marcospreafico/clas12Tags/ftOff.png

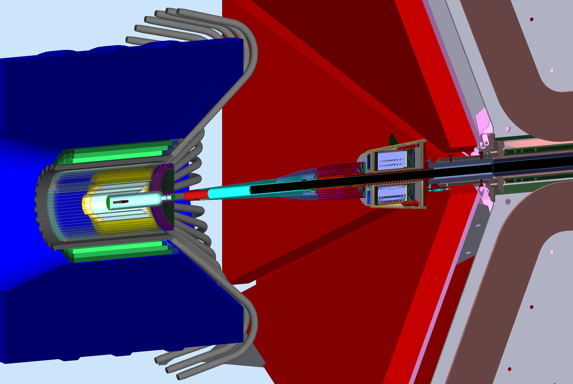
ftOff.png
