marcospreafico/clas12Tags/geometry_source/beamline/cad/torus_to_apex.png

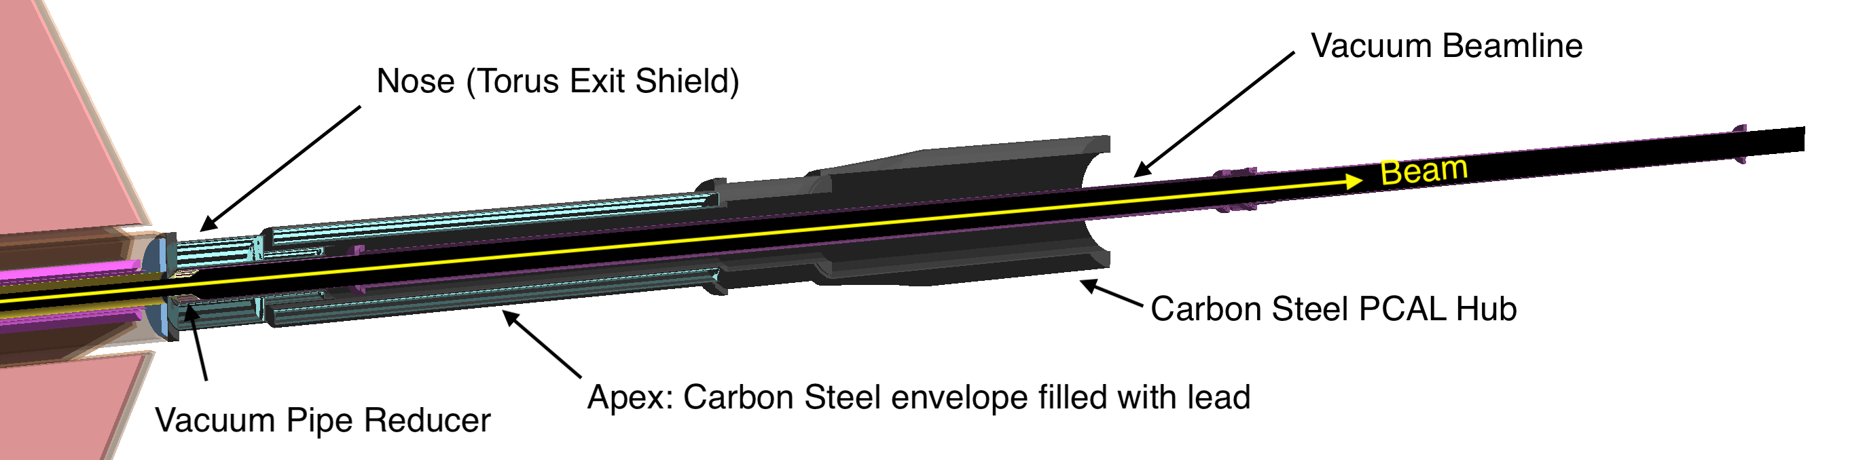
geometry_source/beamline/cad/torus_to_apex.png
