marcospreafico/clas12Tags/geometry_source/ltcc/docs/img/ltcc_mods.jpg

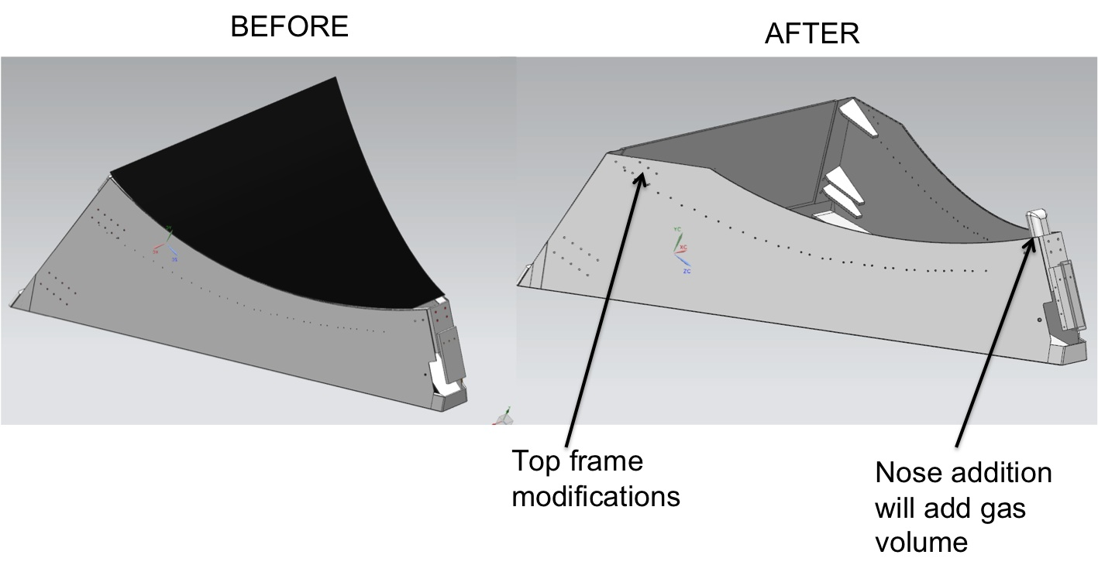
geometry_source/ltcc/docs/img/ltcc_mods.jpg
