marcospreafico/clas12Tags/geometry_source/ltcc/docs/img/photon_yield_gasc4f10_mirrorecis_pmtqtz.jpg

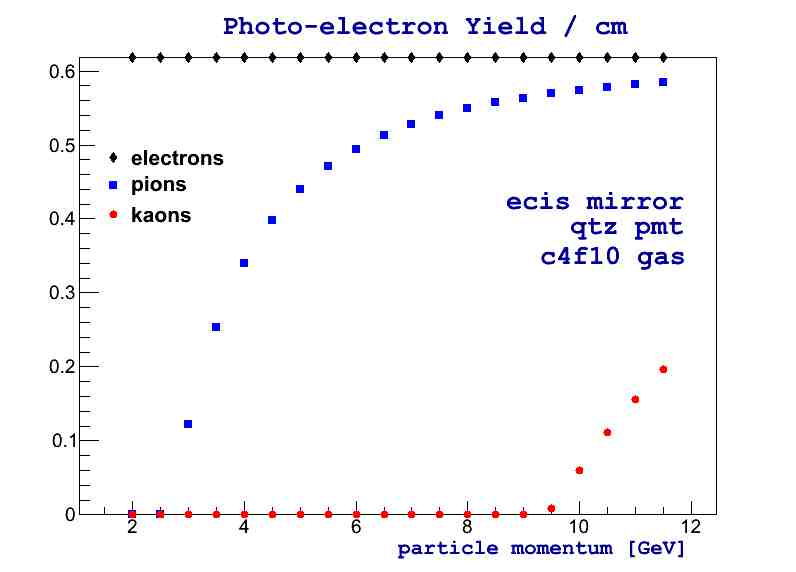
geometry_source/ltcc/docs/img/photon_yield_gasc4f10_mirrorecis_pmtqtz.jpg
