marcospreafico/clas12Tags/geometry_source/ltcc/docs/img/photon_yield_ratios_pion_gasc4f10_mirrorecis_pmtqtz.jpg

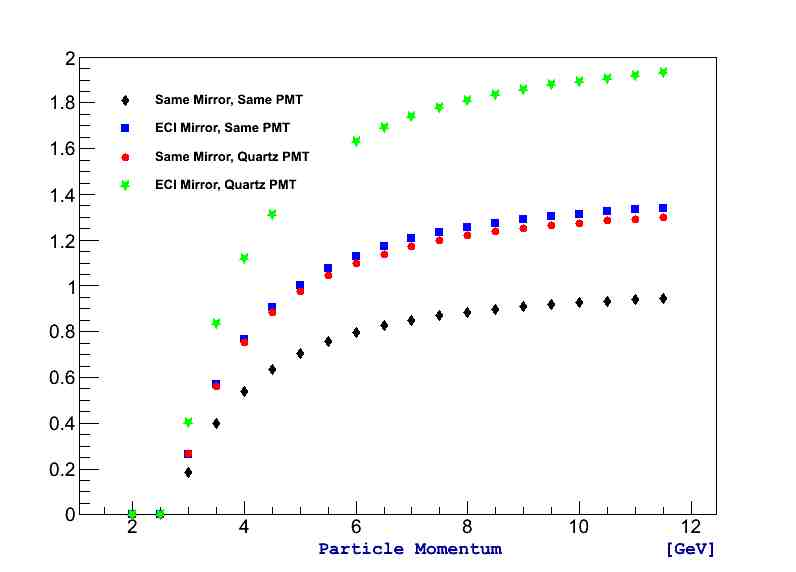
geometry_source/ltcc/docs/img/photon_yield_ratios_pion_gasc4f10_mirrorecis_pmtqtz.jpg
