marcospreafico/clas12Tags/geometry_source/ltcc/docs/img/photon_yield_spectrum_electron_gasc4f10_mirrorltcc_pmtuvg2.jpg

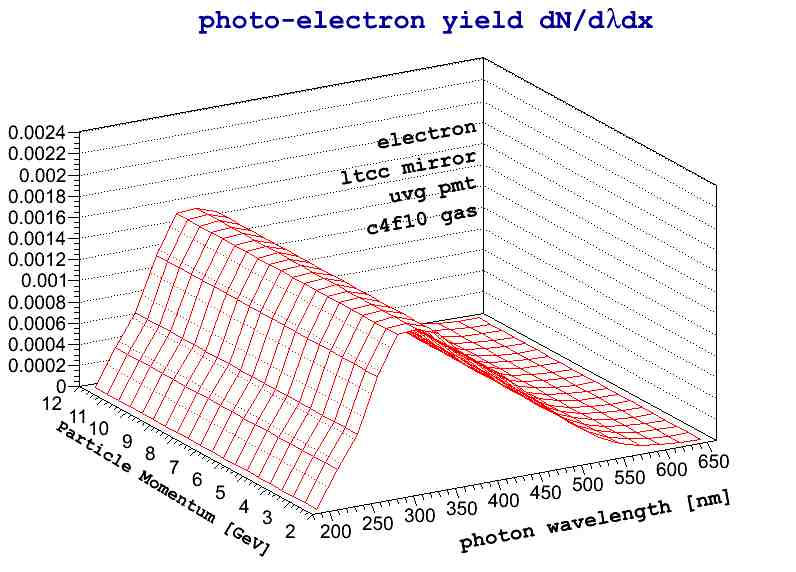
geometry_source/ltcc/docs/img/photon_yield_spectrum_electron_gasc4f10_mirrorltcc_pmtuvg2.jpg
