marcospreafico/clas12Tags/geometry_source/ltcc/docs/img/photon_yield_spectrum_electron_gasperfect_mirrorperfect_pmtperfect.jpg

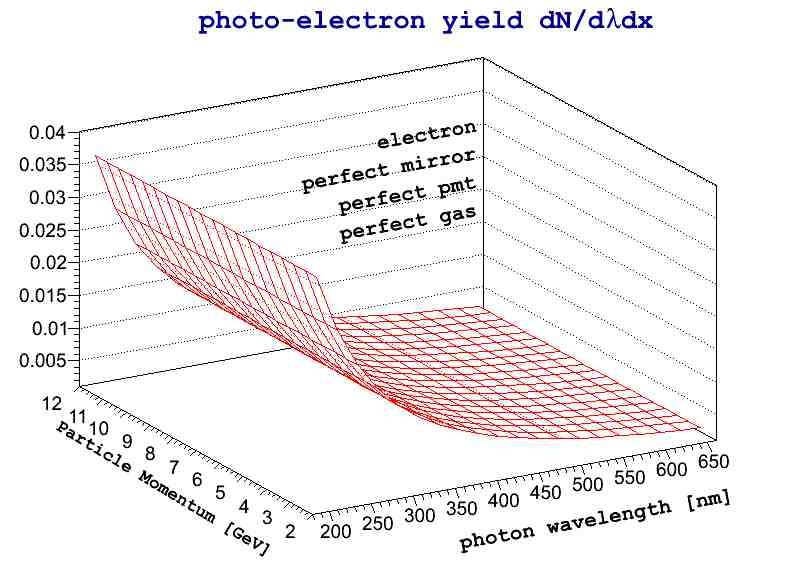
geometry_source/ltcc/docs/img/photon_yield_spectrum_electron_gasperfect_mirrorperfect_pmtperfect.jpg
