marcospreafico/clas12Tags/geometry_source/ltcc/docs/img/photon_yield_spectrum_pion_gasc4f10_mirrorecis_pmtuvg.jpg

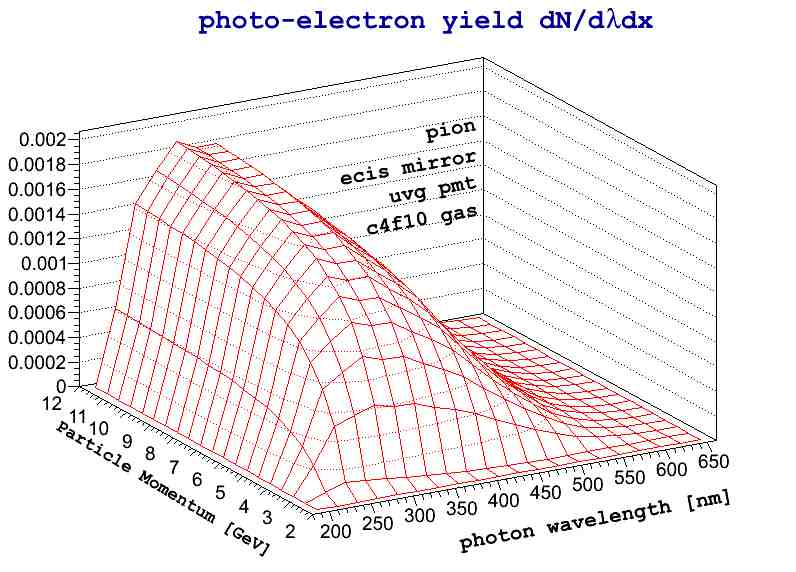
geometry_source/ltcc/docs/img/photon_yield_spectrum_pion_gasc4f10_mirrorecis_pmtuvg.jpg
