marcospreafico/clas12Tags/geometry_source/ltcc/docs/img/photon_yield_spectrum_pion_gasperfect_mirrorperfect_pmtperfect.jpg

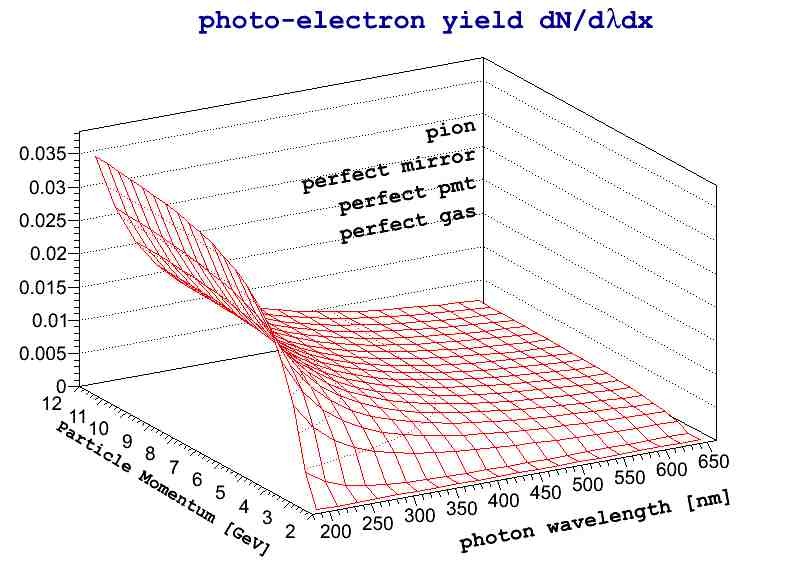
geometry_source/ltcc/docs/img/photon_yield_spectrum_pion_gasperfect_mirrorperfect_pmtperfect.jpg
