marcospreafico/clas12Tags/geometry_source/ltcc/docs/img/quantum_efficiency.jpg

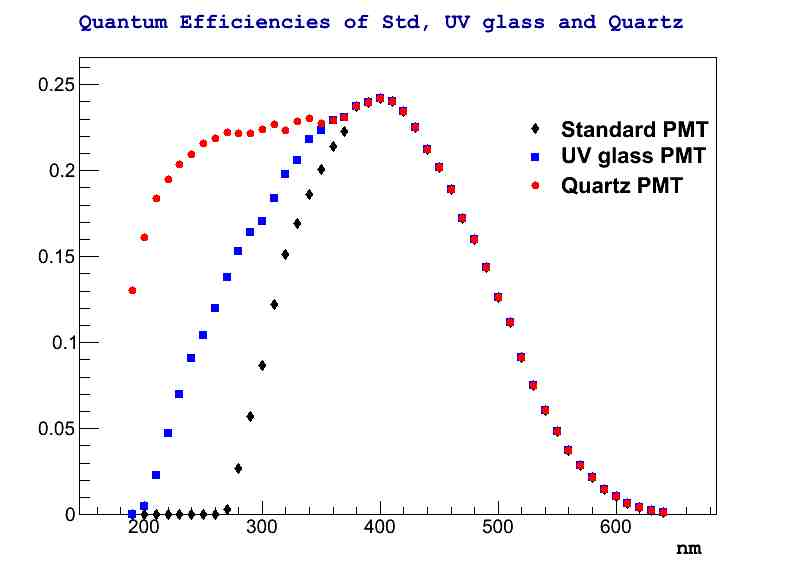
geometry_source/ltcc/docs/img/quantum_efficiency.jpg
