marcospreafico/clas12Tags/geometry_source/ltcc/docs/img/reflectivity.jpg

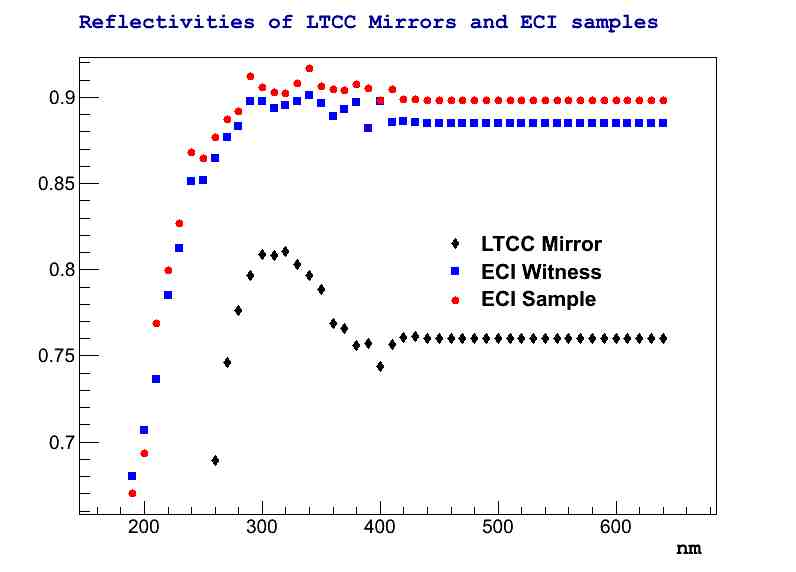
geometry_source/ltcc/docs/img/reflectivity.jpg
