marcospreafico/clas12Tags/geometry_source/ltcc/docs/img/refraction_index.jpg

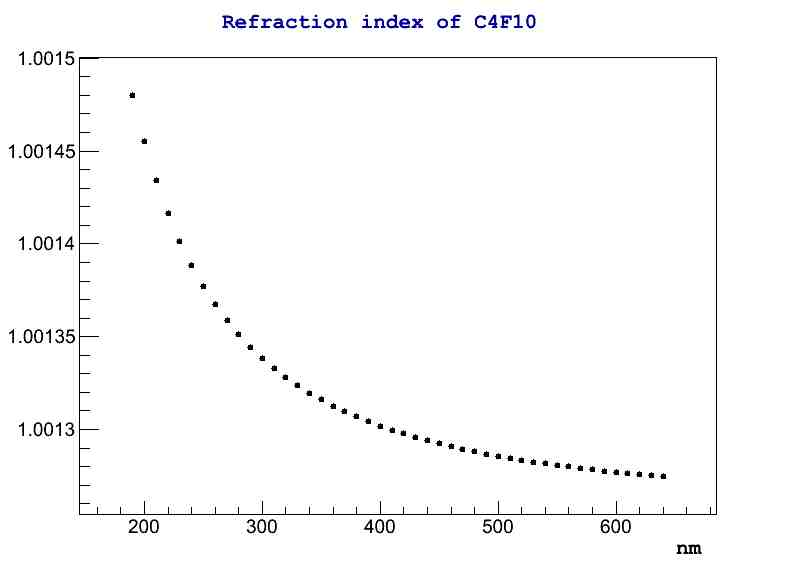
geometry_source/ltcc/docs/img/refraction_index.jpg
