marcospreafico/clas12Tags/geometry_source/ltcc/docs/img/window_addition_gain.jpg

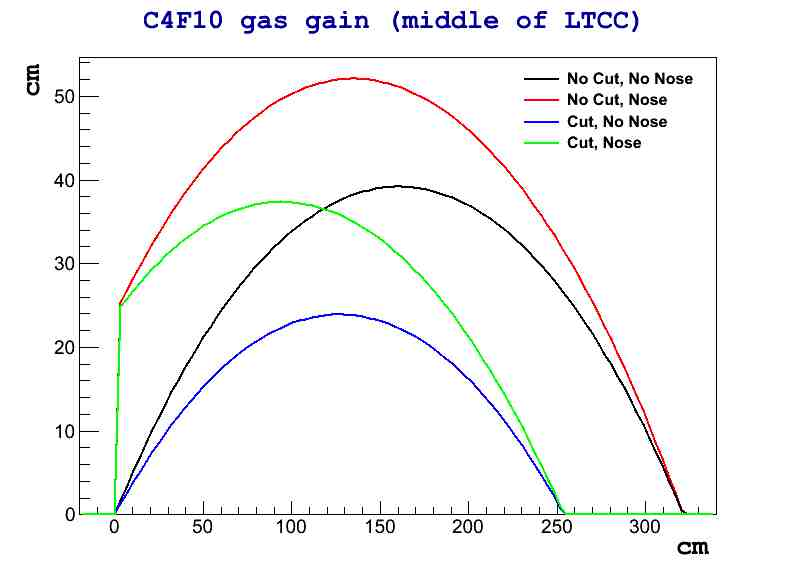
geometry_source/ltcc/docs/img/window_addition_gain.jpg
