marcospreafico/clas12Tags/geometry_source/targets/windows.png

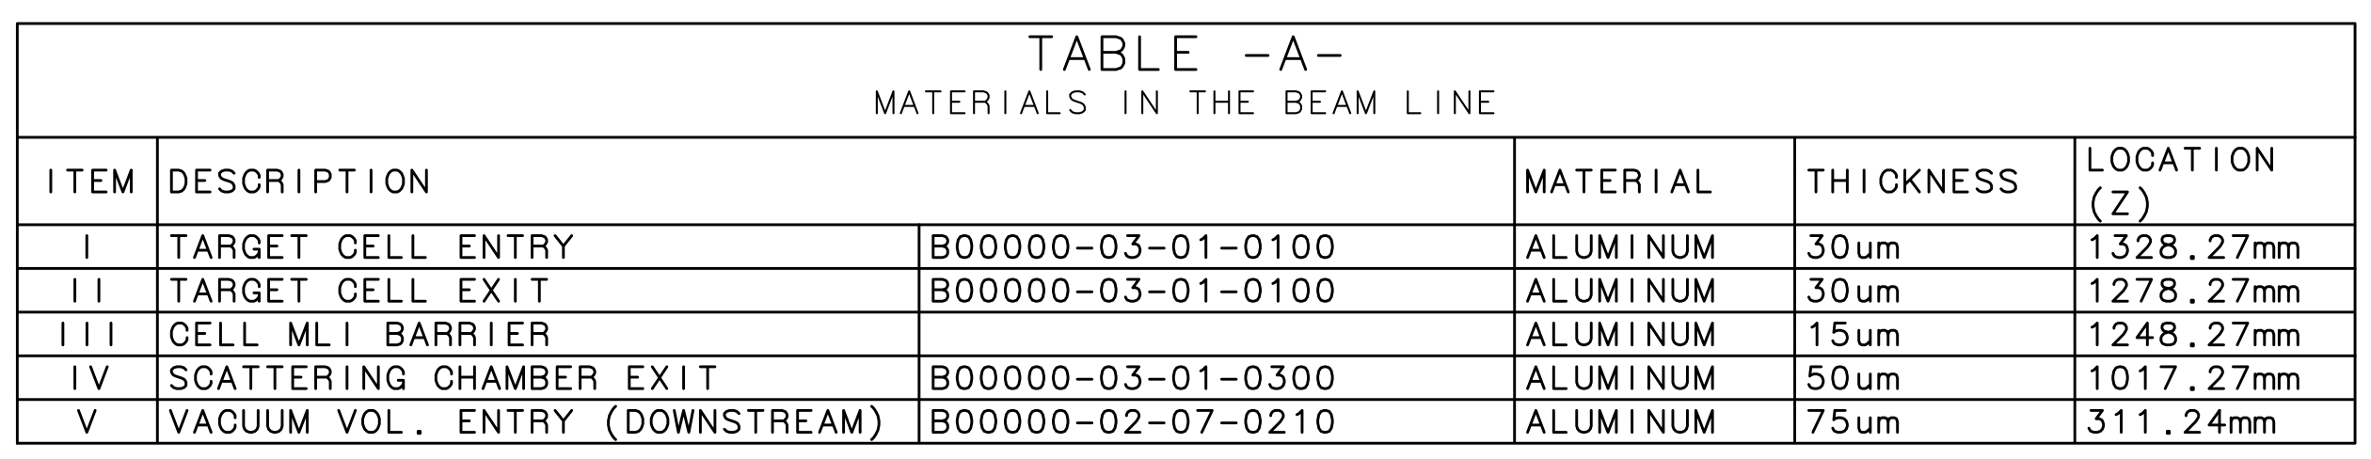
geometry_source/targets/windows.png
