marcospreafico/clas12Tags/geometry_source/targets/cad_rgd/eg2p_main_rode.stl

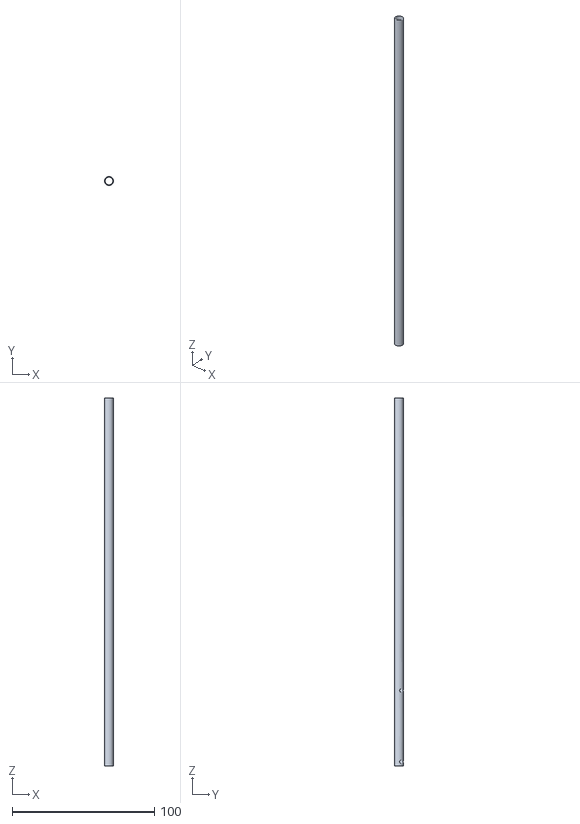
[picture p28: CAD file, 2024-06-17]
geometry_source/targets/cad_rgd/eg2p_main_rode.stl
6.35 x 6.35 x 258.4
