marcospreafico/clas12Tags/geometry_source/beamline/cad/flange-assembly.stl

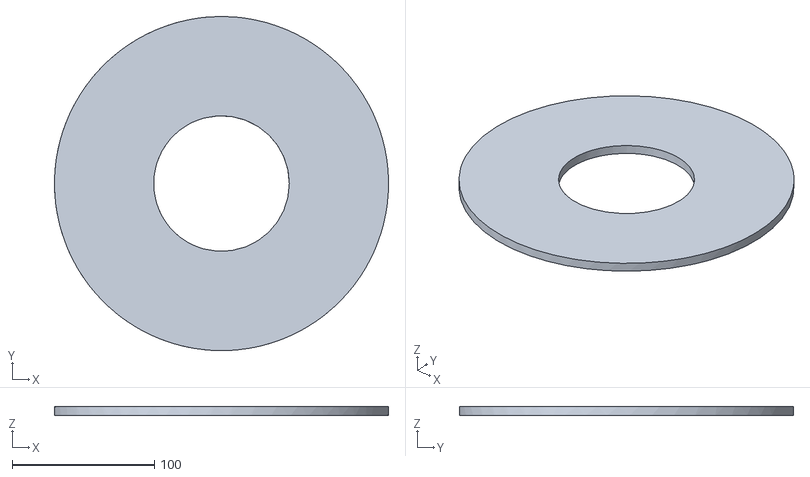
[picture p29: CAD file, 2023-02-14]
geometry_source/beamline/cad/flange-assembly.stl
234.7 x 234.7 x 6.35
