marcospreafico/clas12Tags/geometry_source/beamline/cad/outer-assembly.stl

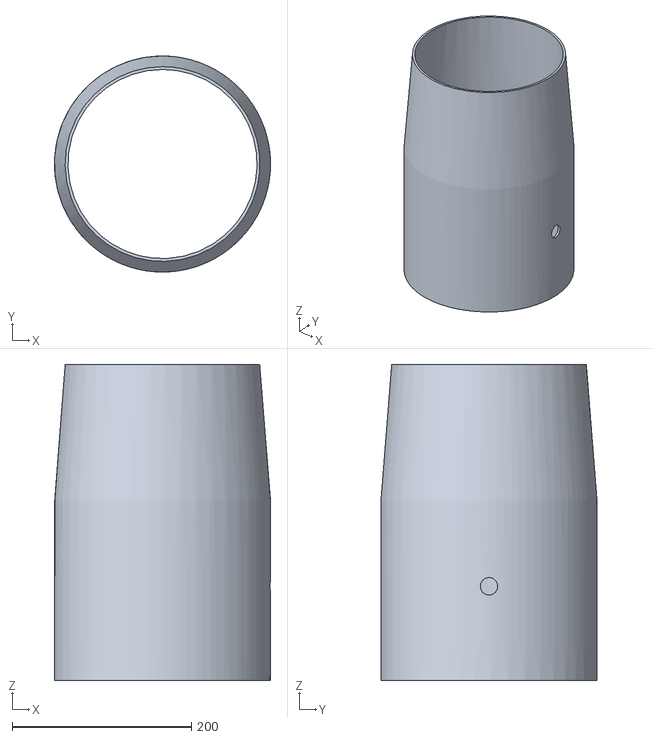
[picture p30: CAD file, 2023-02-14]
geometry_source/beamline/cad/outer-assembly.stl
241.1 x 241.1 x 352.5
