marcospreafico/clas12Tags/geometry_source/beamline/cad/main-cone.stl

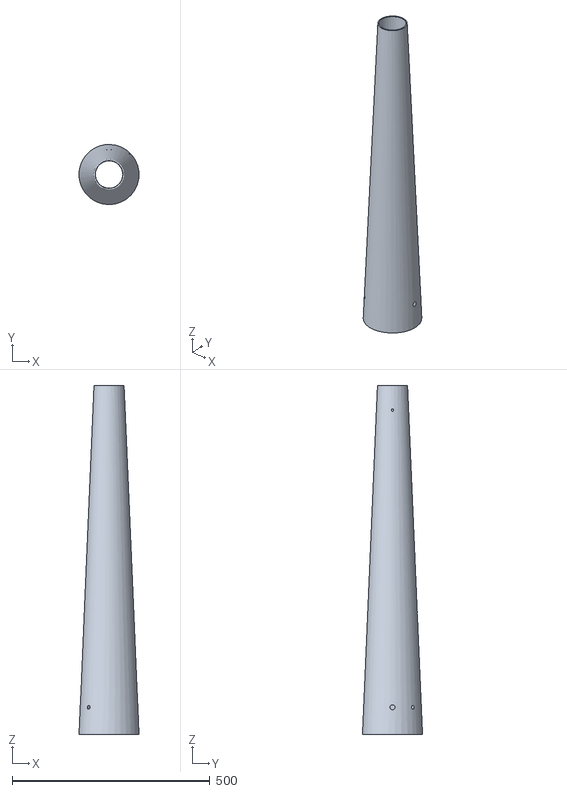
[picture p31: CAD file, 2023-02-14]
geometry_source/beamline/cad/main-cone.stl
151.9 x 152.1 x 882.6
