marcospreafico/clas12Tags/geometry_source/beamline/cad/inner-assembly.stl

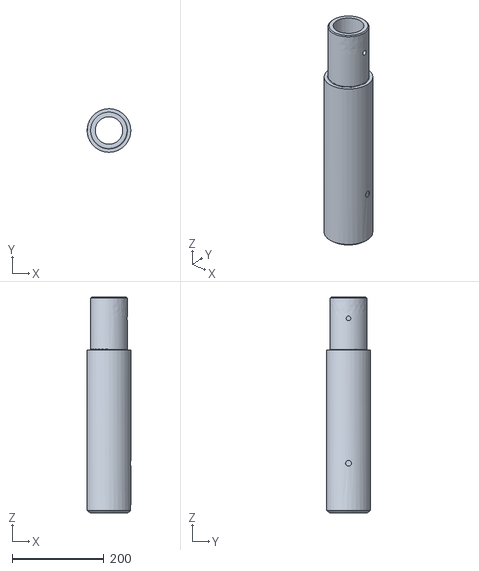
[picture p32: CAD file, 2023-02-14]
geometry_source/beamline/cad/inner-assembly.stl
95.2 x 95.2 x 471.0
