marcospreafico/clas12Tags/experiments/atlas/cad/LargeOuterWheel.stl

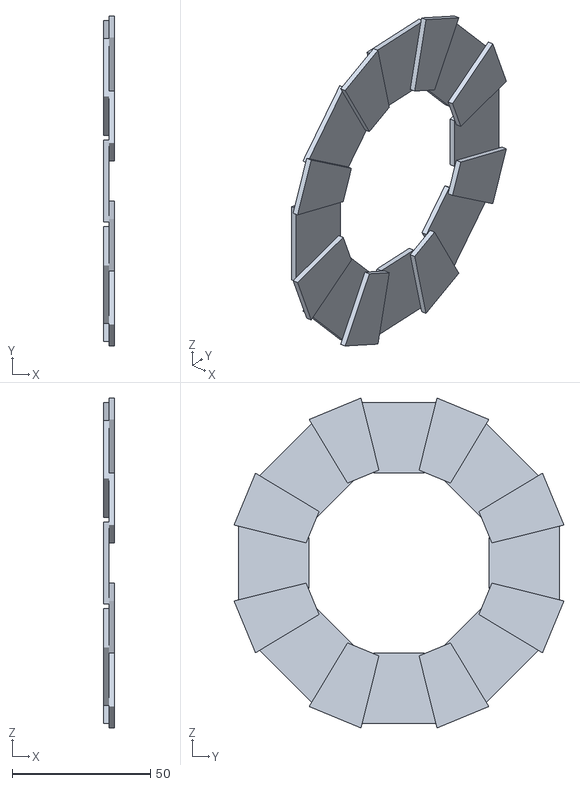
[picture p33: CAD file, 2023-02-14]
experiments/atlas/cad/LargeOuterWheel.stl
4.00 x 119.3 x 119.3
