marcospreafico/clas12Tags/experiments/clas12/ctof/cad/lgd21.stl

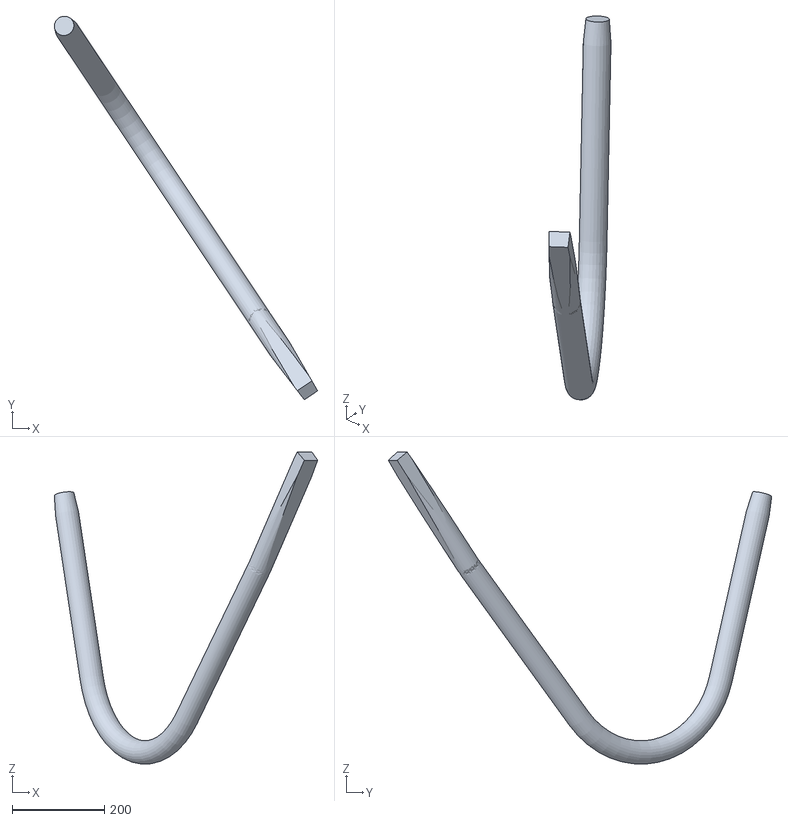
[picture p34: CAD file, 2023-02-14]
experiments/clas12/ctof/cad/lgd21.stl
571.5 x 832.3 x 677.2
