marcospreafico/clas12Tags/experiments/clas12/ctof/cad_upstream/lgu44.stl

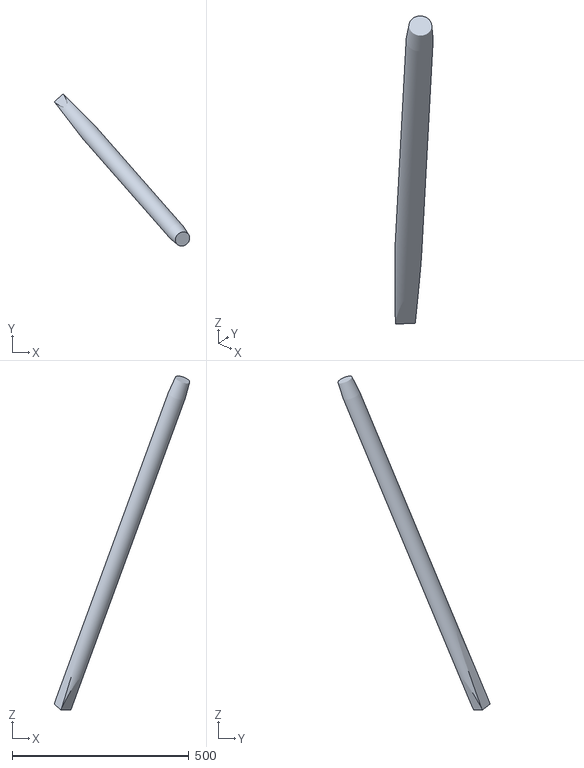
[picture p35: CAD file, 2023-02-14]
experiments/clas12/ctof/cad_upstream/lgu44.stl
383.6 x 430.8 x 945.6
