marcospreafico/clas12Tags/experiments/clas12/rich/cad/Aluminum_m2.stl

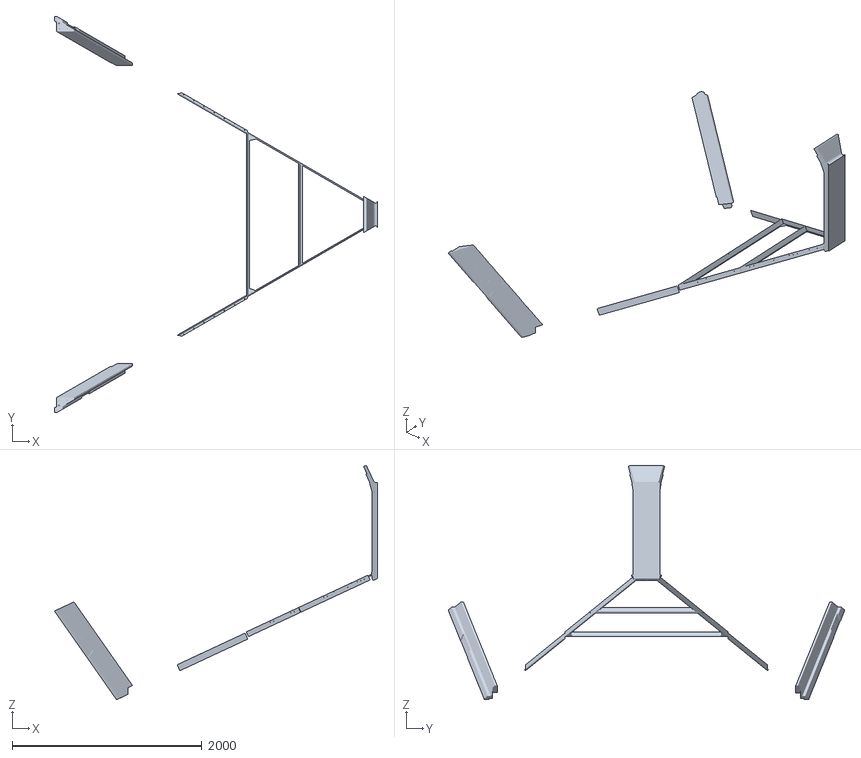
[picture p36: CAD file, 2024-01-29]
experiments/clas12/rich/cad/Aluminum_m2.stl
3408.2 x 4174.8 x 2471.6
