marcospreafico/clas12Tags/experiments/clas12/targets/cad_longitudinal/he3.stl

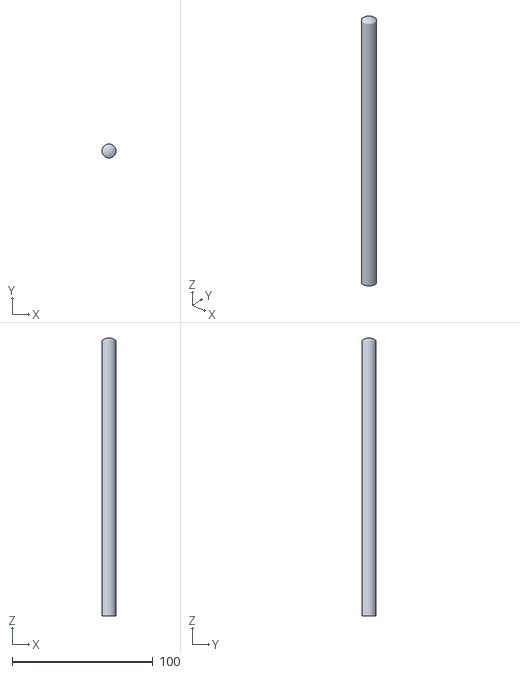
[picture p37: CAD file, 2023-02-14]
experiments/clas12/targets/cad_longitudinal/he3.stl
10.0 x 9.98 x 197.5
