marcospreafico/clas12Tags/experiments/forFun/cad/truck.stl

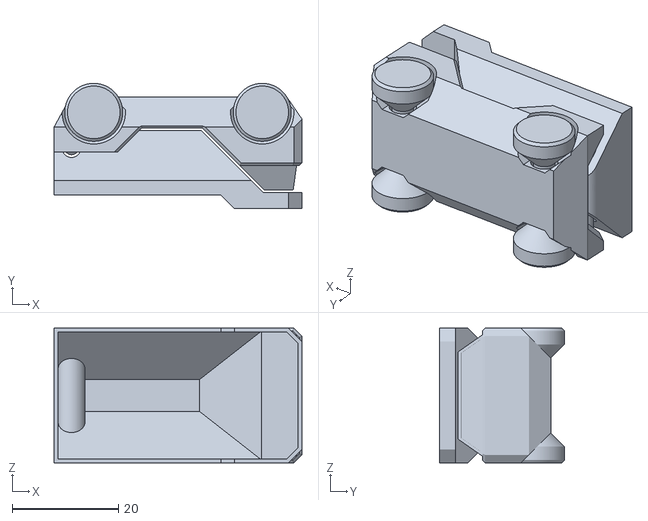
[picture p38: CAD file, 2023-02-14]
experiments/forFun/cad/truck.stl
46.7 x 23.6 x 25.4
