marcospreafico/clas12Tags/experiments/humanBody/cad/Upper_GI.stl

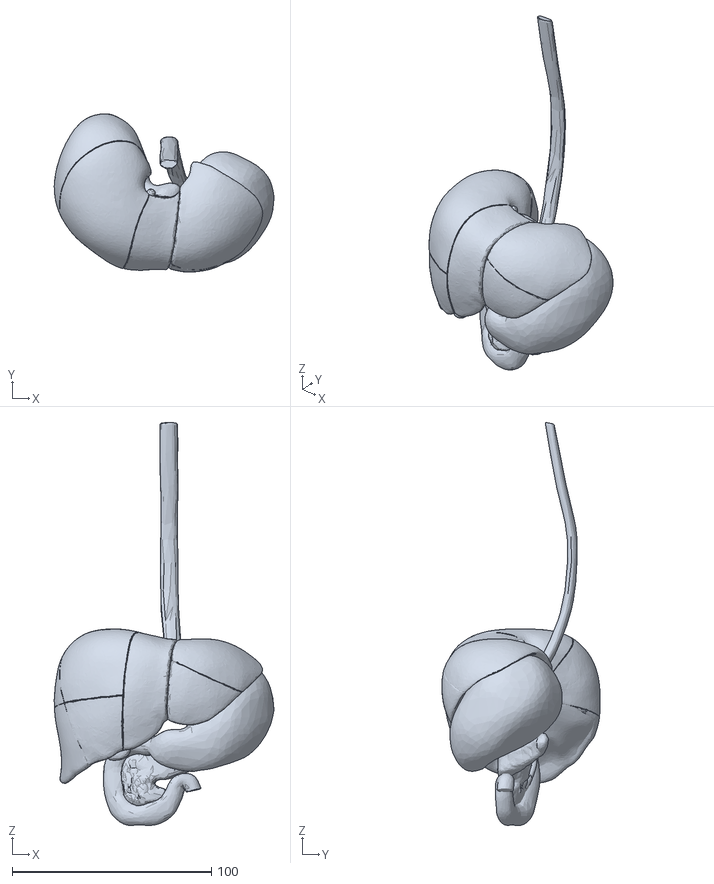
[picture p39: CAD file, 2023-02-14]
experiments/humanBody/cad/Upper_GI.stl
110.3 x 79.5 x 202.4
