marcospreafico/clas12Tags/geometry_source/beamline/cad/Downstream_Beam_tube_Segment_2.stl

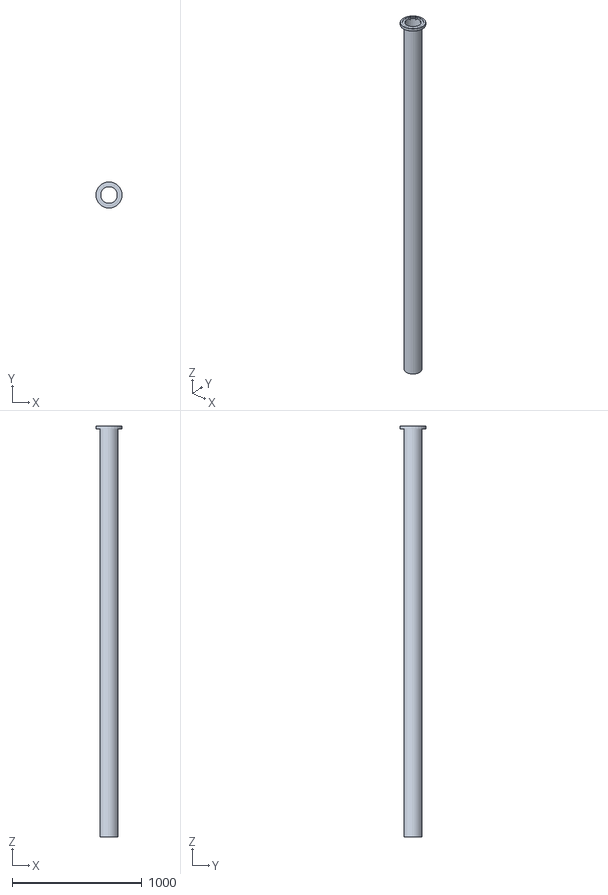
[picture p40: CAD file, 2024-09-16]
geometry_source/beamline/cad/Downstream_Beam_tube_Segment_2.stl
201.4 x 201.4 x 3172.5
