marcospreafico/clas12Tags/geometry_source/beamline/cad_transverse/forwardWedges/TGT-9000-1000-0001m.stl

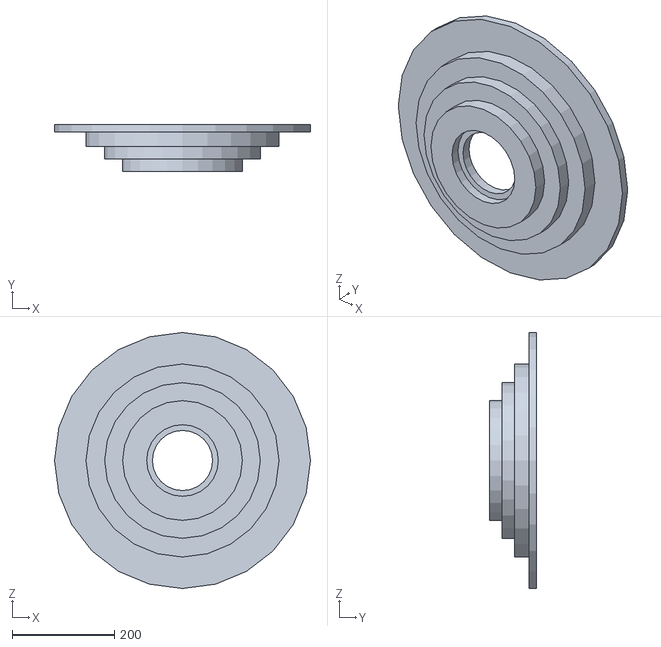
[picture p41: CAD file, 2024-09-16]
geometry_source/beamline/cad_transverse/forwardWedges/TGT-9000-1000-0001m.stl
500.0 x 92.0 x 500.0
