marcospreafico/clas12Tags/geometry_source/beamline/cad_transverse/midpointWedges/TGT-9000-1000-0000m.stl

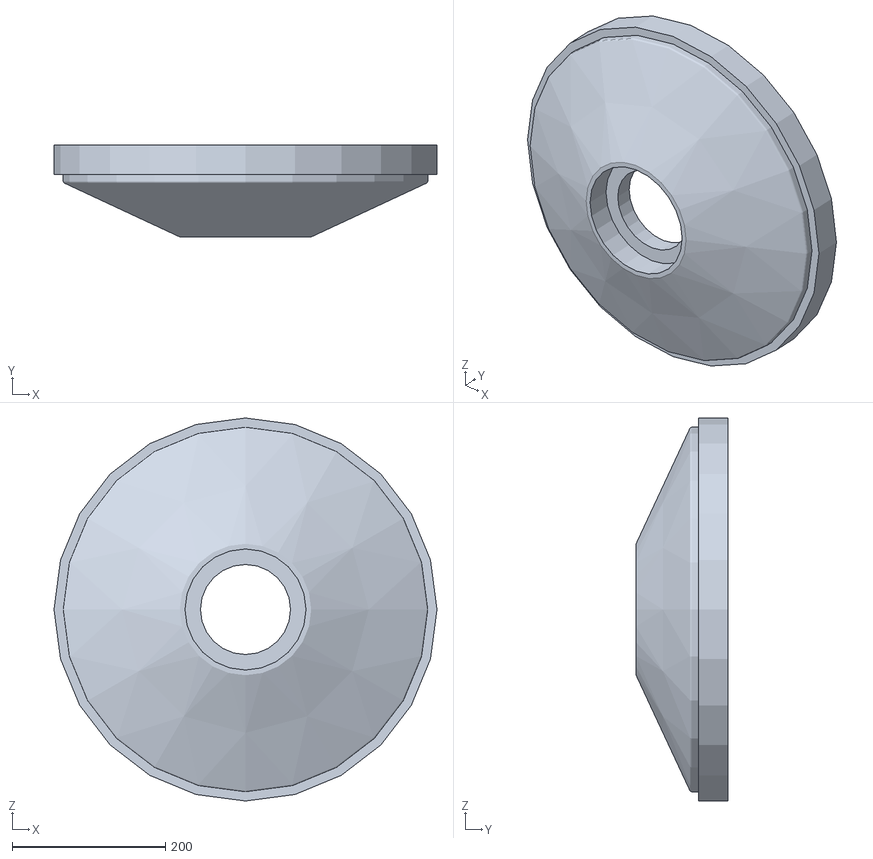
[picture p42: CAD file, 2024-09-16]
geometry_source/beamline/cad_transverse/midpointWedges/TGT-9000-1000-0000m.stl
500.0 x 120.0 x 500.0
