marcospreafico/clas12Tags/geometry_source/beamline/cad_transverse/noWedges/TransverseMagnetNoWedges.stp

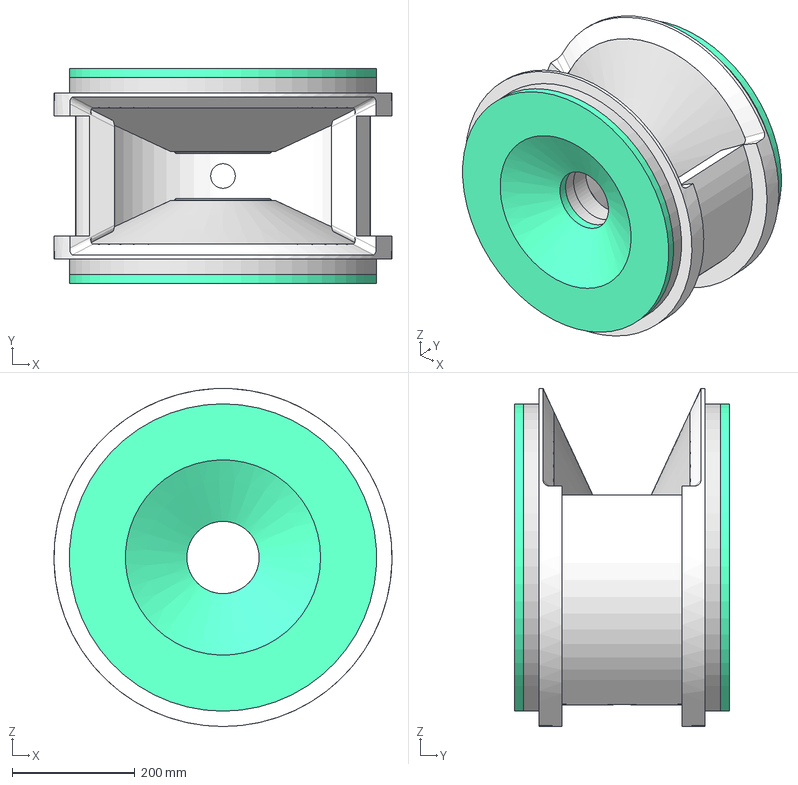
[picture p43: CAD file, 2024-09-16]
geometry_source/beamline/cad_transverse/noWedges/TransverseMagnetNoWedges.stp
549.9 x 350.0 x 550.0 mm
TGT-9000-1000-0000
TGT-9000-1000-0001
TGT-9000-1000-0002
TGT-9000-1000-0003
TGT-9000-1000-0000_MIR
TGT-9000-1000-0001_MIR1
TGT-9000-1000-0002_MIR1
