marcospreafico/clas12Tags/geometry_source/ddvcs/cad/ddvcs_cal.FCStd

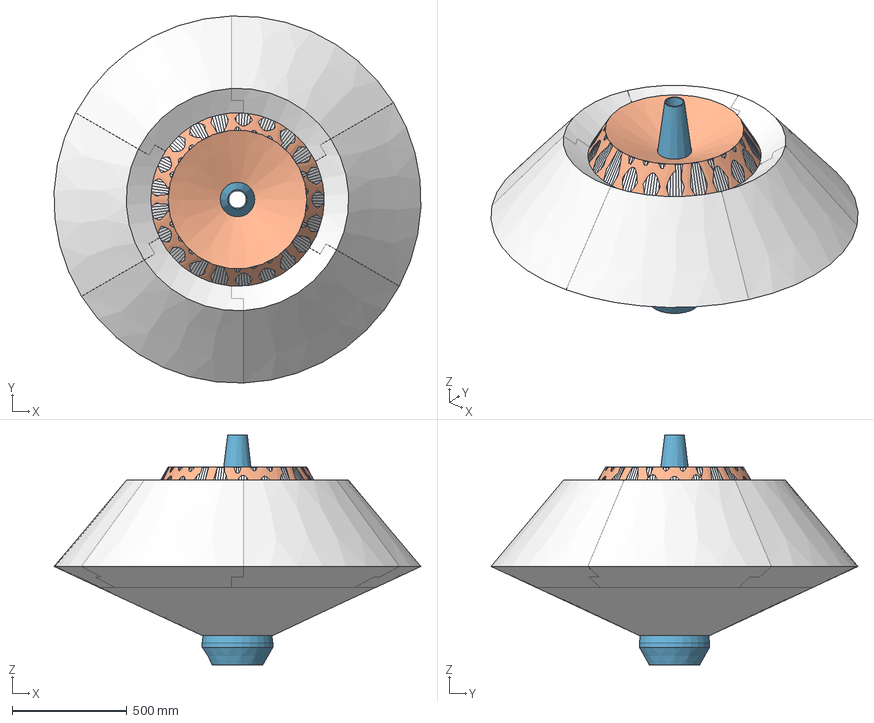
[picture p44: CAD file, 2023-02-24]
geometry_source/ddvcs/cad/ddvcs_cal.FCStd
1595.6 x 1596.3 x 998.3 mm
layout_calorimeter
crystal_array_four
crystal_segment_three
crystal_segment_two
crystal_segment_one
crystal_segment_one001
crystal_segment_one002
crystal_segment_one003
crystal_segment_one004
crystal_segment_one005
crystal_segment_one006
crystal_segment_one007
crystal_segment_one008
crystal_segment_one009
crystal_segment_one010
crystal_segment_one011
crystal_segment_one012
crystal_segment_one013
crystal_segment_one014
crystal_segment_one015
crystal_segment_one016
crystal_segment_one017
crystal_segment_one018
crystal_segment_one019
crystal_segment_one020
crystal_segment_one021
crystal_segment_one022
crystal_segment_one023
crystal_segment_one024
crystal_segment_one025
crystal_segment_one026
crystal_segment_one027
crystal_segment_one028
crystal_segment_one029
crystal_segment_one030
crystal_segment_one031
crystal_segment_one032
crystal_segment_one033
crystal_segment_one034
crystal_segment_one035
crystal_segment_one036
crystal_segment_one037
crystal_segment_one038
crystal_segment_one039
crystal_segment_one040
crystal_segment_one041
crystal_segment_one042
crystal_segment_one043
crystal_segment_one044
crystal_segment_one045
crystal_segment_one046
crystal_segment_one047
crystal_segment_one048
crystal_segment_one049
crystal_segment_one050
crystal_segment_one051
crystal_segment_one052
crystal_segment_one053
crystal_segment_one054
crystal_segment_one055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
