marcospreafico/clas12Tags/geometry_source/htcc/cad/htccCone.stl

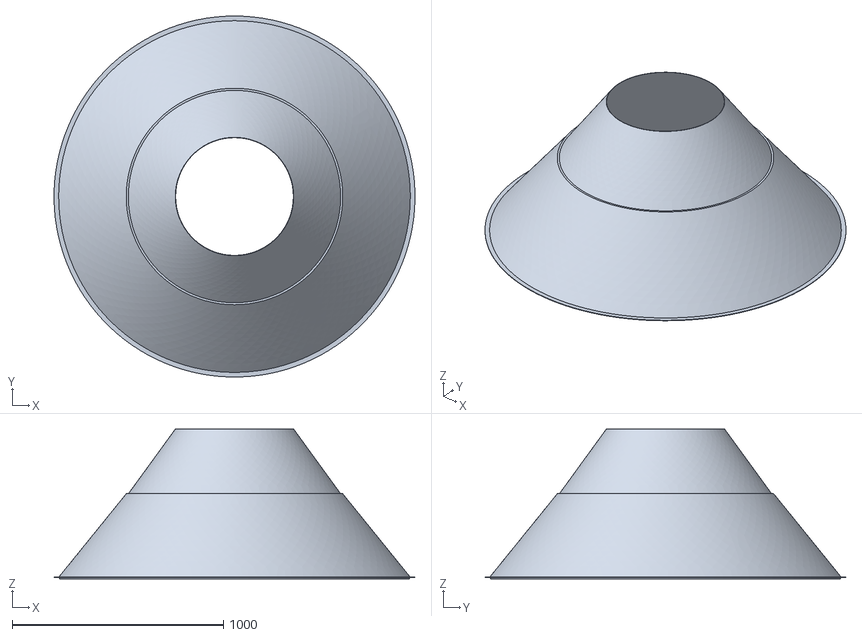
[picture p45: CAD file, 2023-02-14]
geometry_source/htcc/cad/htccCone.stl
1708.0 x 1707.9 x 708.9
