marcospreafico/clas12Tags/geometry_source/ltcc/cad/WC_S.stl

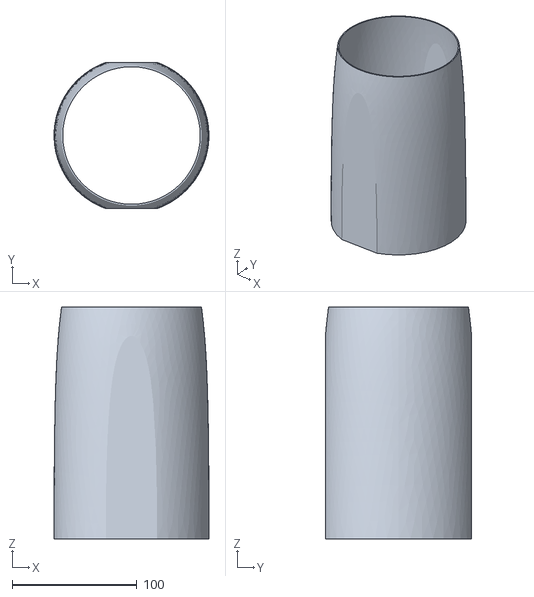
[picture p46: CAD file, 2023-02-14]
geometry_source/ltcc/cad/WC_S.stl
124.0 x 117.0 x 185.6
