marcospreafico/clas12Tags/geometry_source/ltcc/cadTempRemoved/NFrame.stl

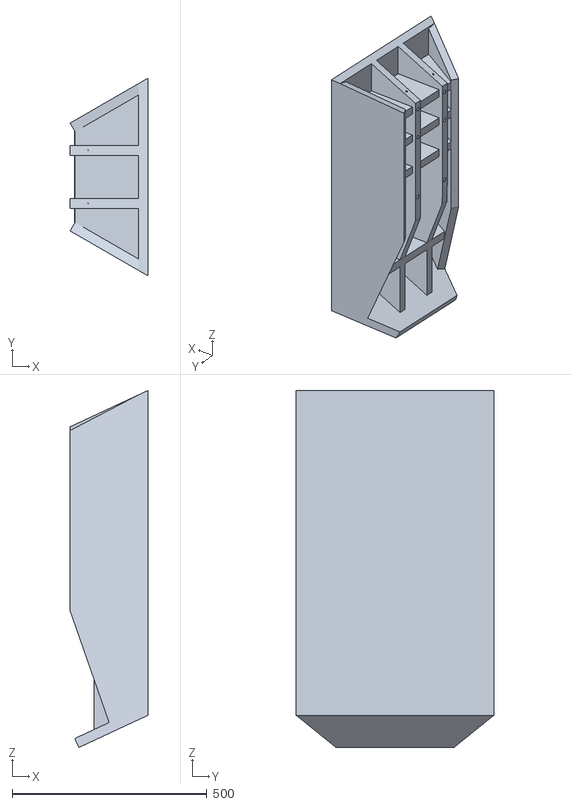
[picture p47: CAD file, 2023-02-14]
geometry_source/ltcc/cadTempRemoved/NFrame.stl
199.9 x 508.0 x 917.7
