marcospreafico/clas12Tags/geometry_source/magnets/cad/UpstreamVacuumJacket.stl

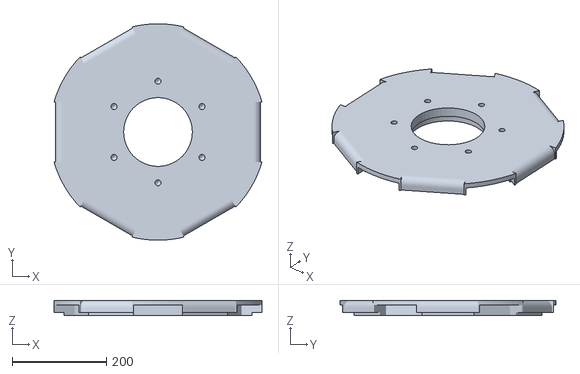
[picture p48: CAD file, 2023-02-14]
geometry_source/magnets/cad/UpstreamVacuumJacket.stl
442.1 x 459.8 x 31.8
