marcospreafico/clas12Tags/geometry_source/targets/cad/scatteringChamber.stl

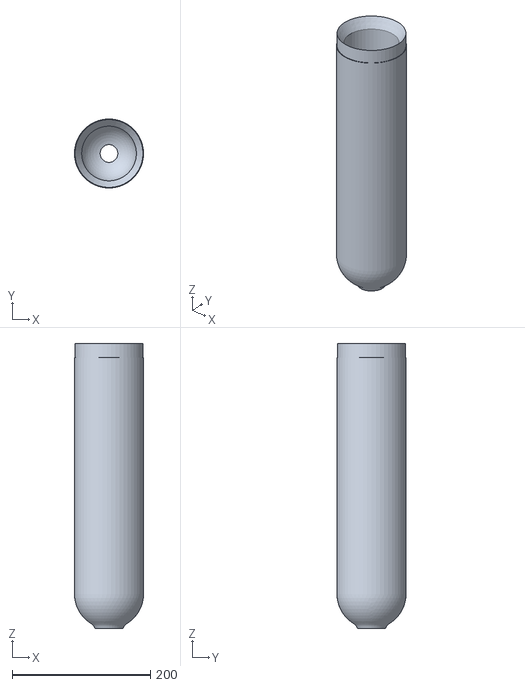
[picture p49: CAD file, 2023-02-14]
geometry_source/targets/cad/scatteringChamber.stl
100.0 x 99.8 x 412.4
