marcospreafico/clas12Tags/geometry_source/targets/cad_extended/TargetAlWindowD.stl

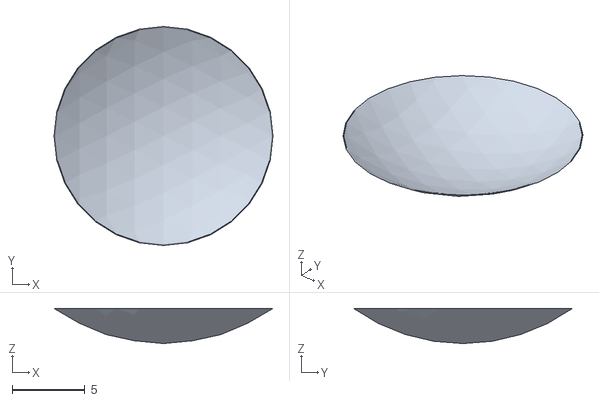
[picture p50: CAD file, 2023-02-14]
geometry_source/targets/cad_extended/TargetAlWindowD.stl
15.1 x 15.1 x 2.41
