marcospreafico/clas12Tags/geometry_source/targets/cad_hdice/LHeCan_PCTFE.stl

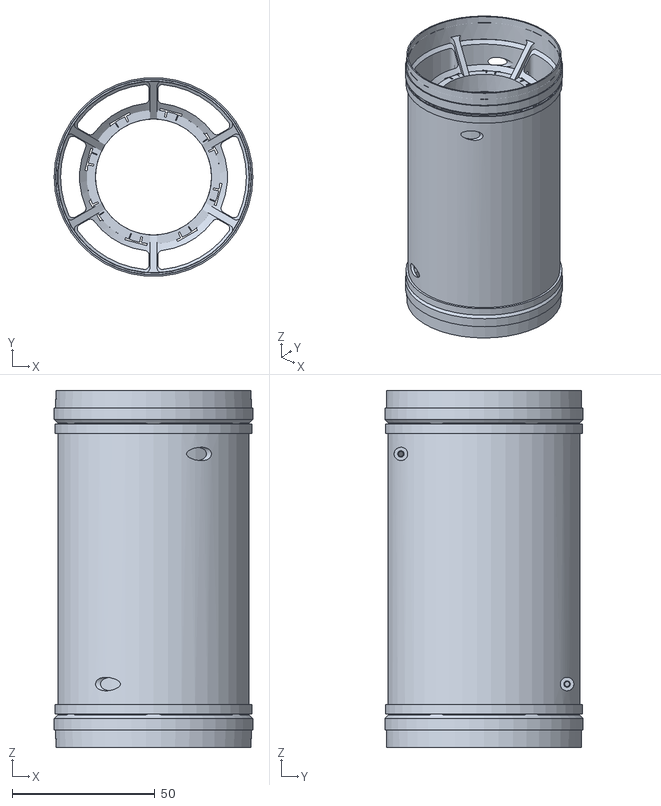
[picture p51: CAD file, 2023-02-14]
geometry_source/targets/cad_hdice/LHeCan_PCTFE.stl
69.6 x 69.4 x 125.0
