marcospreafico/clas12Tags/geometry_source/targets/cad_poltarg/InsertBath_NoVoid_6.stl

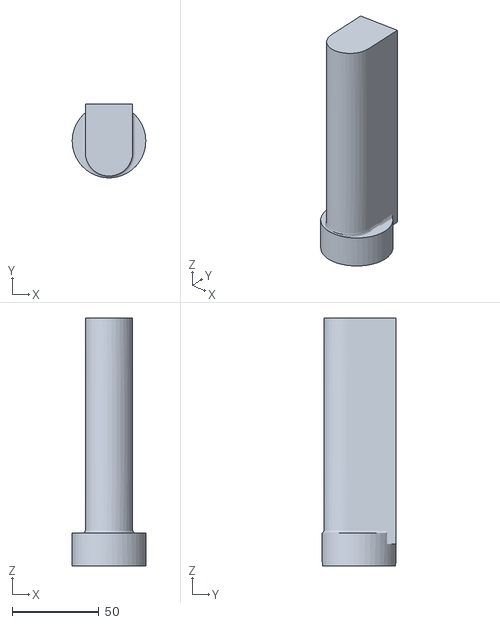
[picture p52: CAD file, 2023-02-14]
geometry_source/targets/cad_poltarg/InsertBath_NoVoid_6.stl
42.6 x 42.6 x 143.3
