marcospreafico/clas12Tags/geometry_source/targets/cad_transverse/InnerRSSheet.stl

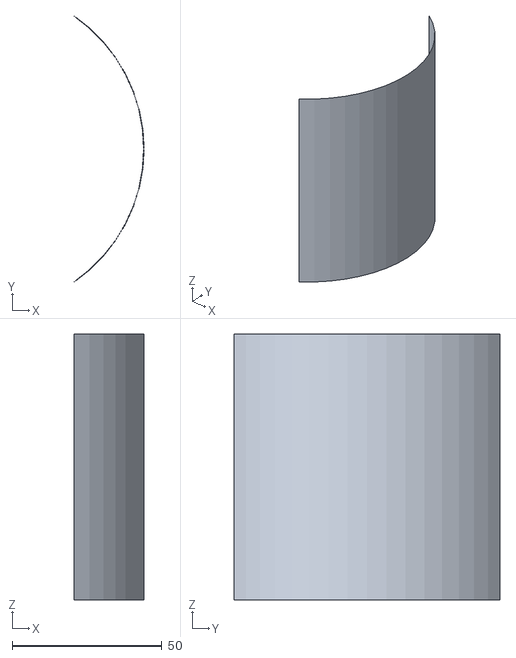
[picture p53: CAD file, 2023-02-14]
geometry_source/targets/cad_transverse/InnerRSSheet.stl
23.4 x 88.9 x 88.9
