marcospreafico/clas12Tags/geometry_source/targets/rge-dt/Al/Tin.stl

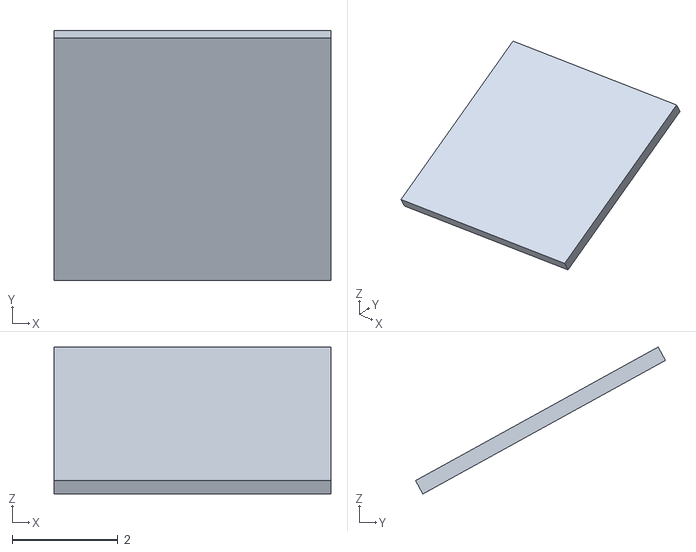
[picture p54: CAD file, 2024-10-23]
geometry_source/targets/rge-dt/Al/Tin.stl
5.25 x 4.74 x 2.79
