marcospreafico/clas12Tags/geometry_source/targets/rge-dt/C/Aluminum.stl

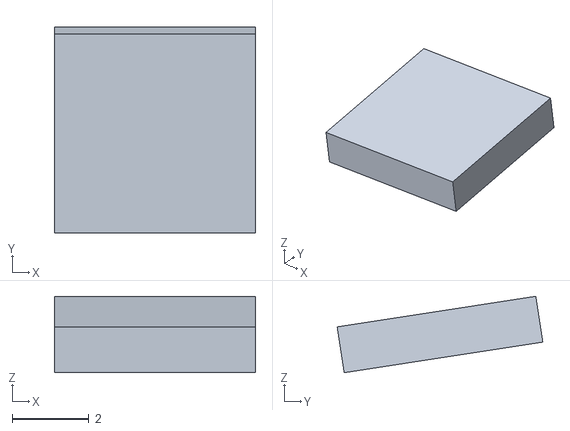
[picture p55: CAD file, 2024-10-23]
geometry_source/targets/rge-dt/C/Aluminum.stl
5.25 x 5.37 x 2.00
