marcospreafico/clas12Tags/geometry_source/targets/rge-dt/common/TargetWallKapton.stl

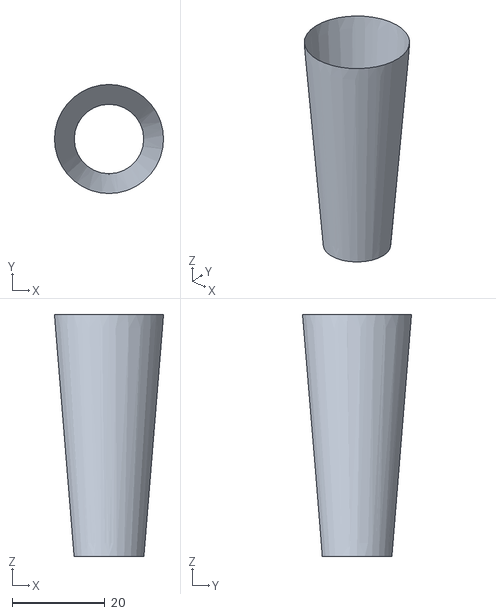
[picture p56: CAD file, 2024-10-23]
geometry_source/targets/rge-dt/common/TargetWallKapton.stl
23.5 x 23.5 x 52.2
