marcospreafico/clas12Tags/geometry_source/targets/rge-dt/Cu/Copper.stl

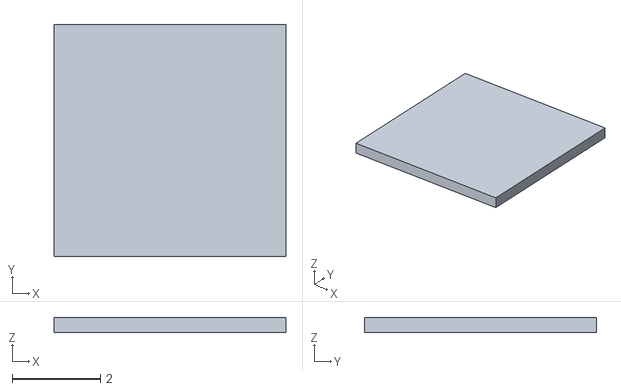
[picture p57: CAD file, 2024-10-23]
geometry_source/targets/rge-dt/Cu/Copper.stl
5.25 x 5.25 x 0.335
