marcospreafico/clas12Tags/geometry_source/targets/rge-dt/Empty/Tin.stl

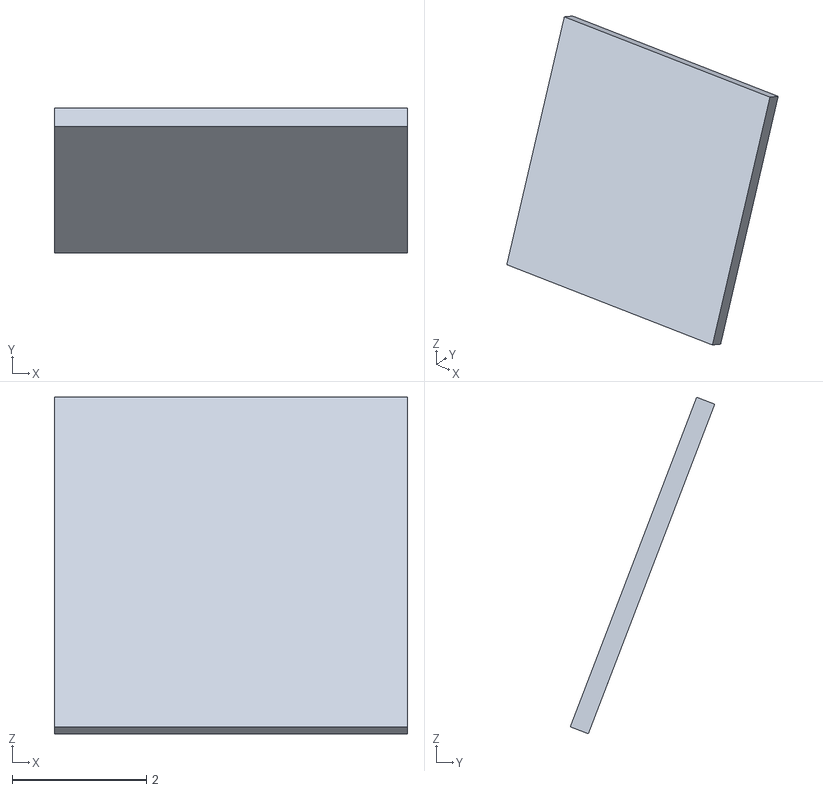
[picture p58: CAD file, 2024-10-23]
geometry_source/targets/rge-dt/Empty/Tin.stl
5.25 x 2.15 x 5.01
