marcospreafico/clas12Tags/geometry_source/targets/rge-dt/Pb/Lead.stl

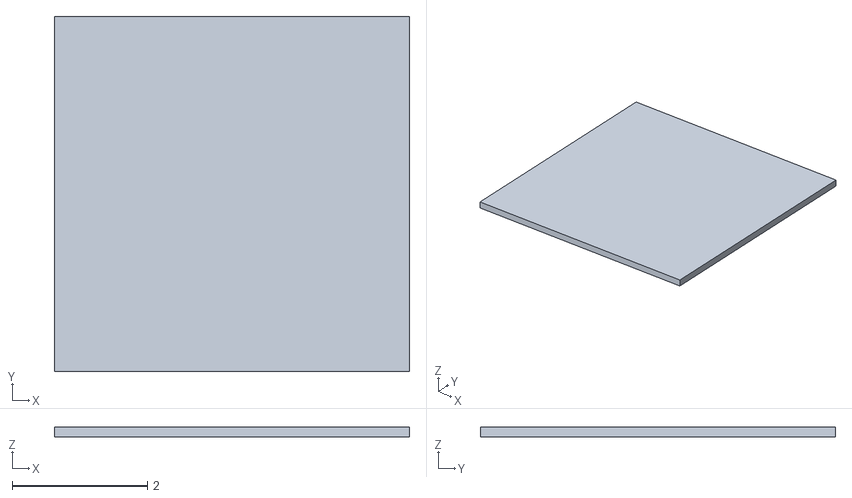
[picture p59: CAD file, 2024-10-23]
geometry_source/targets/rge-dt/Pb/Lead.stl
5.25 x 5.25 x 0.143
