marcospreafico/clas12Tags/geometry_source/targets/rge-dt/Sn/Copper.stl

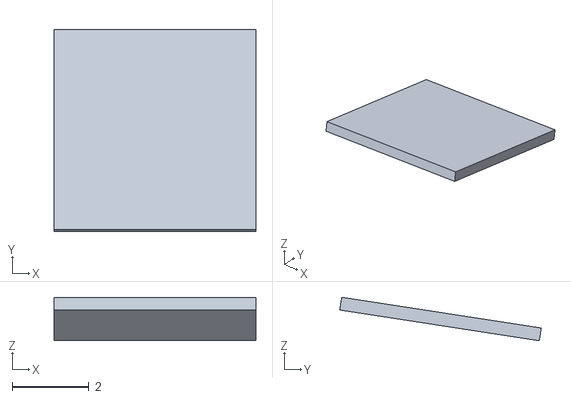
[picture p60: CAD file, 2024-10-23]
geometry_source/targets/rge-dt/Sn/Copper.stl
5.25 x 5.24 x 1.13
