marcospreafico/clas12Tags/experiments/atlas/cad/TRT.stl

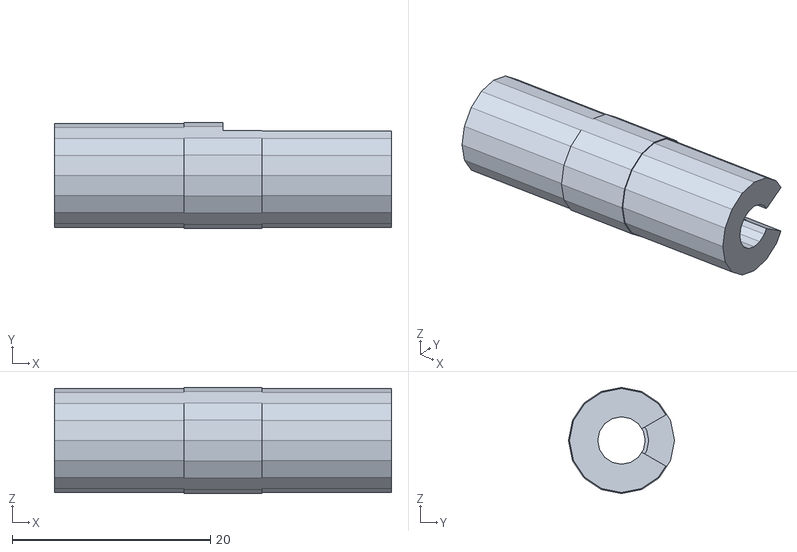
[picture p61: CAD file, 2023-02-14]
experiments/atlas/cad/TRT.stl
34.0 x 10.7 x 10.7
