marcospreafico/clas12Tags/experiments/clas12/ctof/cad/sc13.stl

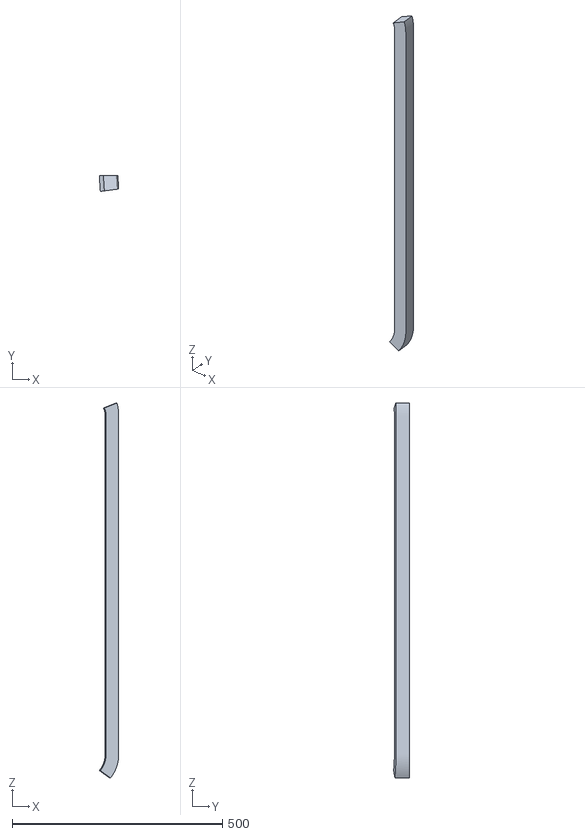
[picture p62: CAD file, 2023-02-14]
experiments/clas12/ctof/cad/sc13.stl
46.3 x 37.8 x 892.3
