marcospreafico/clas12Tags/experiments/clas12/ctof/cad_upstream/lgu22.stl

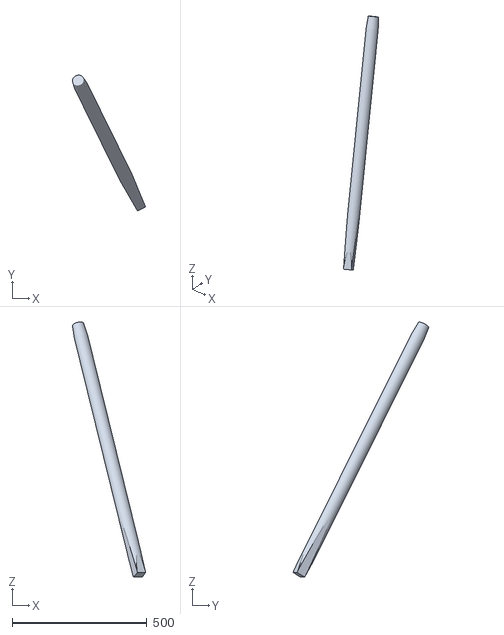
[picture p63: CAD file, 2023-02-14]
experiments/clas12/ctof/cad_upstream/lgu22.stl
271.2 x 503.7 x 945.6
