marcospreafico/clas12Tags/experiments/clas12/rich/cad/Layer_203_component_13_m2.stl

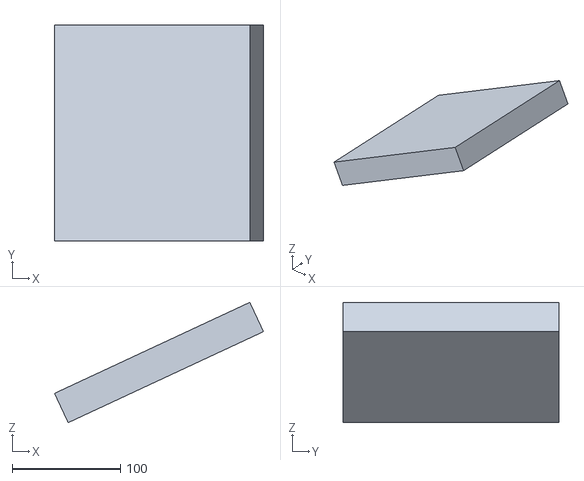
[picture p64: CAD file, 2024-01-29]
experiments/clas12/rich/cad/Layer_203_component_13_m2.stl
193.4 x 199.4 x 111.4
