marcospreafico/clas12Tags/experiments/clas12/targets/cad_longitudinal/flow_entrance.stl

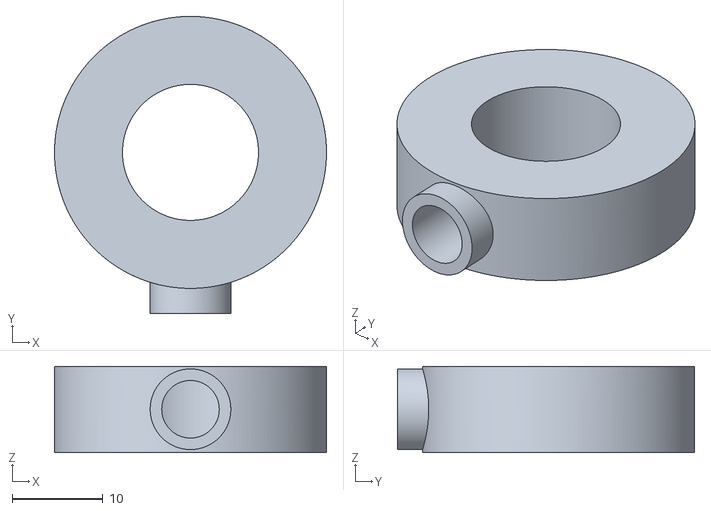
[picture p65: CAD file, 2023-02-14]
experiments/clas12/targets/cad_longitudinal/flow_entrance.stl
30.0 x 32.8 x 9.52
