marcospreafico/clas12Tags/experiments/forFun/cad/dragon.stl

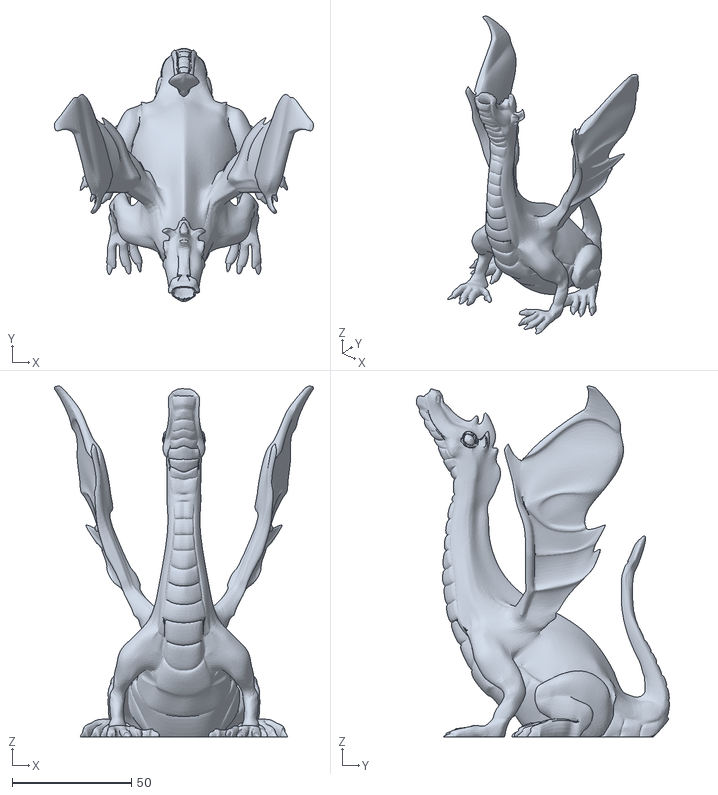
[picture p66: CAD file, 2023-02-14]
experiments/forFun/cad/dragon.stl
108.8 x 106.3 x 147.2
