marcospreafico/clas12Tags/experiments/humanBody/cad/Lower_GI.stl

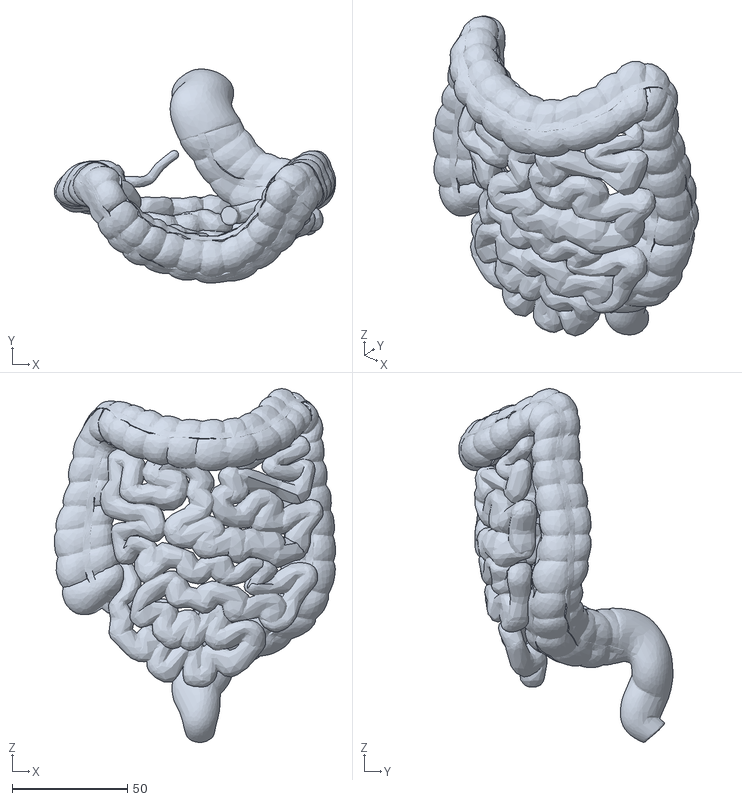
[picture p67: CAD file, 2023-02-14]
experiments/humanBody/cad/Lower_GI.stl
122.1 x 92.8 x 153.7
