marcospreafico/clas12Tags/geometry_source/beamline/cad/Apex_Shield_PCAL_Hub.stl

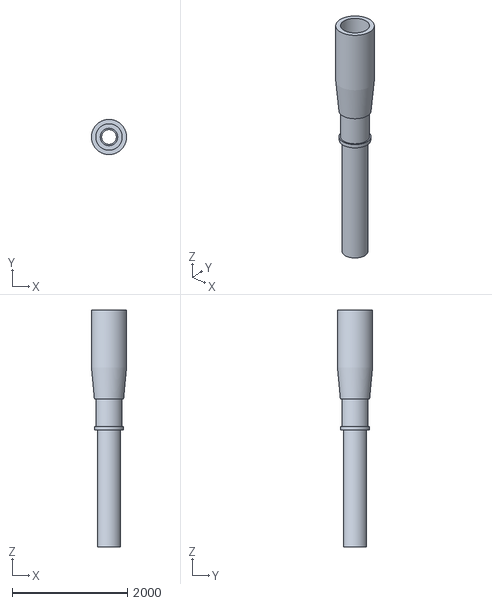
[picture p68: CAD file, 2024-09-16]
geometry_source/beamline/cad/Apex_Shield_PCAL_Hub.stl
609.6 x 609.6 x 4114.8
