marcospreafico/clas12Tags/geometry_source/beamline/cad_transverse/noWedges/TGT-9000-1000-0003m.stl

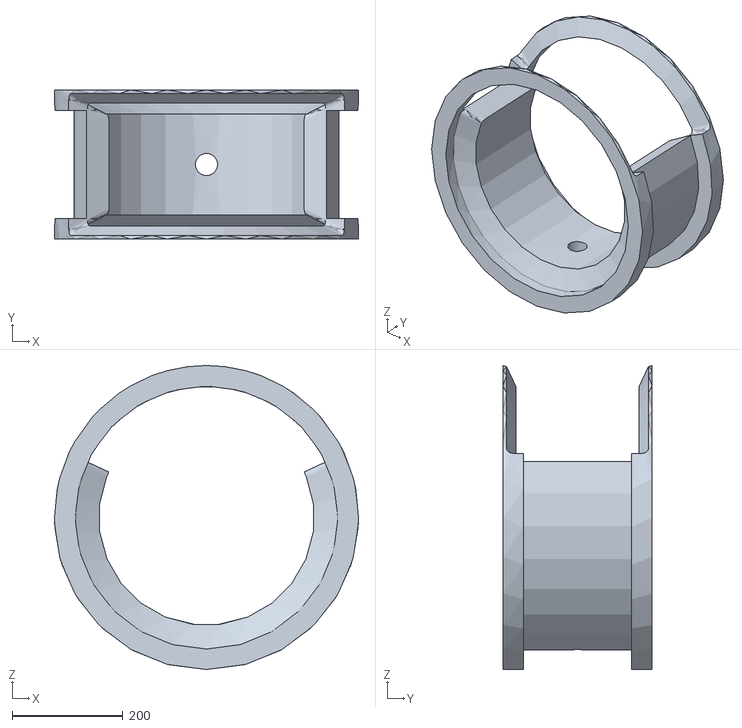
[picture p69: CAD file, 2024-09-16]
geometry_source/beamline/cad_transverse/noWedges/TGT-9000-1000-0003m.stl
550.0 x 270.0 x 550.0
