marcospreafico/clas12Tags/geometry_source/ddvcs/cad/crystal_shell.stl

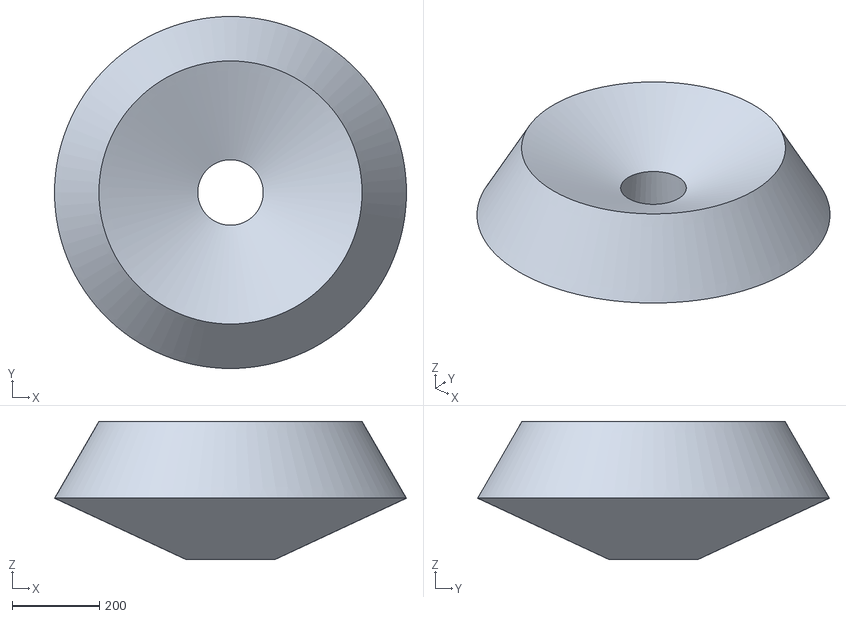
[picture p70: CAD file, 2023-02-24]
geometry_source/ddvcs/cad/crystal_shell.stl
807.5 x 807.5 x 317.7
