marcospreafico/clas12Tags/geometry_source/htcc/cad/htccMollerCone.stl

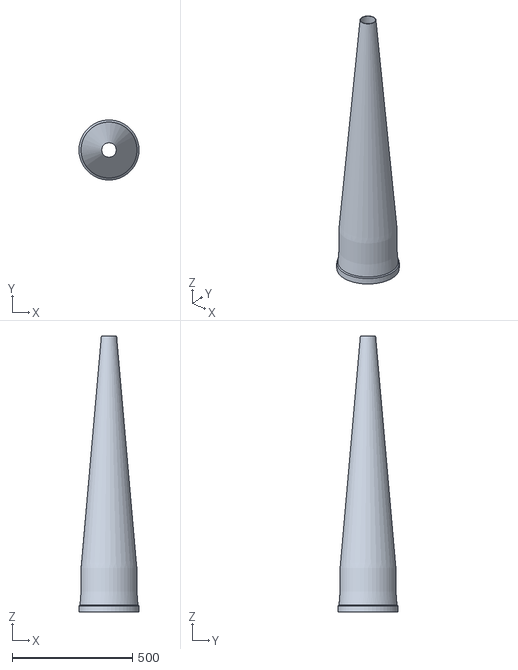
[picture p71: CAD file, 2023-02-14]
geometry_source/htcc/cad/htccMollerCone.stl
249.6 x 249.1 x 1145.4
