marcospreafico/clas12Tags/geometry_source/ltcc/cad/S1-BRB.stl

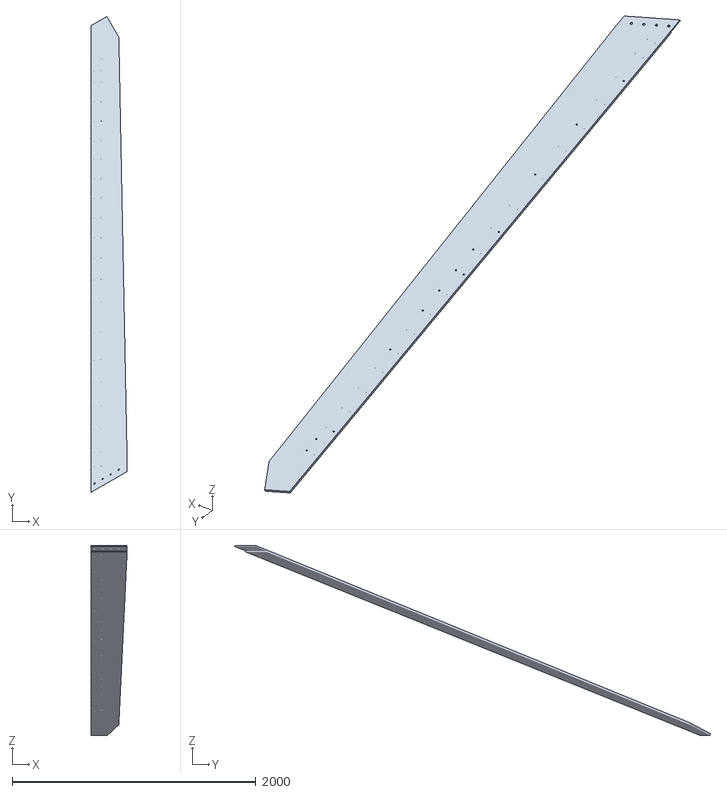
[picture p72: CAD file, 2023-02-14]
geometry_source/ltcc/cad/S1-BRB.stl
297.9 x 3906.4 x 1559.5
