marcospreafico/clas12Tags/geometry_source/ltcc/cadTempRemoved/Nose.stl

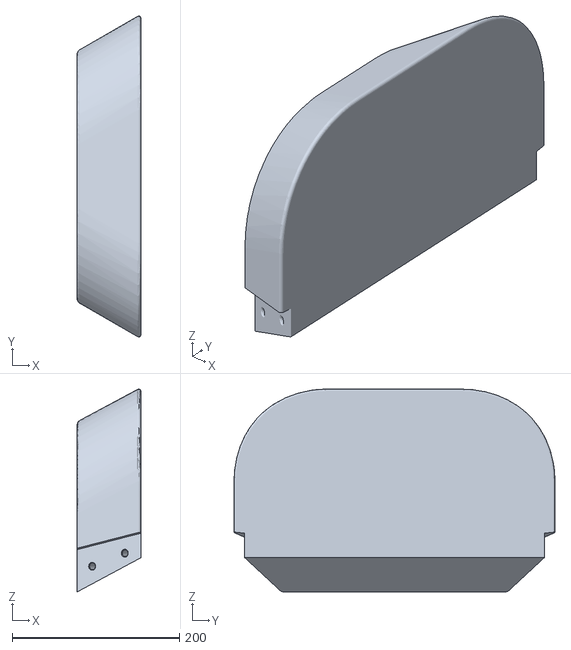
[picture p73: CAD file, 2023-02-14]
geometry_source/ltcc/cadTempRemoved/Nose.stl
76.2 x 383.4 x 242.4
