marcospreafico/clas12Tags/geometry_source/magnets/cad/coil1.stl

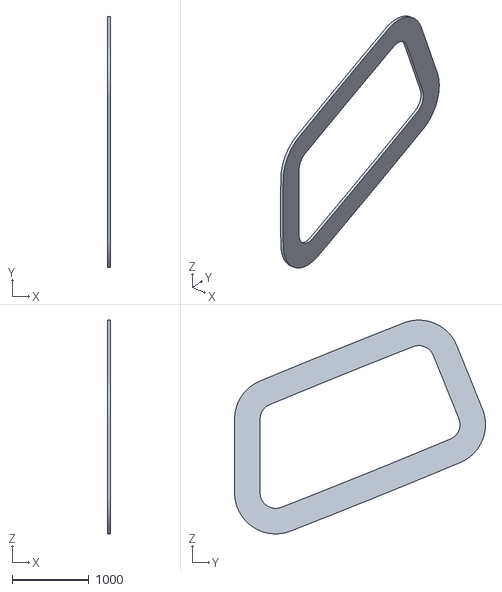
[picture p74: CAD file, 2023-02-14]
geometry_source/magnets/cad/coil1.stl
40.7 x 3263.8 x 2779.9
