marcospreafico/clas12Tags/geometry_source/targets/cad/TargetWallKapton.stl

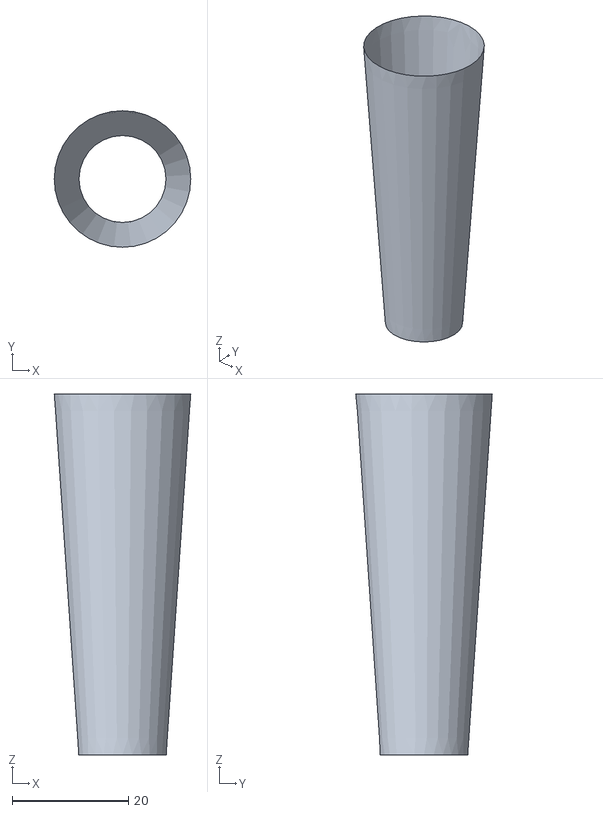
[picture p75: CAD file, 2023-02-14]
geometry_source/targets/cad/TargetWallKapton.stl
23.5 x 23.5 x 62.2
