marcospreafico/clas12Tags/geometry_source/targets/cad_hdice/LHeCan_Cu.stl

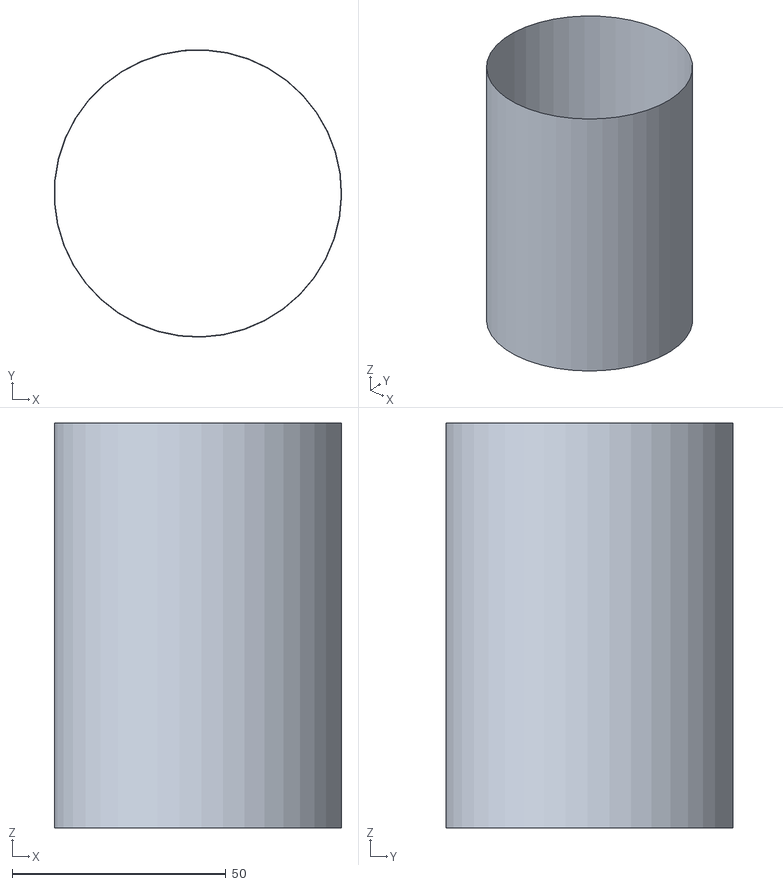
[picture p76: CAD file, 2023-02-14]
geometry_source/targets/cad_hdice/LHeCan_Cu.stl
67.2 x 67.3 x 94.7
