marcospreafico/clas12Tags/geometry_source/targets/cad_rgd/needle_4.stl

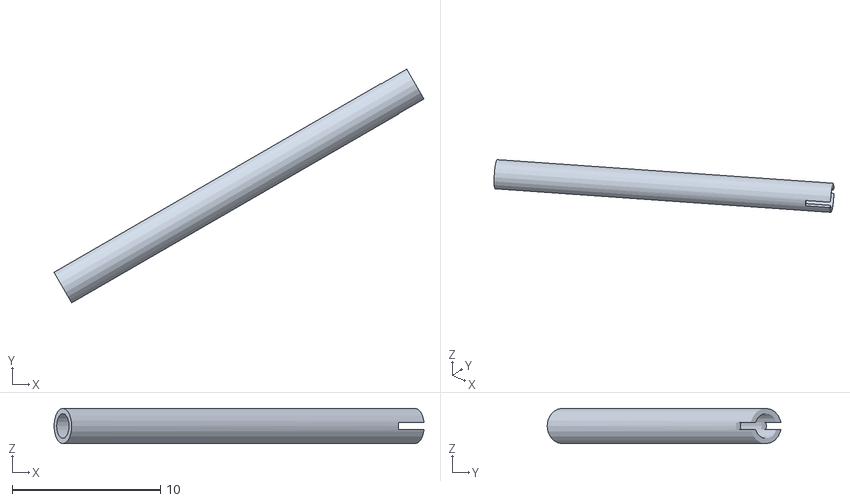
[picture p77: CAD file, 2024-06-17]
geometry_source/targets/cad_rgd/needle_4.stl
24.9 x 15.8 x 2.38
