marcospreafico/clas12Tags/geometry_source/targets/cad_rgm/TargetBaseTubeTorlon.stl

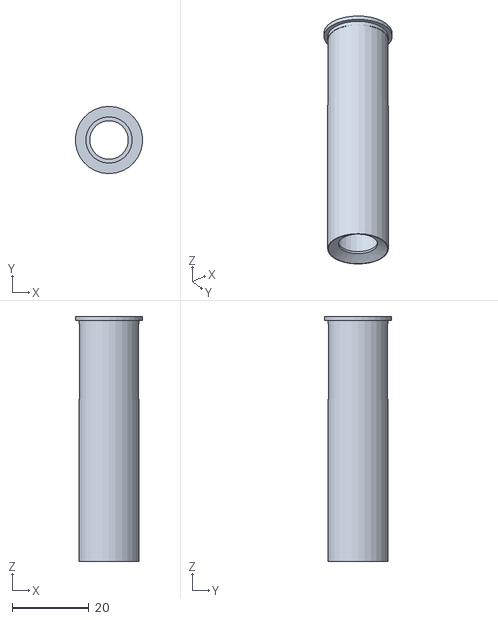
[picture p78: CAD file, 2023-02-14]
geometry_source/targets/cad_rgm/TargetBaseTubeTorlon.stl
17.4 x 17.5 x 63.7
