marcospreafico/clas12Tags/geometry_source/targets/cad_transverse/DownstreamRS.stl

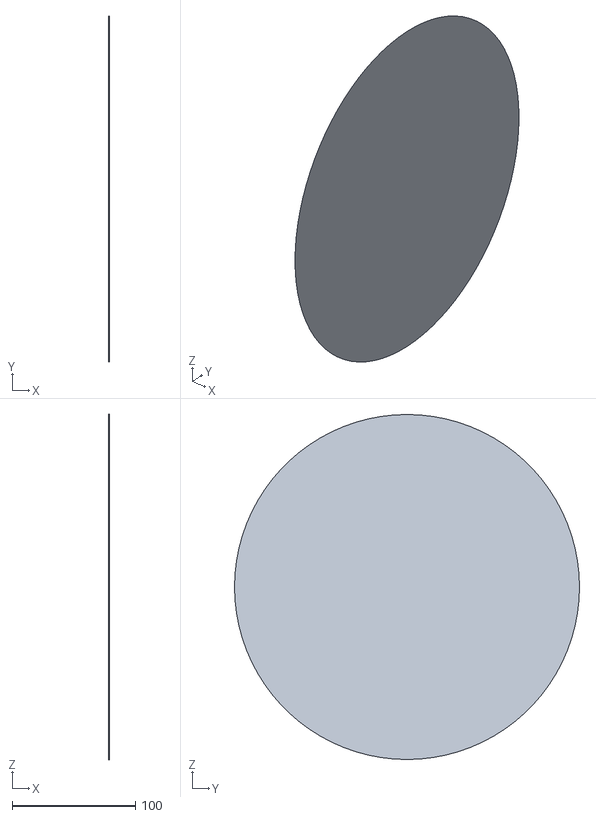
[picture p79: CAD file, 2023-02-14]
geometry_source/targets/cad_transverse/DownstreamRS.stl
0.0508 x 279.4 x 279.4
