marcospreafico/clas12Tags/geometry_source/targets/rge-dt/Al/Carbon.stl

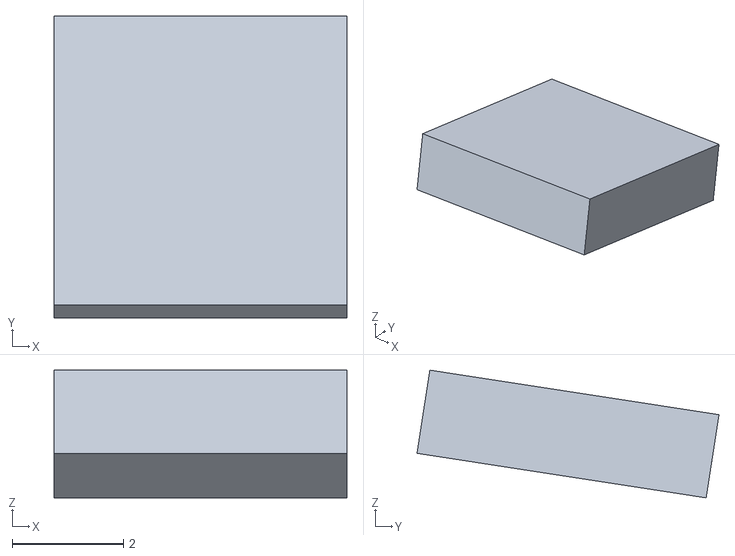
[picture p80: CAD file, 2024-10-23]
geometry_source/targets/rge-dt/Al/Carbon.stl
5.25 x 5.42 x 2.29
