marcospreafico/clas12Tags/geometry_source/targets/rge-dt/C/Copper.stl

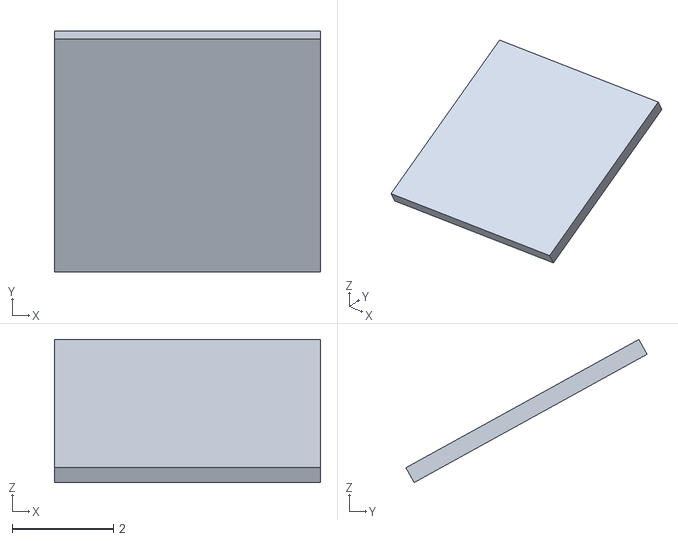
[picture p81: CAD file, 2024-10-23]
geometry_source/targets/rge-dt/C/Copper.stl
5.25 x 4.76 x 2.83
