marcospreafico/clas12Tags/geometry_source/targets/rge-dt/common/ScatteringChamberC.stl

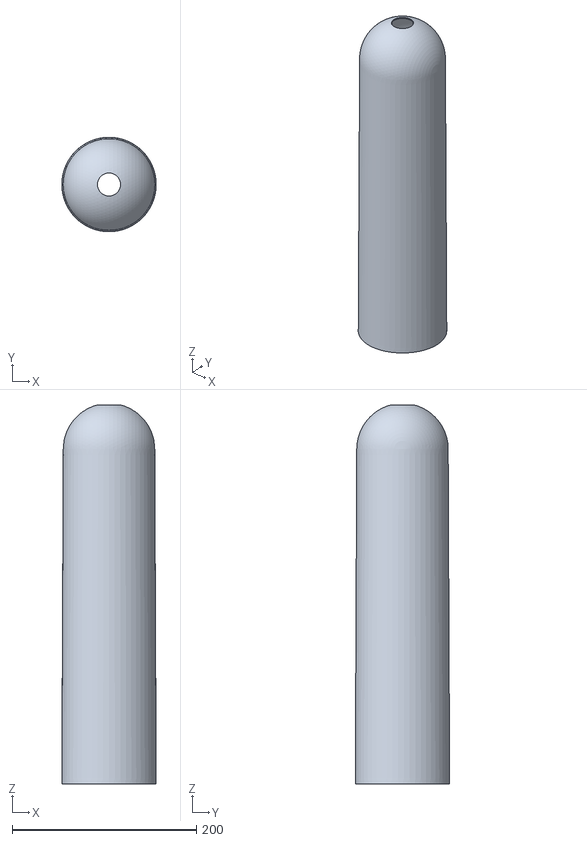
[picture p82: CAD file, 2024-10-23]
geometry_source/targets/rge-dt/common/ScatteringChamberC.stl
102.6 x 102.6 x 411.6
