marcospreafico/clas12Tags/geometry_source/targets/rge-dt/Cu/Lead.stl

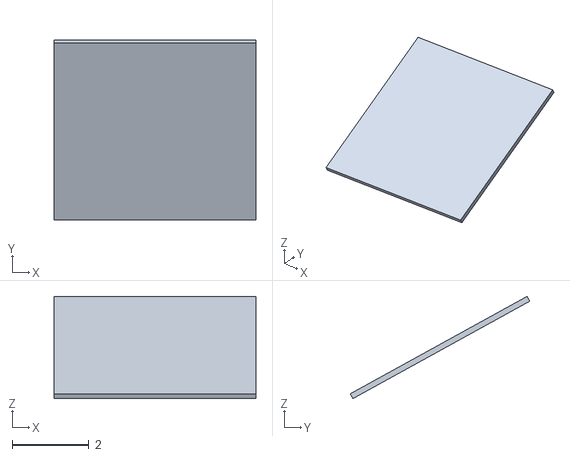
[picture p83: CAD file, 2024-10-23]
geometry_source/targets/rge-dt/Cu/Lead.stl
5.25 x 4.67 x 2.66
