marcospreafico/clas12Tags/geometry_source/targets/rge-dt/Pb/Band.stl

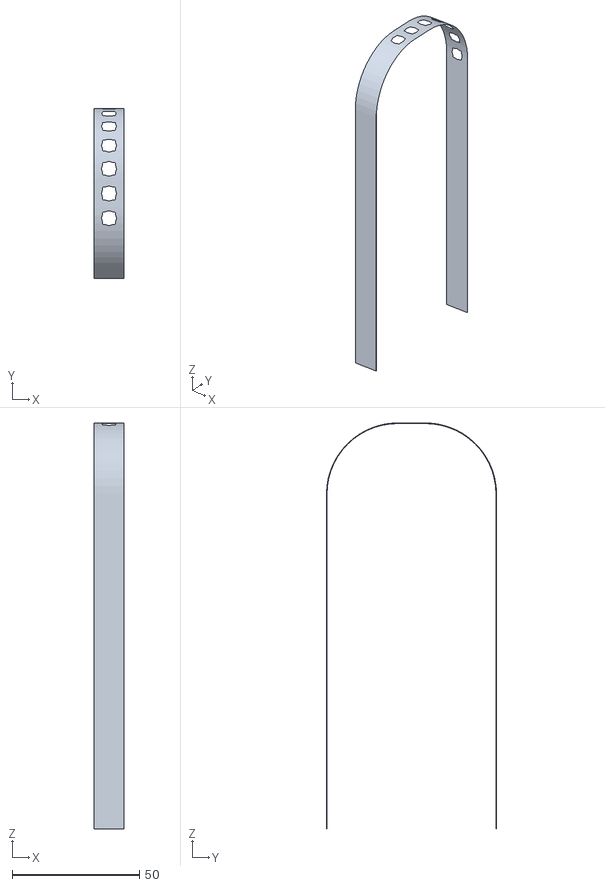
[picture p84: CAD file, 2024-10-23]
geometry_source/targets/rge-dt/Pb/Band.stl
11.9 x 66.9 x 159.6
