marcospreafico/clas12Tags/experiments/atlas/cad/ForwardShield.stl

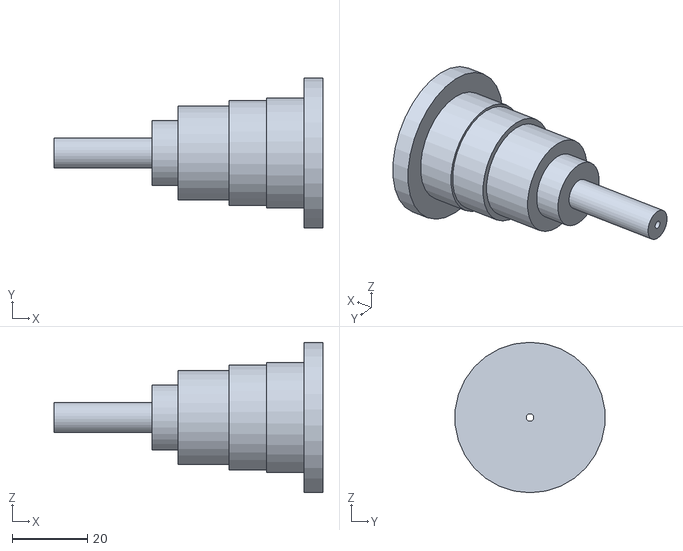
[picture p85: CAD file, 2023-02-14]
experiments/atlas/cad/ForwardShield.stl
71.5 x 39.8 x 40.0
