marcospreafico/clas12Tags/experiments/clas12/ctof/cad/lgd35.stl

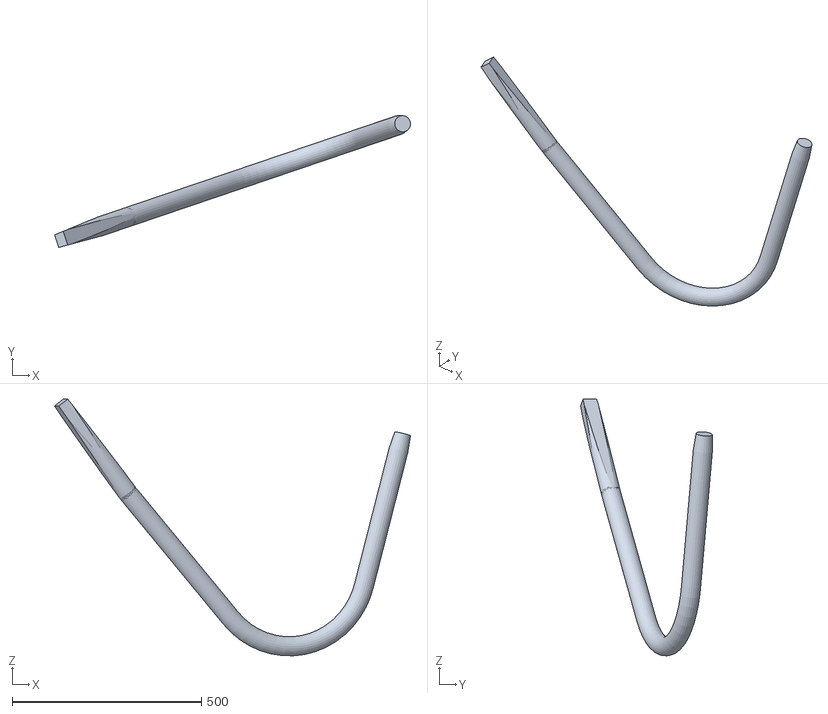
[picture p86: CAD file, 2023-02-14]
experiments/clas12/ctof/cad/lgd35.stl
939.4 x 348.0 x 677.2
