marcospreafico/clas12Tags/experiments/clas12/ctof/cad_upstream/lgu11.stl

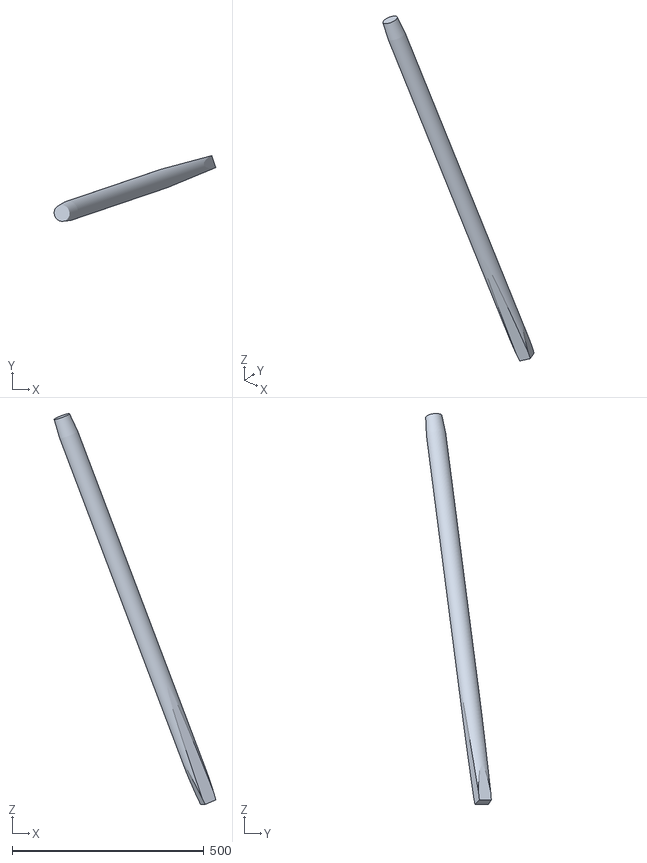
[picture p87: CAD file, 2023-02-14]
experiments/clas12/ctof/cad_upstream/lgu11.stl
421.6 x 171.4 x 1019.2
