marcospreafico/clas12Tags/experiments/clas12/rich/cad/CFRP_m2.stl

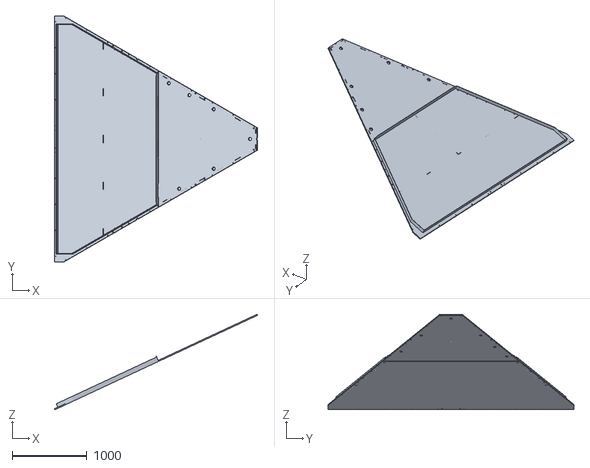
[picture p88: CAD file, 2024-01-29]
experiments/clas12/rich/cad/CFRP_m2.stl
2725.4 x 3300.0 x 1280.5
