marcospreafico/clas12Tags/experiments/forFun/cad/enterprise.stl

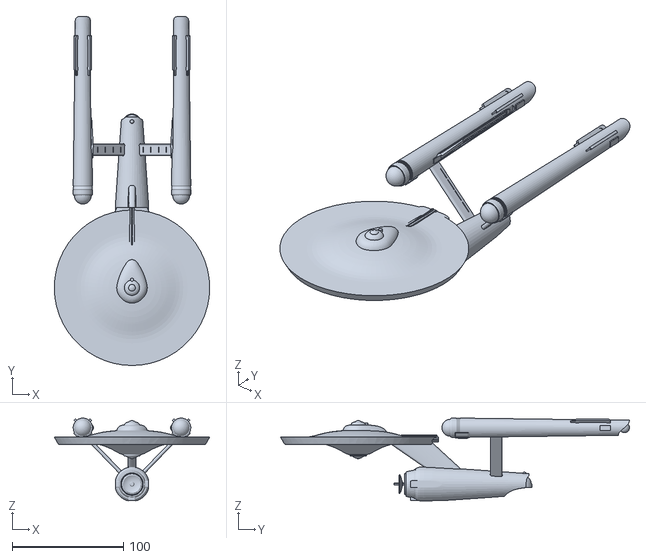
[picture p89: CAD file, 2023-02-14]
experiments/forFun/cad/enterprise.stl
140.0 x 314.4 x 74.7
