marcospreafico/clas12Tags/experiments/humanBody/cad/heart.stl

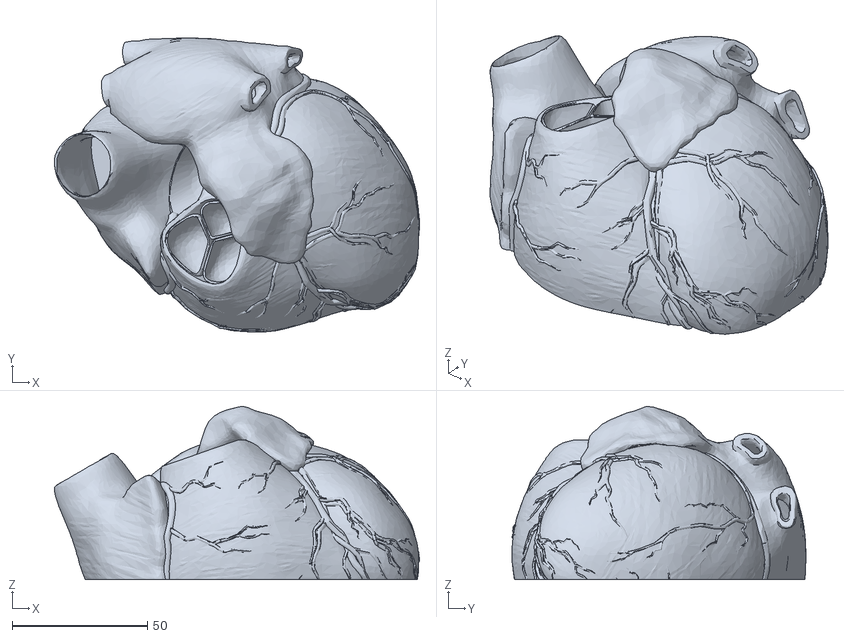
[picture p90: CAD file, 2023-02-14]
experiments/humanBody/cad/heart.stl
134.9 x 108.7 x 64.0
