marcospreafico/clas12Tags/geometry_source/beamline/cad/Torus_Exit_Shield_Casing.stl

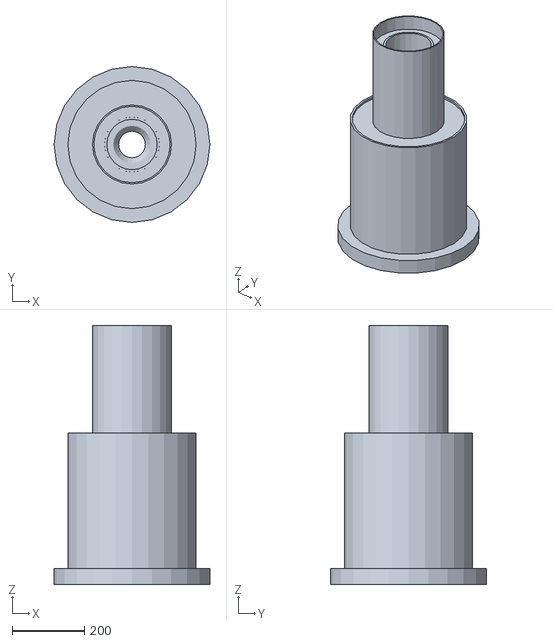
[picture p91: CAD file, 2024-09-16]
geometry_source/beamline/cad/Torus_Exit_Shield_Casing.stl
431.8 x 431.8 x 717.5
