marcospreafico/clas12Tags/geometry_source/beamline/cad_transverse/midpointWedges/TGT-9000-1000-0002_MIR1m.stl

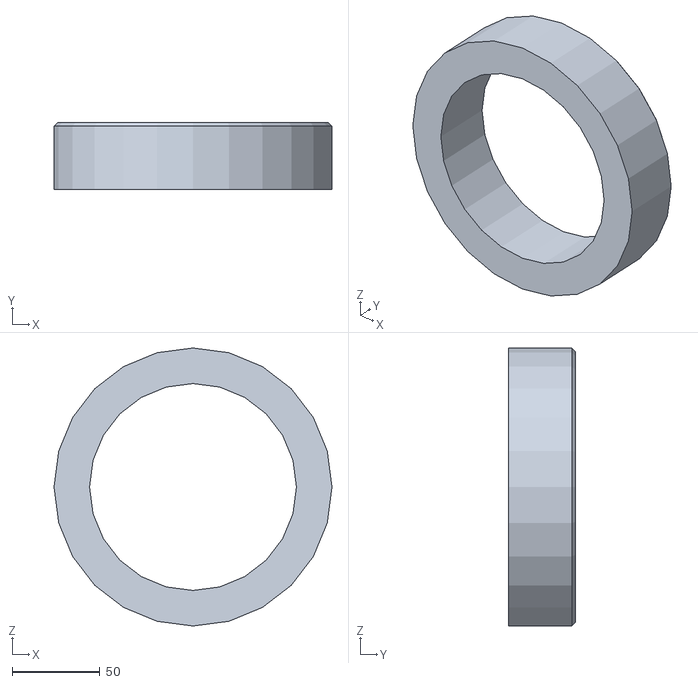
[picture p92: CAD file, 2024-09-16]
geometry_source/beamline/cad_transverse/midpointWedges/TGT-9000-1000-0002_MIR1m.stl
158.0 x 38.0 x 158.0
