marcospreafico/clas12Tags/geometry_source/ddvcs/cad/layout_calorimeter.stl

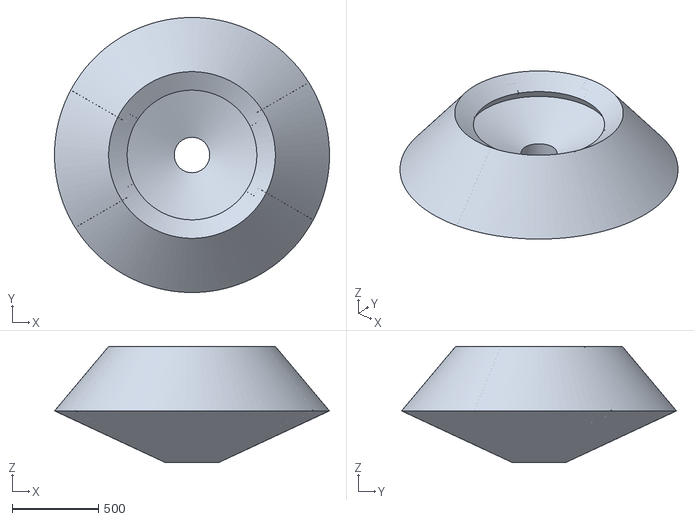
[picture p93: CAD file, 2023-02-24]
geometry_source/ddvcs/cad/layout_calorimeter.stl
1597.0 x 1597.1 x 675.6
