marcospreafico/clas12Tags/geometry_source/htcc/cad/htccMollerConeExt.stl

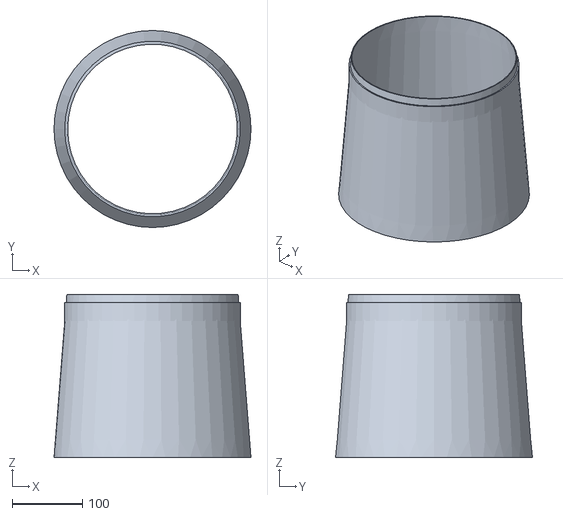
[picture p94: CAD file, 2023-02-14]
geometry_source/htcc/cad/htccMollerConeExt.stl
280.2 x 280.2 x 232.0
