marcospreafico/clas12Tags/geometry_source/ltcc/cad/S1-TB.stl

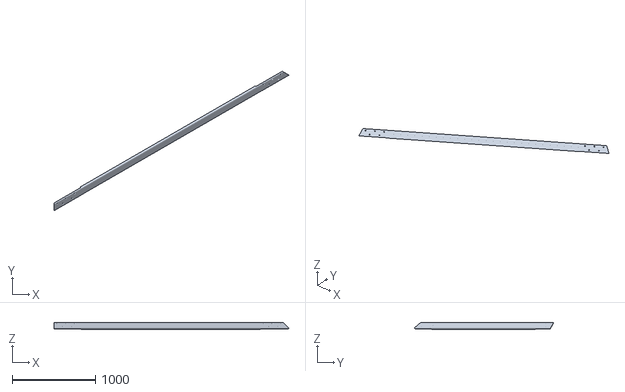
[picture p95: CAD file, 2023-02-14]
geometry_source/ltcc/cad/S1-TB.stl
2820.1 x 1674.6 x 82.8
