marcospreafico/clas12Tags/geometry_source/ltcc/cadTempRemoved/S1-LW.stl

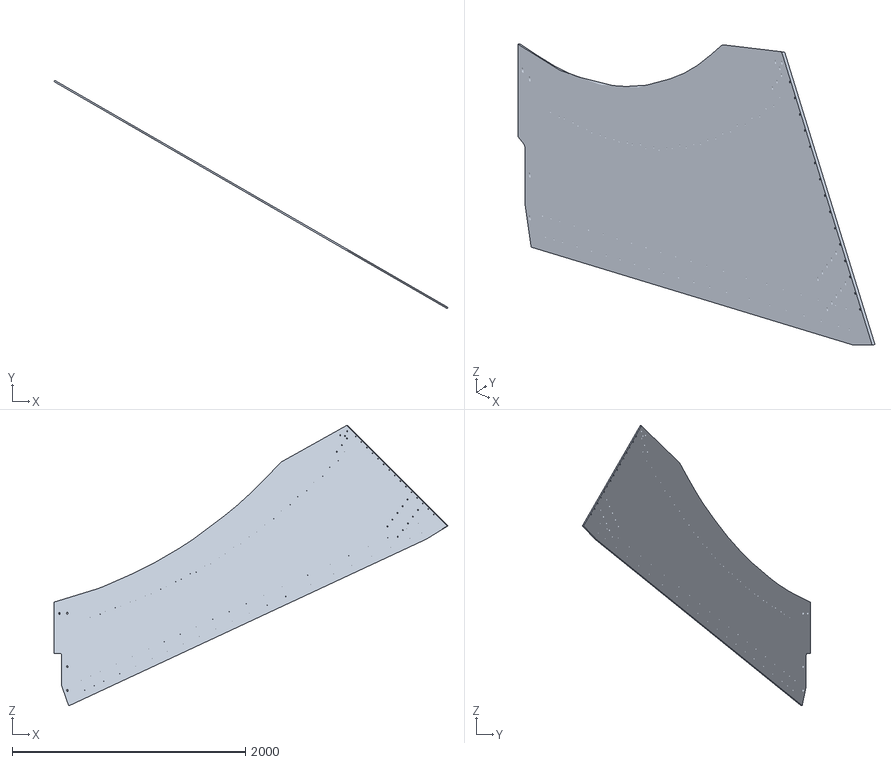
[picture p96: CAD file, 2023-02-14]
geometry_source/ltcc/cadTempRemoved/S1-LW.stl
3378.6 x 1958.3 x 2403.1
