marcospreafico/clas12Tags/geometry_source/magnets/cad/shell3a.stl

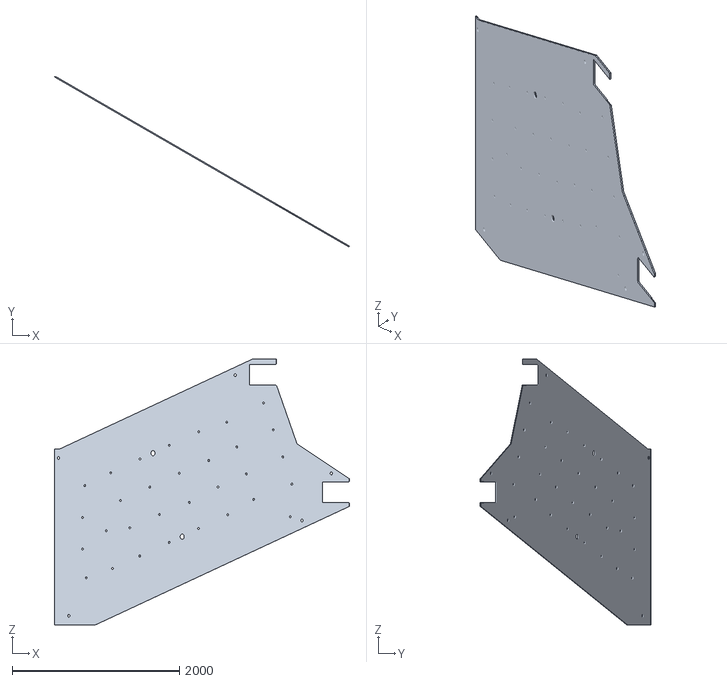
[picture p97: CAD file, 2023-02-14]
geometry_source/magnets/cad/shell3a.stl
3527.8 x 2042.7 x 3176.2
