marcospreafico/clas12Tags/geometry_source/targets/cad_hdice/unit_SS.stl

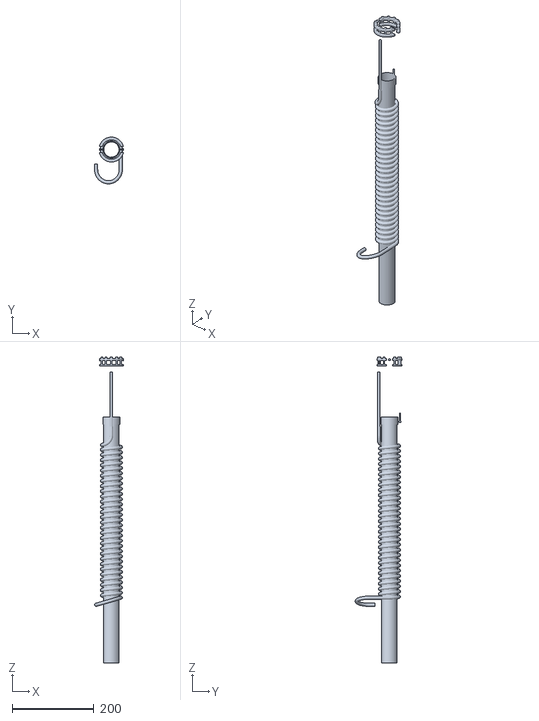
[picture p98: CAD file, 2023-02-14]
geometry_source/targets/cad_hdice/unit_SS.stl
70.9 x 114.3 x 747.1
