marcospreafico/clas12Tags/geometry_source/targets/cad_rgd/needle_1.stl

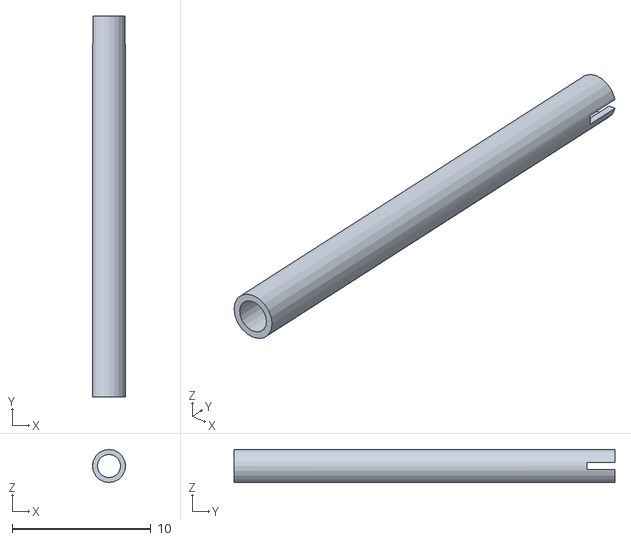
[picture p99: CAD file, 2024-06-17]
geometry_source/targets/cad_rgd/needle_1.stl
2.38 x 27.5 x 2.38
