marcospreafico/clas12Tags/geometry_source/targets/cad_transverse/AdditionalWindows.stp

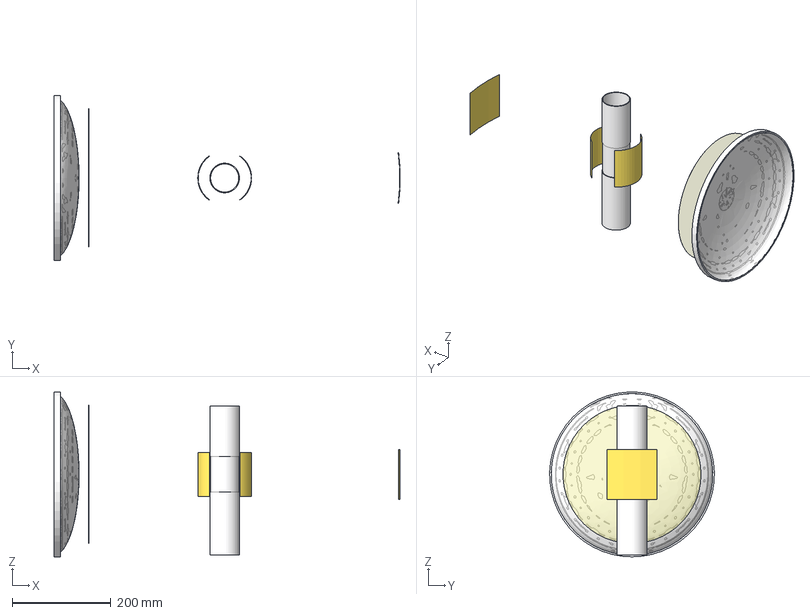
[picture p100: CAD file, 2023-02-14]
geometry_source/targets/cad_transverse/AdditionalWindows.stp
699.8 x 333.2 x 333.1 mm
Upstream RS
Beam Path exit window
Downstream RS
Upstream RS_1
Pumpline-7inch
Inner RS Sheet_MIR1
