marcospreafico/clas12Tags/geometry_source/targets/rge-dt/C/Boxes.stl

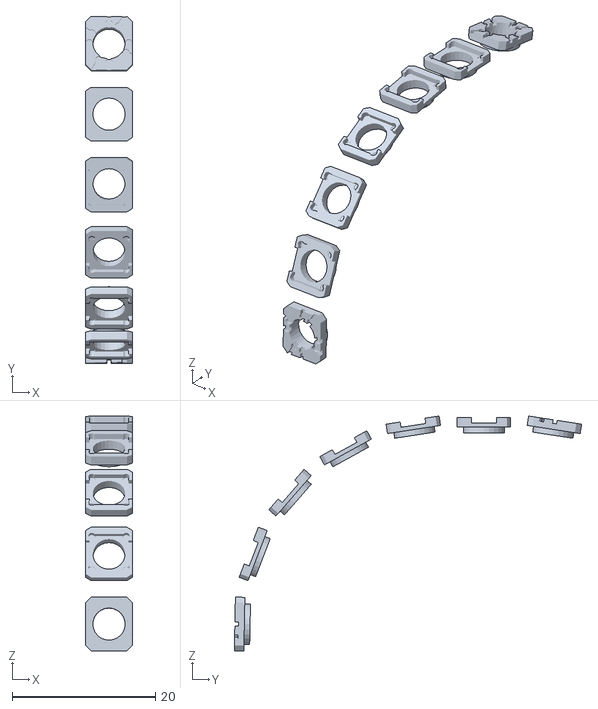
[picture p101: CAD file, 2024-10-23]
geometry_source/targets/rge-dt/C/Boxes.stl
6.50 x 48.5 x 32.8
