marcospreafico/clas12Tags/geometry_source/targets/rge-dt/common/TargetBaseTubeTorlon.stl

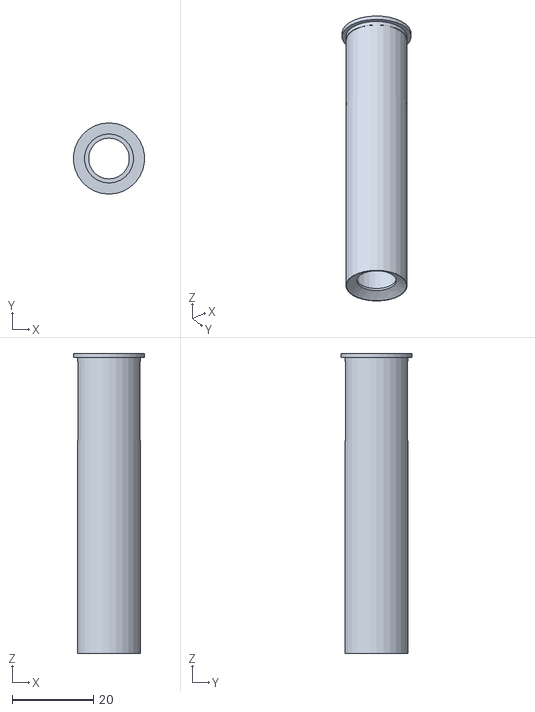
[picture p102: CAD file, 2024-10-23]
geometry_source/targets/rge-dt/common/TargetBaseTubeTorlon.stl
17.4 x 17.5 x 73.7
