marcospreafico/clas12Tags/geometry_source/targets/rge-dt/Empty/Copper.stl

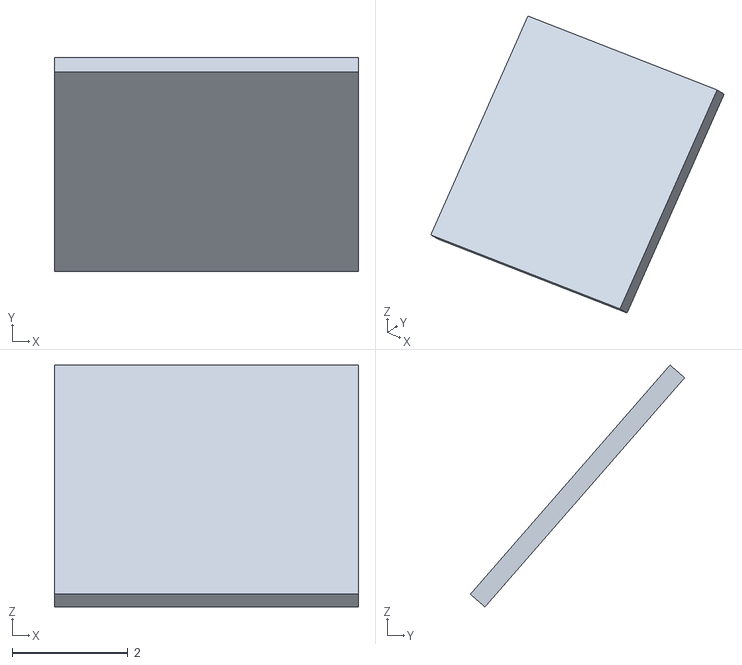
[picture p103: CAD file, 2024-10-23]
geometry_source/targets/rge-dt/Empty/Copper.stl
5.25 x 3.70 x 4.18
