marcospreafico/clas12Tags/geometry_source/targets/rge-dt/Sn/Carbon.stl

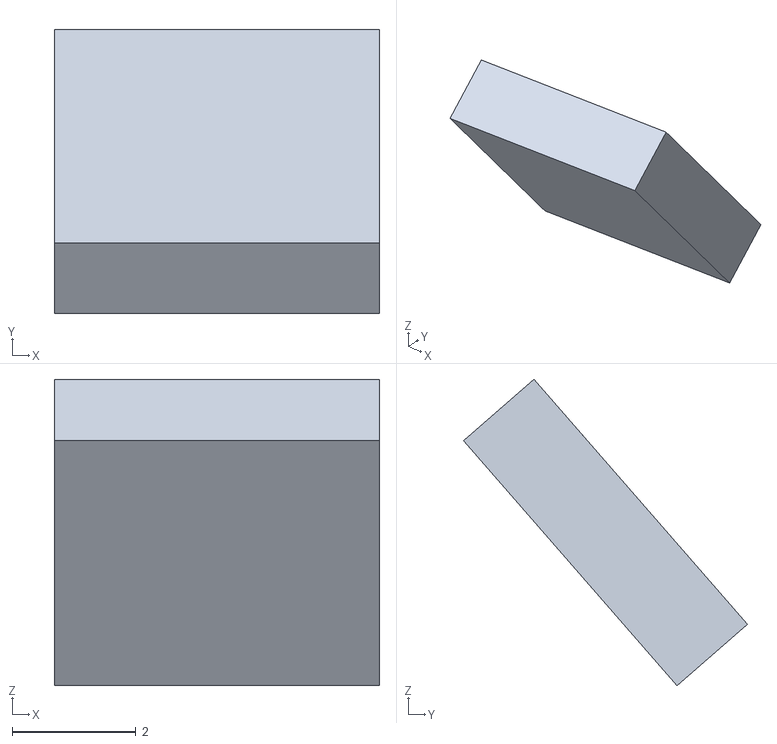
[picture p104: CAD file, 2024-10-23]
geometry_source/targets/rge-dt/Sn/Carbon.stl
5.25 x 4.59 x 4.95
