marcospreafico/clas12Tags/experiments/atlas/cad/HEC.stl

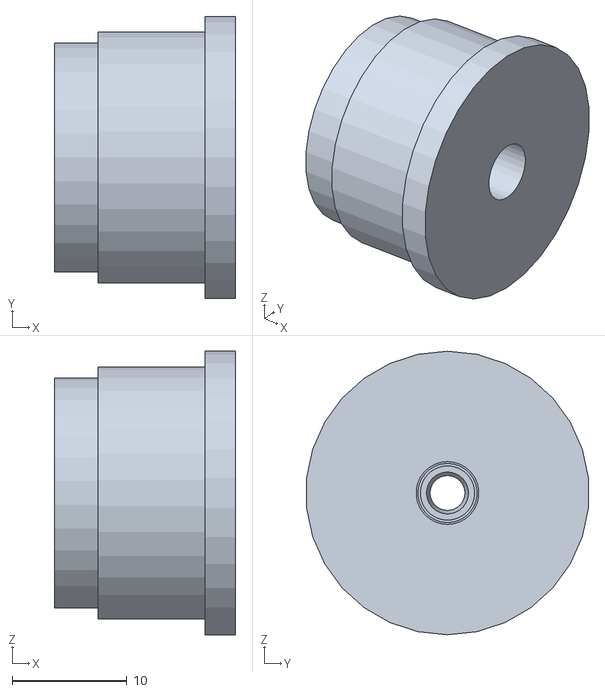
[picture p105: CAD file, 2023-02-14]
experiments/atlas/cad/HEC.stl
15.8 x 24.6 x 24.8
