marcospreafico/clas12Tags/experiments/clas12/ctof/cad/sc32.stl

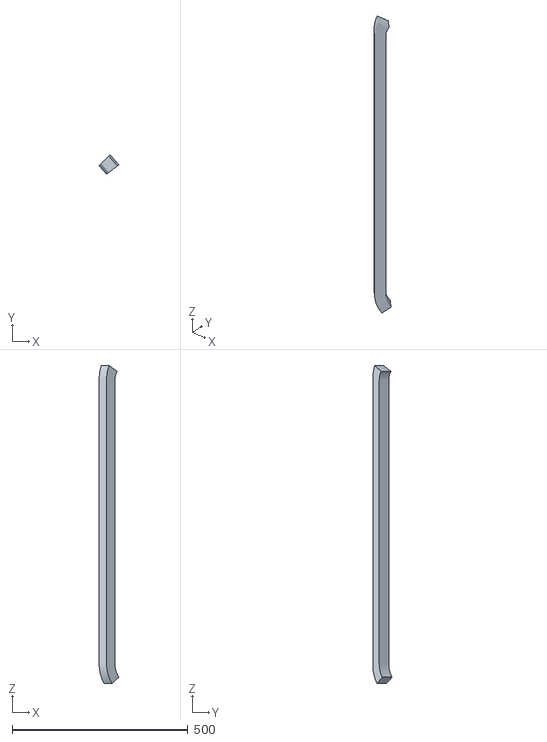
[picture p106: CAD file, 2023-02-14]
experiments/clas12/ctof/cad/sc32.stl
56.3 x 55.4 x 904.3
