marcospreafico/clas12Tags/experiments/clas12/ctof/cad_upstream/lgu37.stl

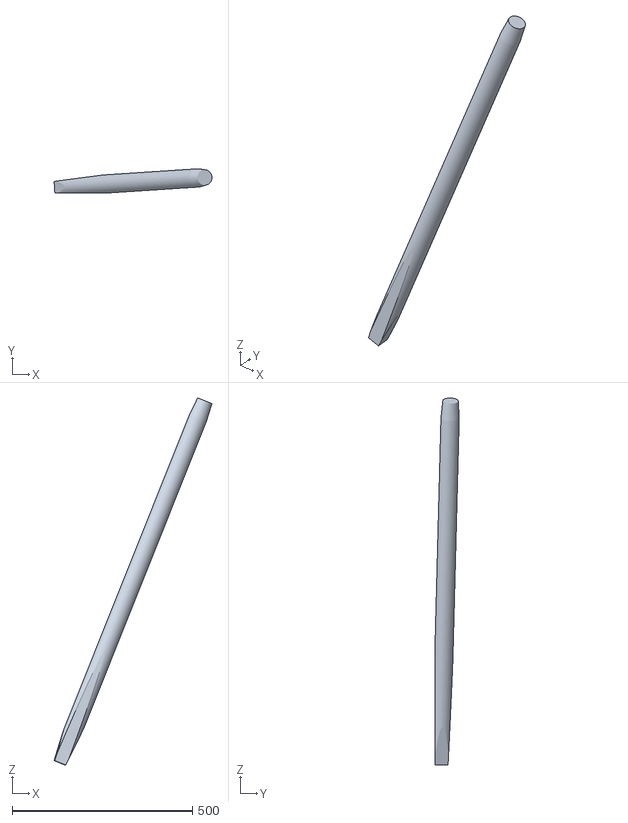
[picture p107: CAD file, 2023-02-14]
experiments/clas12/ctof/cad_upstream/lgu37.stl
438.5 x 67.9 x 1019.2
