marcospreafico/clas12Tags/experiments/clas12/targets/cad_longitudinal/outer_cell.stl

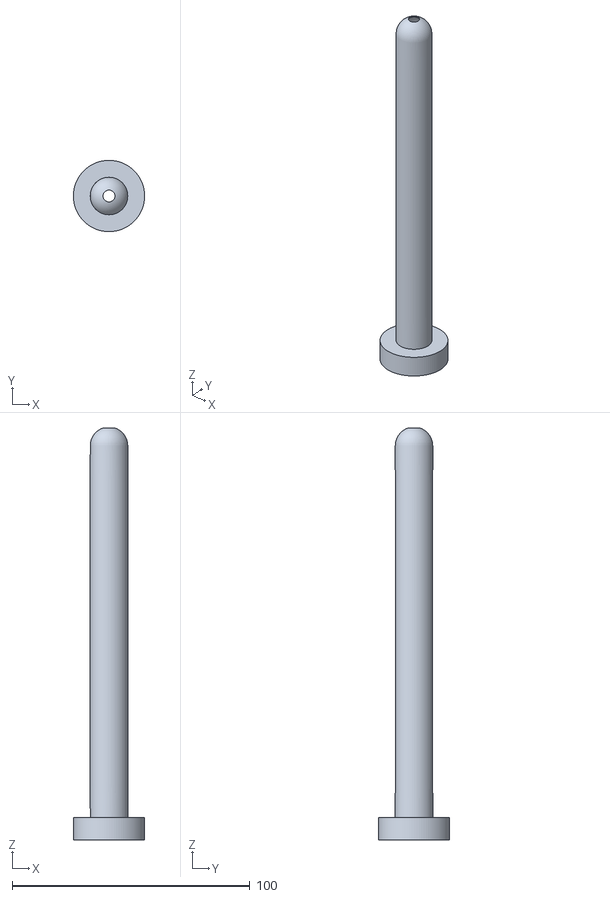
[picture p108: CAD file, 2023-02-14]
experiments/clas12/targets/cad_longitudinal/outer_cell.stl
30.0 x 30.0 x 173.4
