marcospreafico/clas12Tags/experiments/humanBody/cad/brain.stl

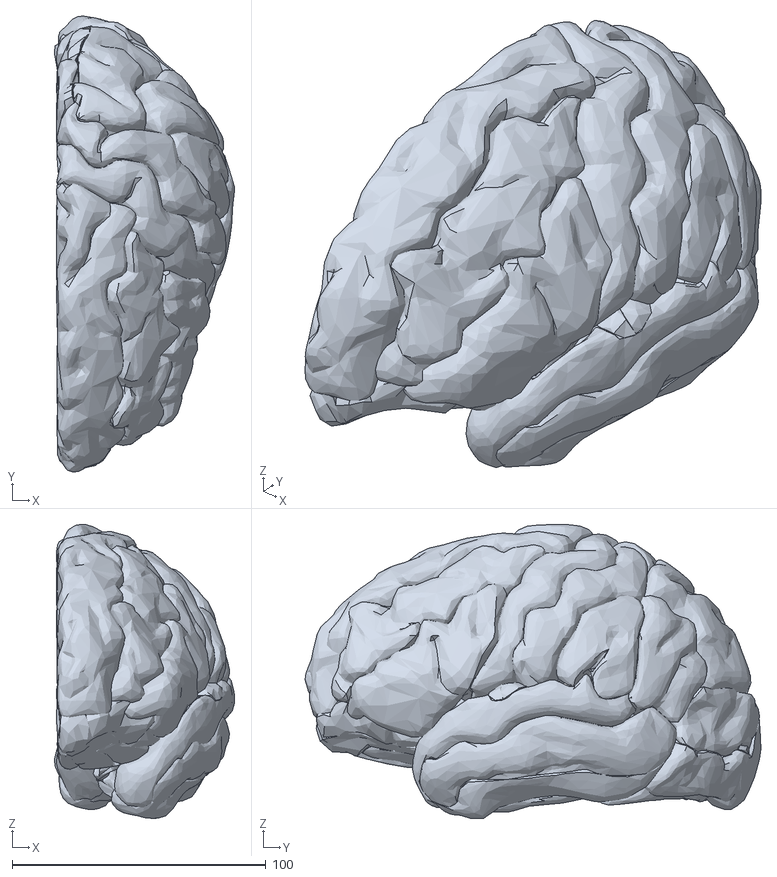
[picture p109: CAD file, 2023-02-14]
experiments/humanBody/cad/brain.stl
71.0 x 179.6 x 115.8
