marcospreafico/clas12Tags/geometry_source/beamline/cad/downstream_beamline.stp

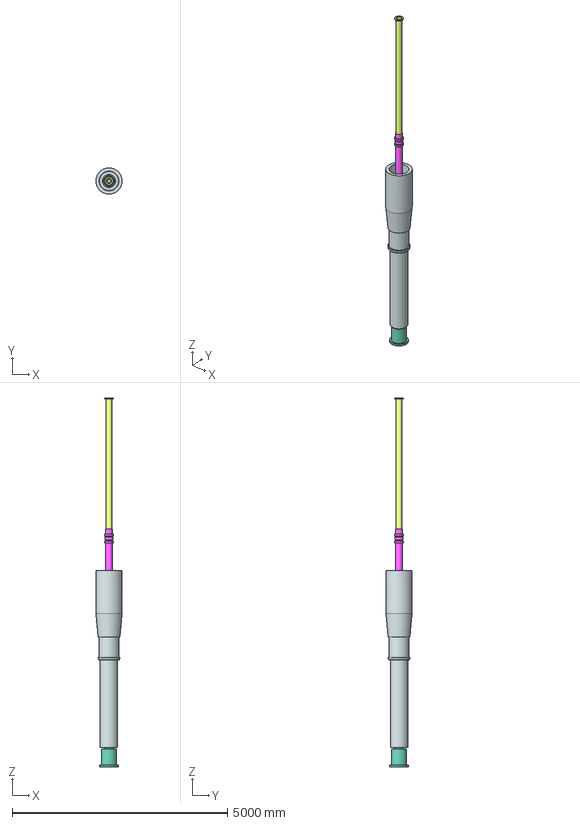
[picture p110: CAD file, 2024-09-16]
geometry_source/beamline/cad/downstream_beamline.stp
609.5 x 609.5 x 8567.6 mm
JL0171633_-
JL0171568_-
JL0172091_-
JL0172092_-
JL0172093_-
JL0172094_-
JL0172095_-
