marcospreafico/clas12Tags/geometry_source/ddvcs/cad/moeller_cone.stl

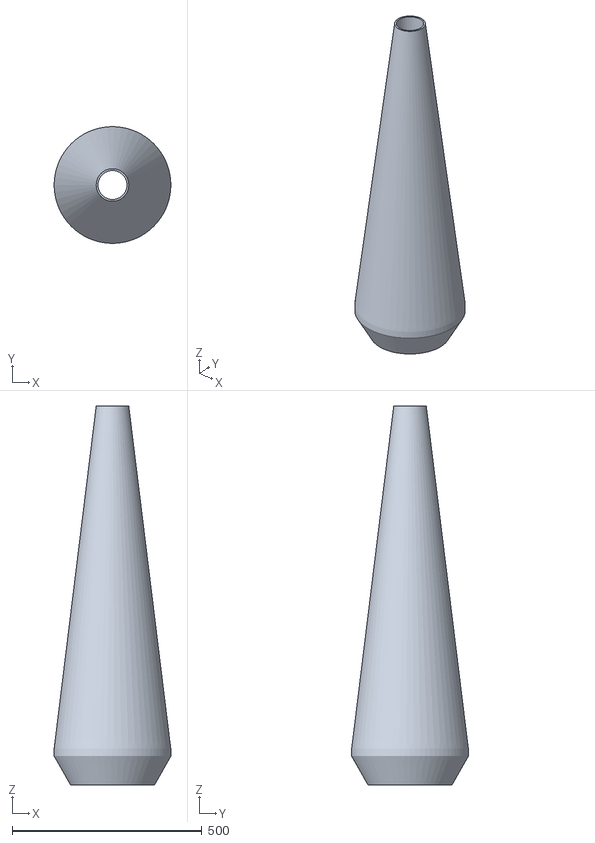
[picture p112: CAD file, 2023-02-24]
geometry_source/ddvcs/cad/moeller_cone.stl
307.5 x 307.5 x 998.3
