marcospreafico/clas12Tags/geometry_source/ltcc/cad/S1-TLB.stl

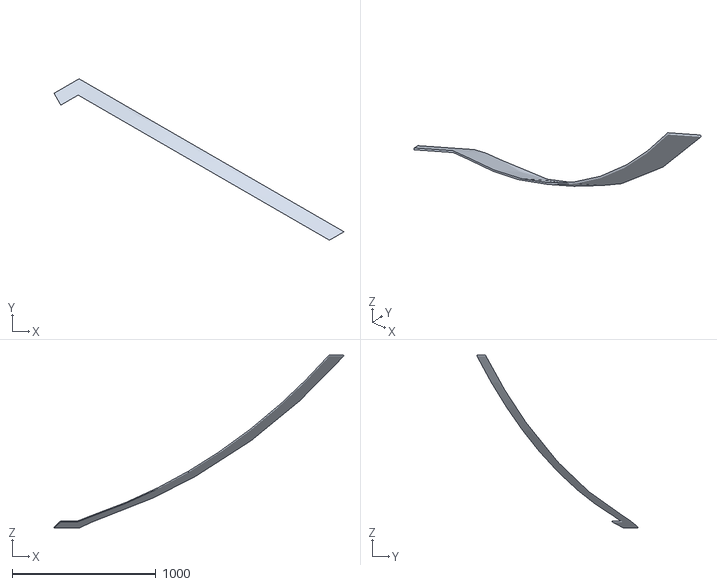
[picture p113: CAD file, 2023-02-14]
geometry_source/ltcc/cad/S1-TLB.stl
2014.9 x 1121.2 x 1201.1
