marcospreafico/clas12Tags/geometry_source/ltcc/cadTempRemoved/BottomPlate.stl

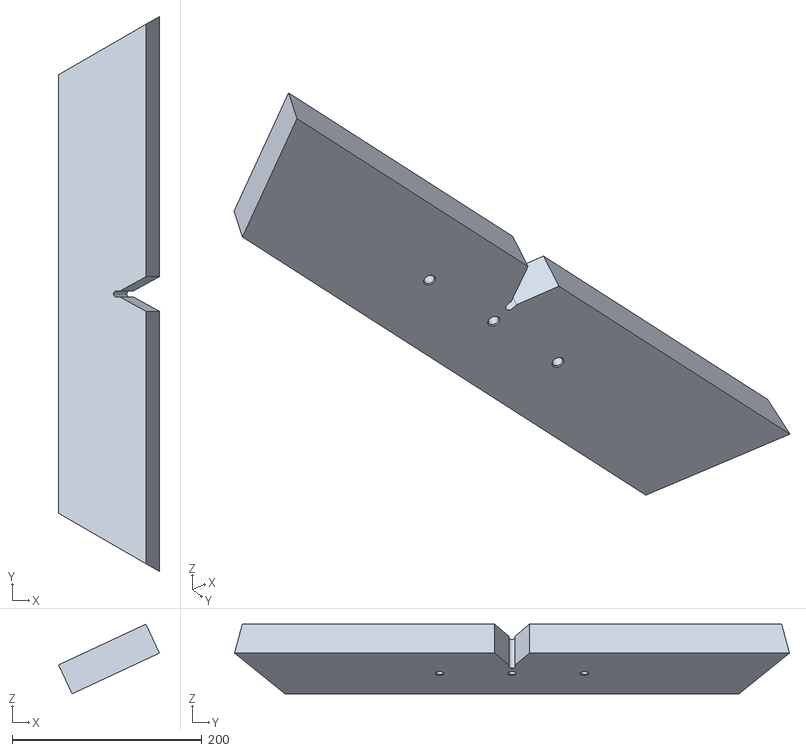
[picture p114: CAD file, 2023-02-14]
geometry_source/ltcc/cadTempRemoved/BottomPlate.stl
106.3 x 584.9 x 73.4
