marcospreafico/clas12Tags/geometry_source/magnets/cad/shell5b.stl

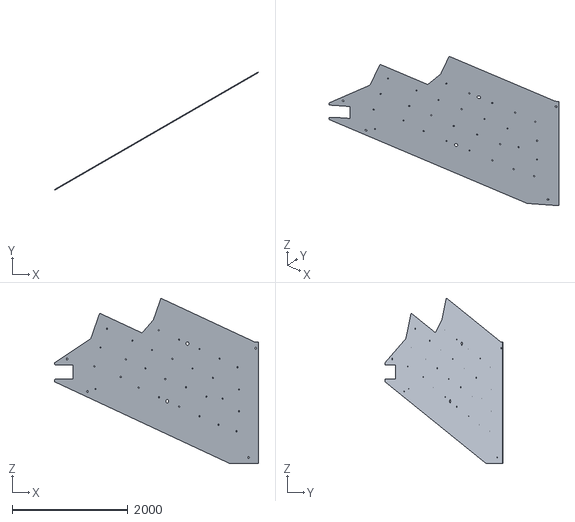
[picture p115: CAD file, 2023-02-14]
geometry_source/magnets/cad/shell5b.stl
3527.8 x 2042.7 x 2859.1
