marcospreafico/clas12Tags/geometry_source/targets/cad/TargetEndCapKapton.stl

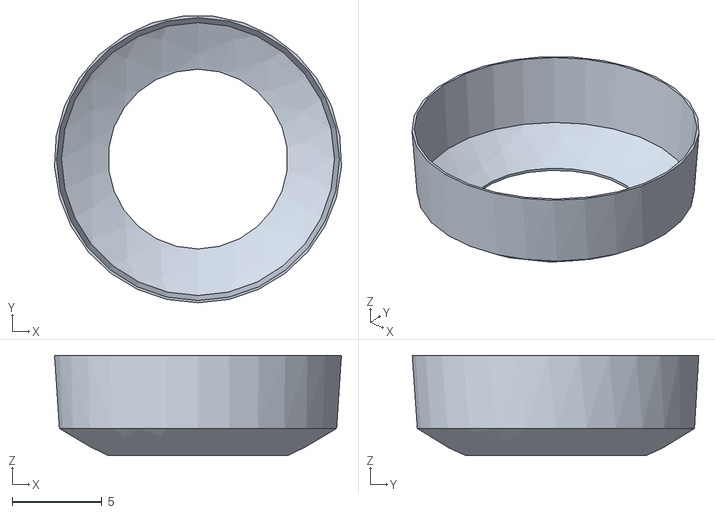
[picture p116: CAD file, 2023-02-14]
geometry_source/targets/cad/TargetEndCapKapton.stl
16.0 x 15.9 x 5.59
