marcospreafico/clas12Tags/geometry_source/targets/cad_hdice/80KCan_SS.stl

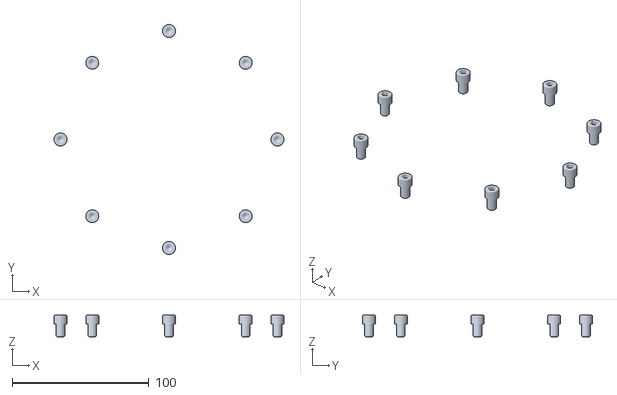
[picture p117: CAD file, 2023-02-14]
geometry_source/targets/cad_hdice/80KCan_SS.stl
168.3 x 168.3 x 15.9
