marcospreafico/clas12Tags/geometry_source/targets/cad_transverse/UpstreamRS.stl

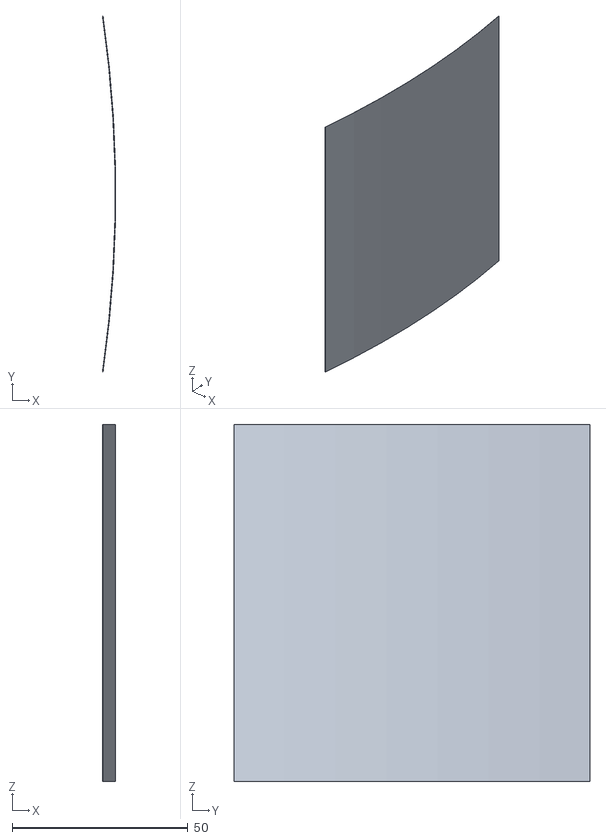
[picture p118: CAD file, 2023-02-14]
geometry_source/targets/cad_transverse/UpstreamRS.stl
3.61 x 101.3 x 101.6
