marcospreafico/clas12Tags/geometry_source/targets/rge-dt/Al/Lead.stl

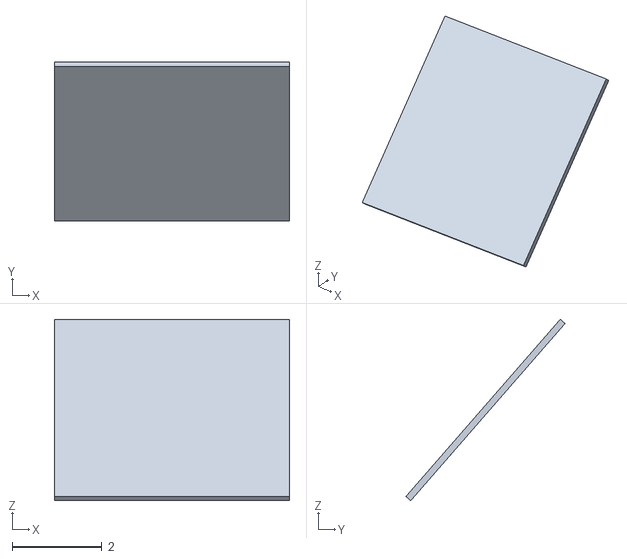
[picture p119: CAD file, 2024-10-23]
geometry_source/targets/rge-dt/Al/Lead.stl
5.25 x 3.56 x 4.05
