marcospreafico/clas12Tags/geometry_source/targets/rge-dt/C/Carbon.stl

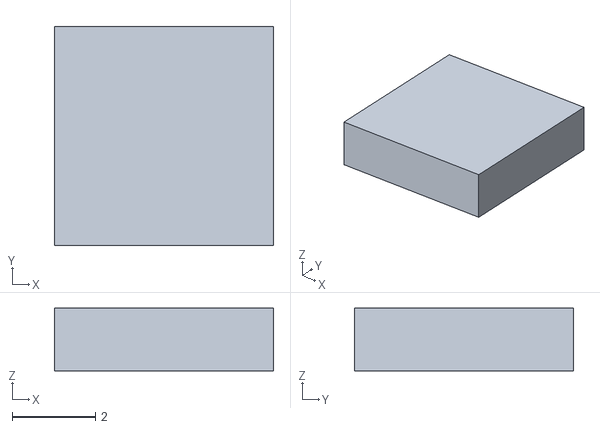
[picture p120: CAD file, 2024-10-23]
geometry_source/targets/rge-dt/C/Carbon.stl
5.25 x 5.25 x 1.51
