marcospreafico/clas12Tags/geometry_source/targets/rge-dt/common/ScatteringChamberC_window.stl

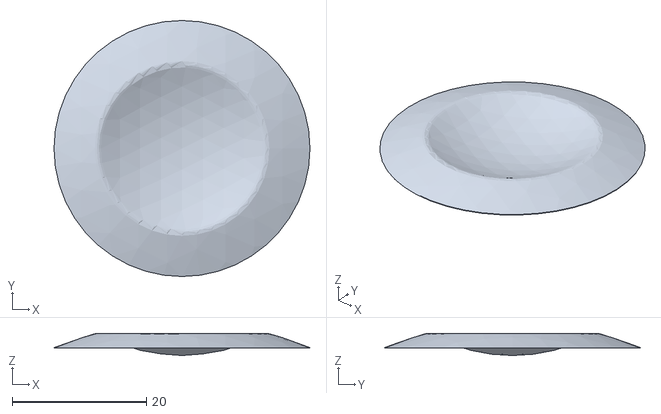
[picture p121: CAD file, 2024-10-23]
geometry_source/targets/rge-dt/common/ScatteringChamberC_window.stl
38.1 x 38.1 x 3.28
