marcospreafico/clas12Tags/geometry_source/targets/rge-dt/Cu/Carbon.stl

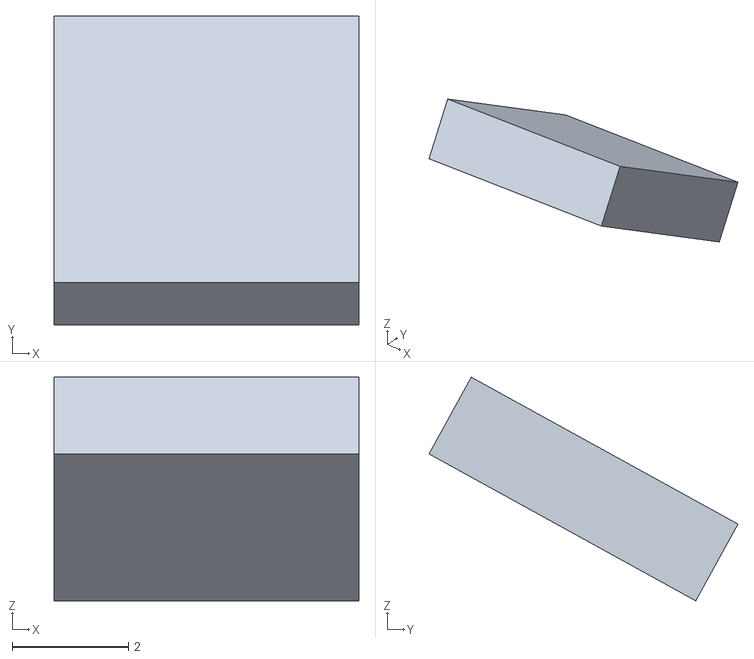
[picture p122: CAD file, 2024-10-23]
geometry_source/targets/rge-dt/Cu/Carbon.stl
5.25 x 5.33 x 3.86
