marcospreafico/clas12Tags/geometry_source/targets/rge-dt/Empty/Aluminum.stl

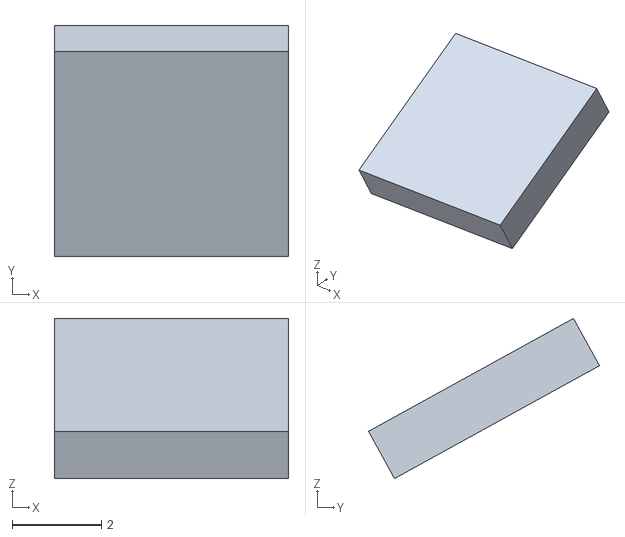
[picture p123: CAD file, 2024-10-23]
geometry_source/targets/rge-dt/Empty/Aluminum.stl
5.25 x 5.18 x 3.59
