marcospreafico/clas12Tags/geometry_source/targets/rge-dt/Pb/Tin.stl

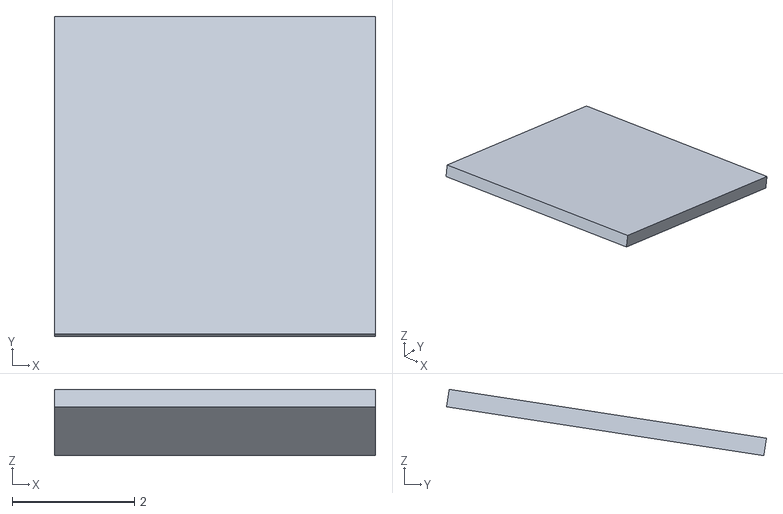
[picture p124: CAD file, 2024-10-23]
geometry_source/targets/rge-dt/Pb/Tin.stl
5.25 x 5.23 x 1.08
