marcospreafico/clas12Tags/geometry_source/targets/rge-dt/Sn/Boxes.stl

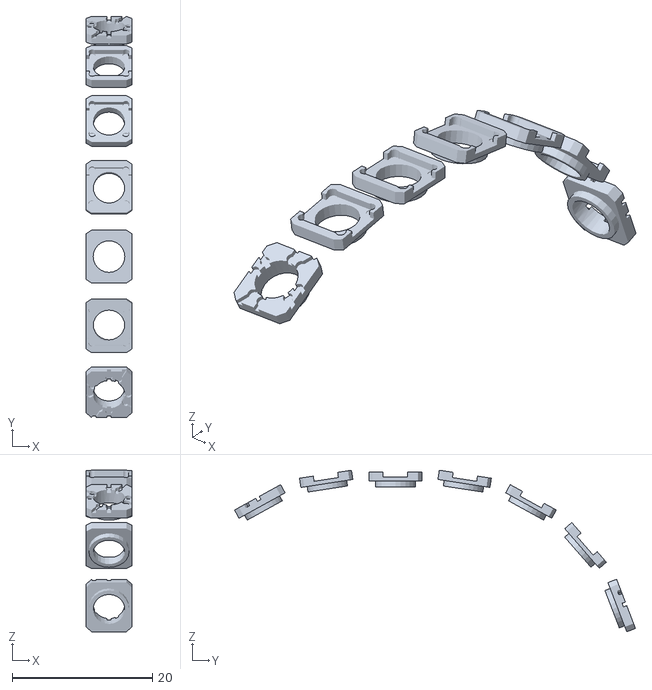
[picture p125: CAD file, 2024-10-23]
geometry_source/targets/rge-dt/Sn/Boxes.stl
6.50 x 57.1 x 23.0
