marcospreafico/clas12Tags/experiments/atlas/cad/Toroid.stl

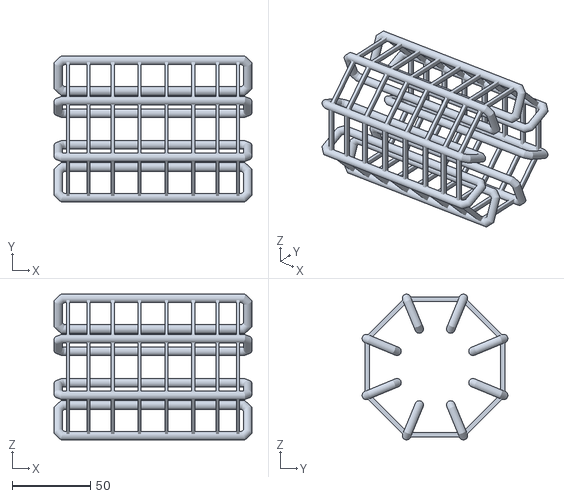
[picture p126: CAD file, 2023-02-14]
experiments/atlas/cad/Toroid.stl
126.3 x 93.0 x 93.0
