marcospreafico/clas12Tags/experiments/clas12/ctof/cad/lgd22.stl

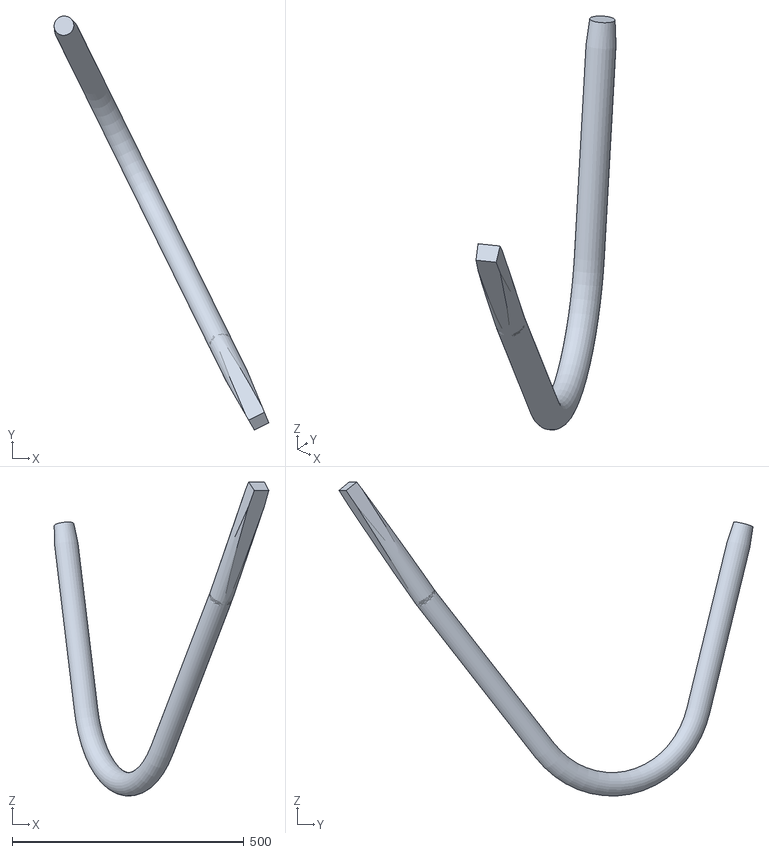
[picture p127: CAD file, 2023-02-14]
experiments/clas12/ctof/cad/lgd22.stl
463.3 x 893.4 x 677.2
