marcospreafico/clas12Tags/experiments/clas12/targets/cad_longitudinal/deverter.stl

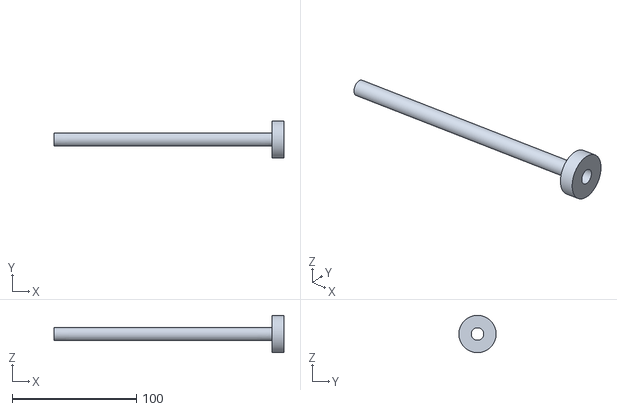
[picture p128: CAD file, 2023-02-14]
experiments/clas12/targets/cad_longitudinal/deverter.stl
185.0 x 30.0 x 30.0
