marcospreafico/clas12Tags/geometry_source/beamline/cad/Torus_Beam_Tube_Reducer_2.stl

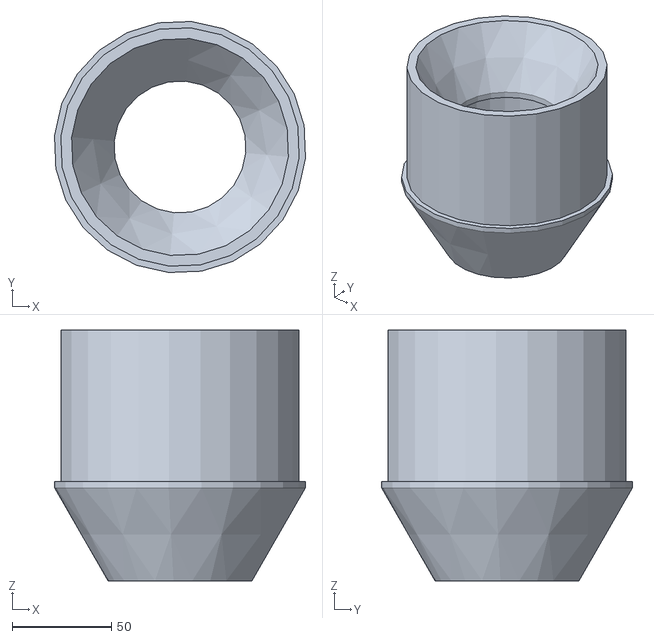
[picture p129: CAD file, 2024-09-16]
geometry_source/beamline/cad/Torus_Beam_Tube_Reducer_2.stl
126.5 x 126.5 x 126.2
