marcospreafico/clas12Tags/geometry_source/ltcc/cad/S1-BB.stl

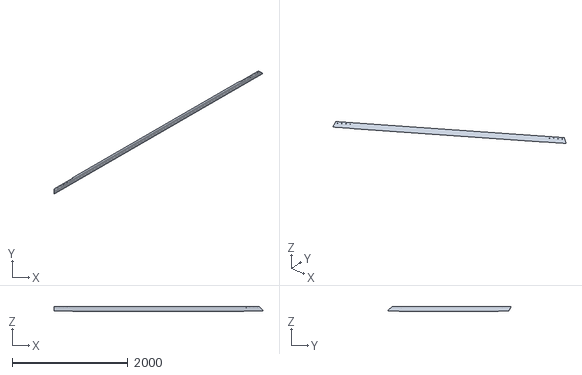
[picture p130: CAD file, 2023-02-14]
geometry_source/ltcc/cad/S1-BB.stl
3606.1 x 2126.0 x 89.8
