marcospreafico/clas12Tags/geometry_source/ltcc/cadTempRemoved/Epoxy.stl

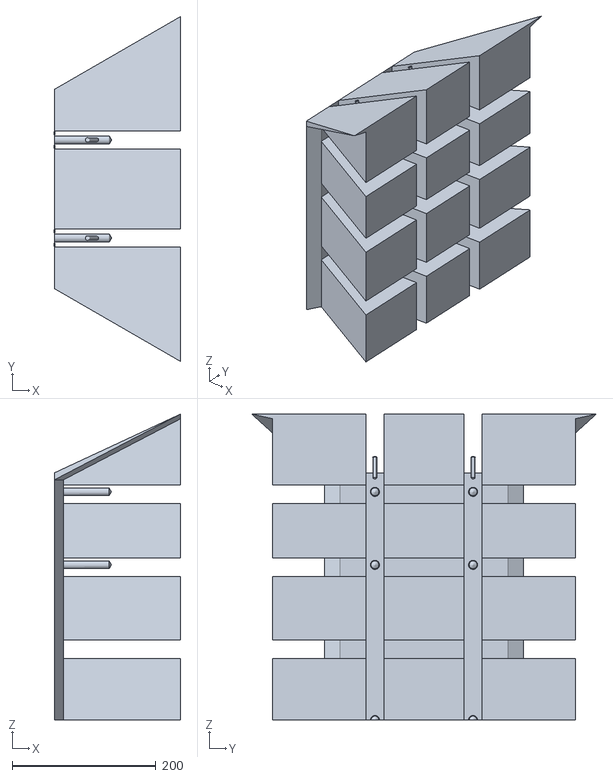
[picture p131: CAD file, 2023-02-14]
geometry_source/ltcc/cadTempRemoved/Epoxy.stl
175.8 x 480.1 x 425.8
