marcospreafico/clas12Tags/geometry_source/magnets/cad/Shield3.stl

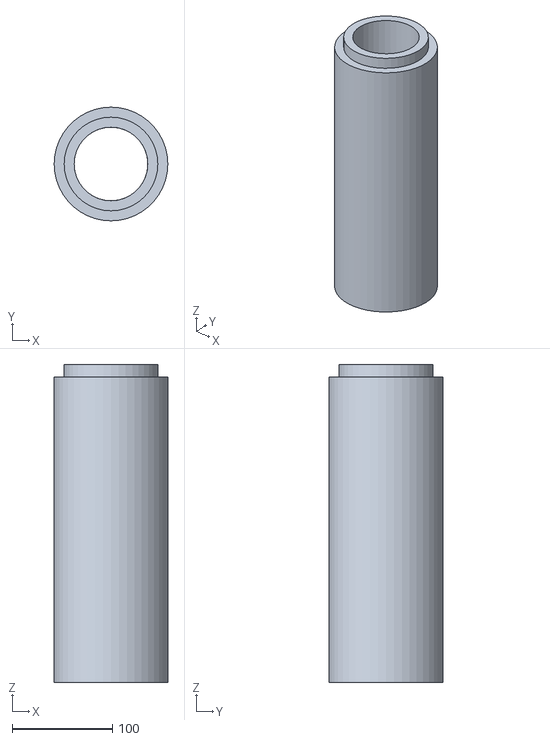
[picture p132: CAD file, 2023-02-14]
geometry_source/magnets/cad/Shield3.stl
113.5 x 113.5 x 317.5
