marcospreafico/clas12Tags/geometry_source/targets/cad_hdice/unit_PCTFE.stl

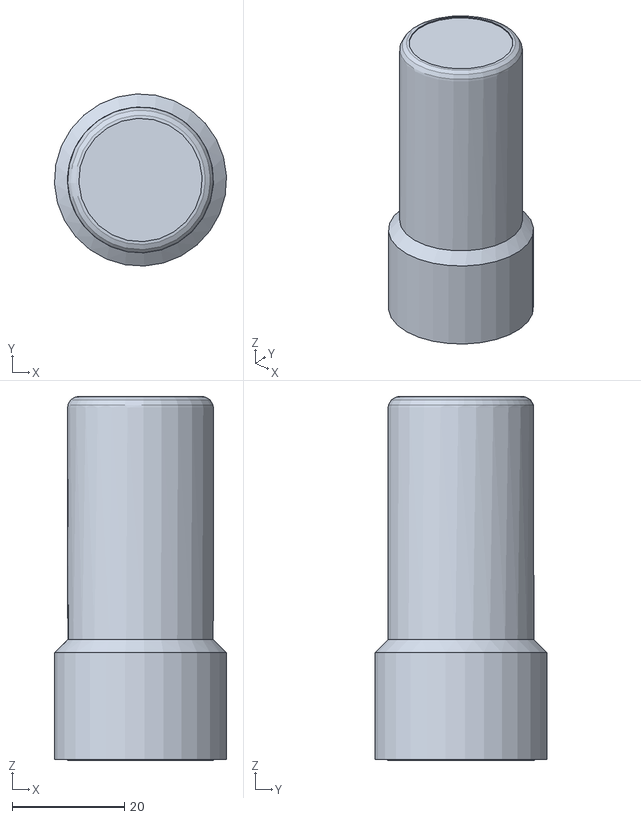
[picture p133: CAD file, 2023-02-14]
geometry_source/targets/cad_hdice/unit_PCTFE.stl
30.7 x 30.7 x 64.9
