marcospreafico/clas12Tags/geometry_source/targets/cad_transverse/Pumpline60mm.stl

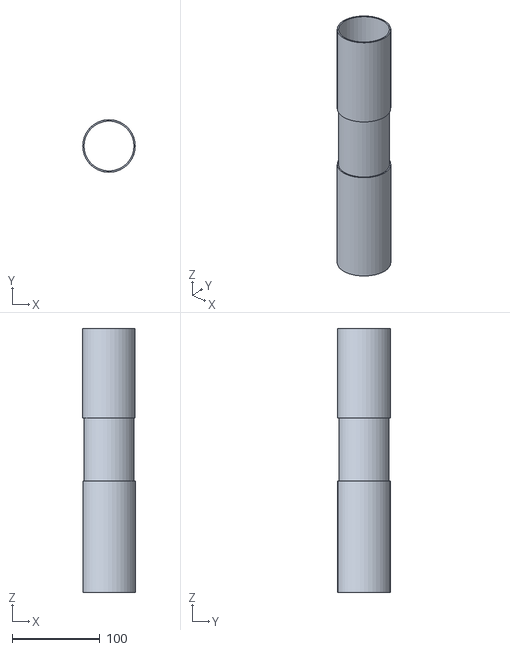
[picture p134: CAD file, 2023-02-14]
geometry_source/targets/cad_transverse/Pumpline60mm.stl
60.0 x 60.0 x 301.3
