marcospreafico/clas12Tags/geometry_source/targets/rge-dt/Al/Aluminum.stl

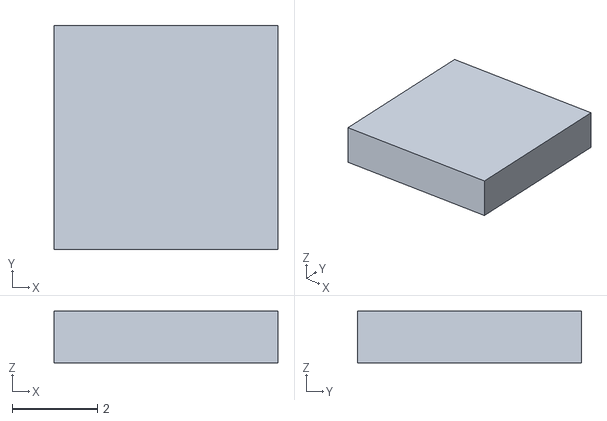
[picture p135: CAD file, 2024-10-23]
geometry_source/targets/rge-dt/Al/Aluminum.stl
5.25 x 5.25 x 1.21
