marcospreafico/clas12Tags/geometry_source/targets/rge-dt/C/Tin.stl

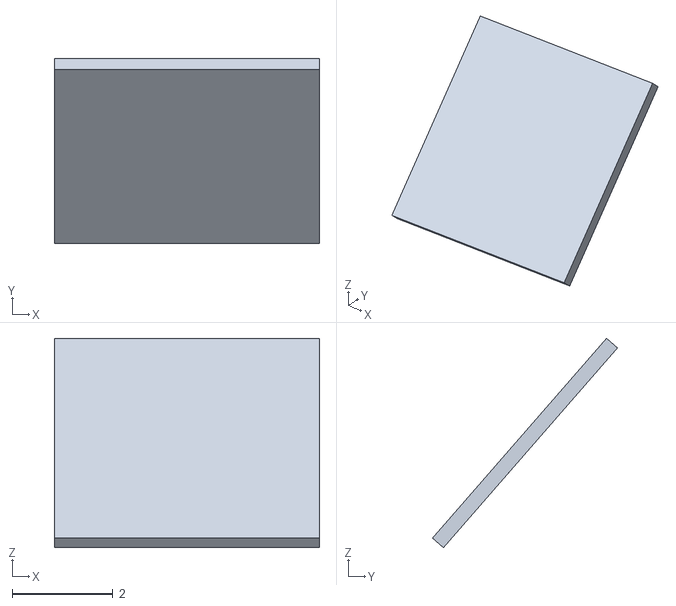
[picture p136: CAD file, 2024-10-23]
geometry_source/targets/rge-dt/C/Tin.stl
5.25 x 3.67 x 4.15
