marcospreafico/clas12Tags/geometry_source/targets/rge-dt/common/Tracks.stl

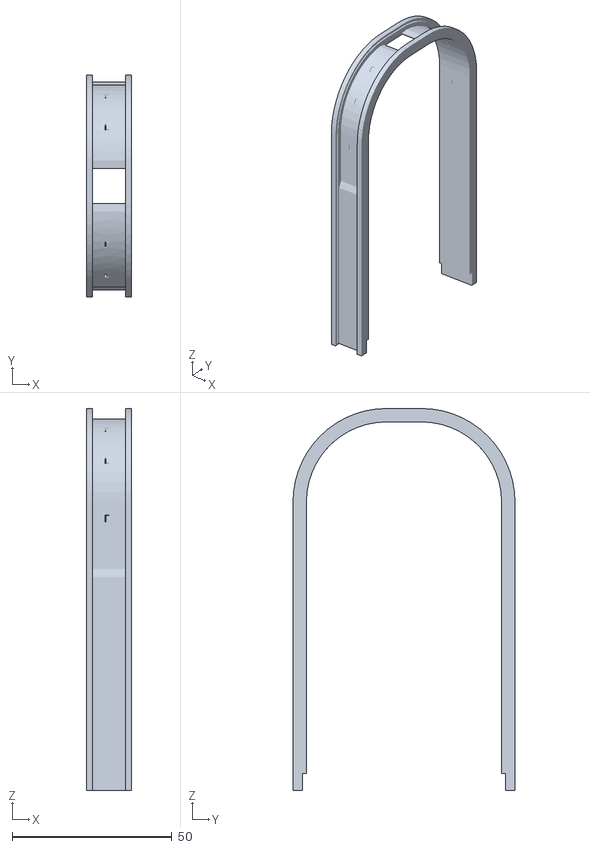
[picture p137: CAD file, 2024-10-23]
geometry_source/targets/rge-dt/common/Tracks.stl
14.2 x 69.4 x 119.4
