marcospreafico/clas12Tags/geometry_source/targets/rge-dt/Cu/Boxes.stl

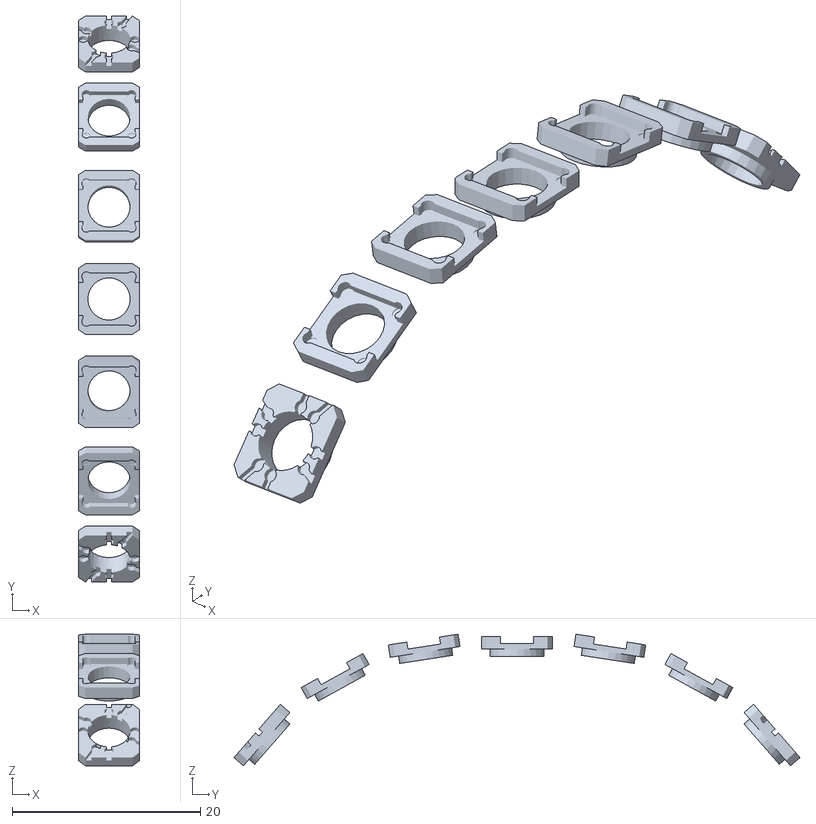
[picture p138: CAD file, 2024-10-23]
geometry_source/targets/rge-dt/Cu/Boxes.stl
6.50 x 60.1 x 14.0
