marcospreafico/clas12Tags/geometry_source/targets/rge-dt/Empty/Boxes.stl

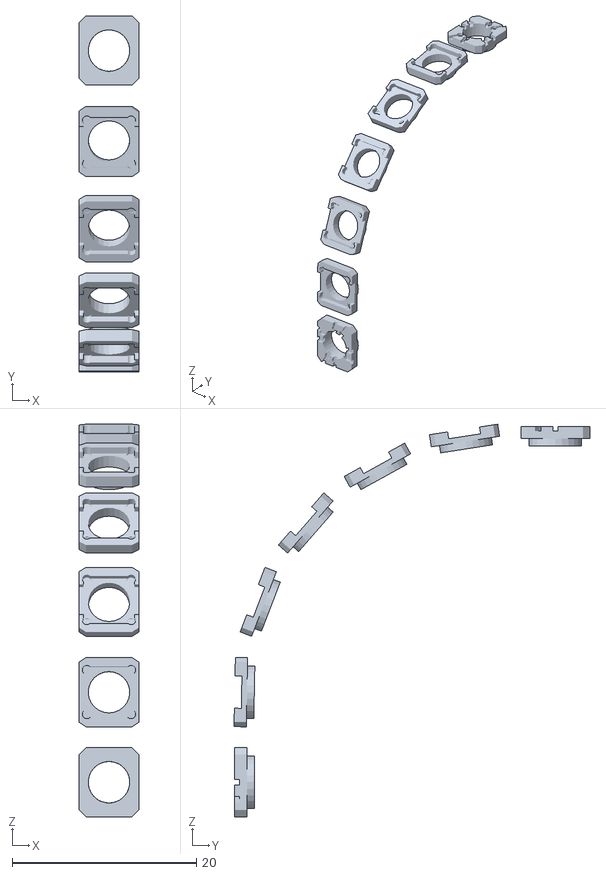
[picture p139: CAD file, 2024-10-23]
geometry_source/targets/rge-dt/Empty/Boxes.stl
6.50 x 38.6 x 42.6
