marcospreafico/clas12Tags/geometry_source/targets/rge-dt/Sn/Lead.stl

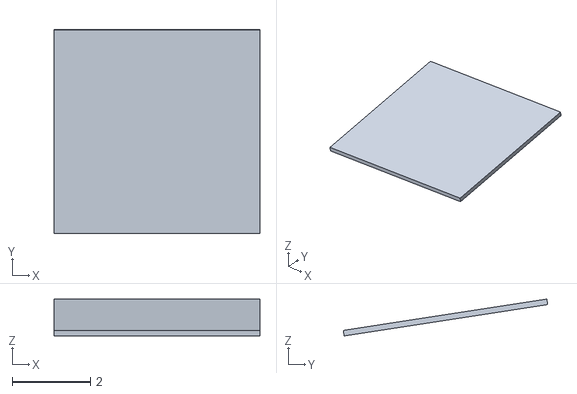
[picture p140: CAD file, 2024-10-23]
geometry_source/targets/rge-dt/Sn/Lead.stl
5.25 x 5.21 x 0.941
