marcospreafico/clas12Tags/experiments/atlas/cad/SmallBarrel.stl

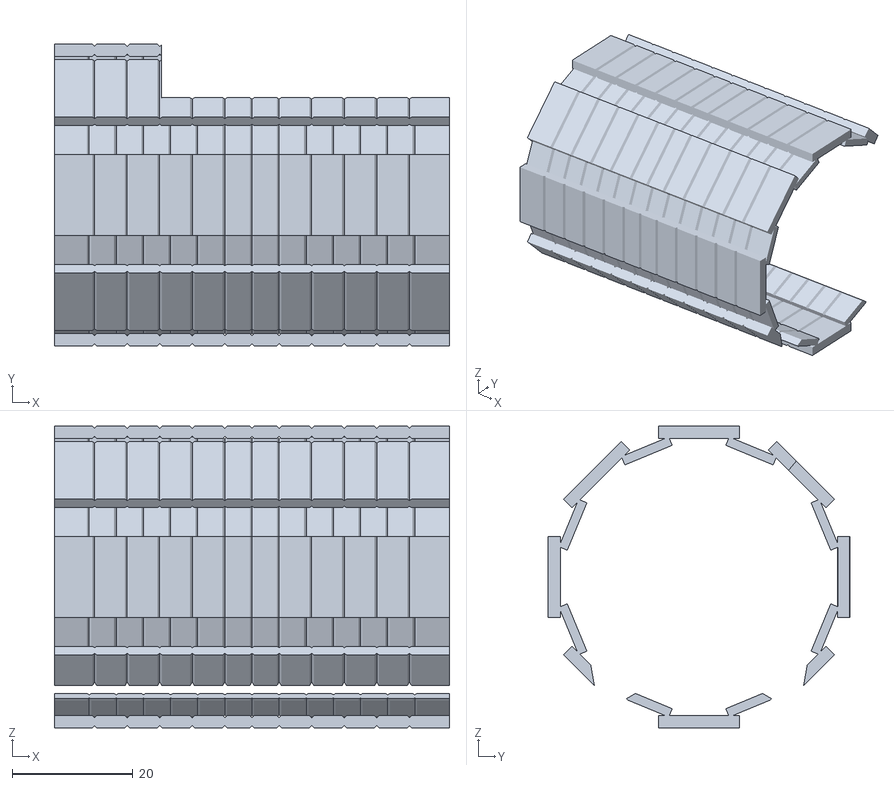
[picture p141: CAD file, 2023-02-14]
experiments/atlas/cad/SmallBarrel.stl
65.5 x 50.0 x 50.0
