marcospreafico/clas12Tags/experiments/clas12/ctof/cad_upstream/lgu06.stl

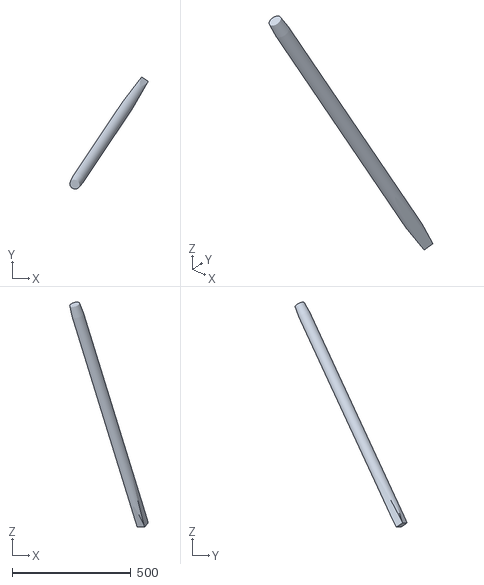
[picture p142: CAD file, 2023-02-14]
experiments/clas12/ctof/cad_upstream/lgu06.stl
330.0 x 471.1 x 945.6
