marcospreafico/clas12Tags/experiments/clas12/targets/cad_longitudinal/exchanger.stl

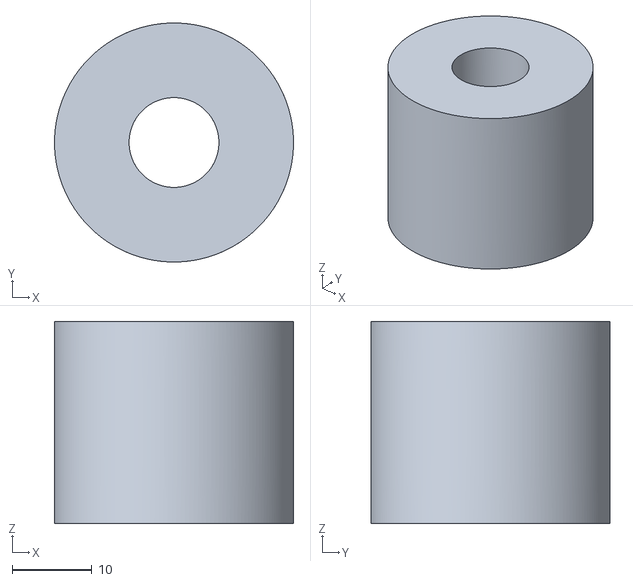
[picture p143: CAD file, 2023-02-14]
experiments/clas12/targets/cad_longitudinal/exchanger.stl
30.0 x 30.0 x 25.4
