marcospreafico/clas12Tags/geometry_source/beamline/cad/Torus_Exit_Shield_Lead_Fill.stl

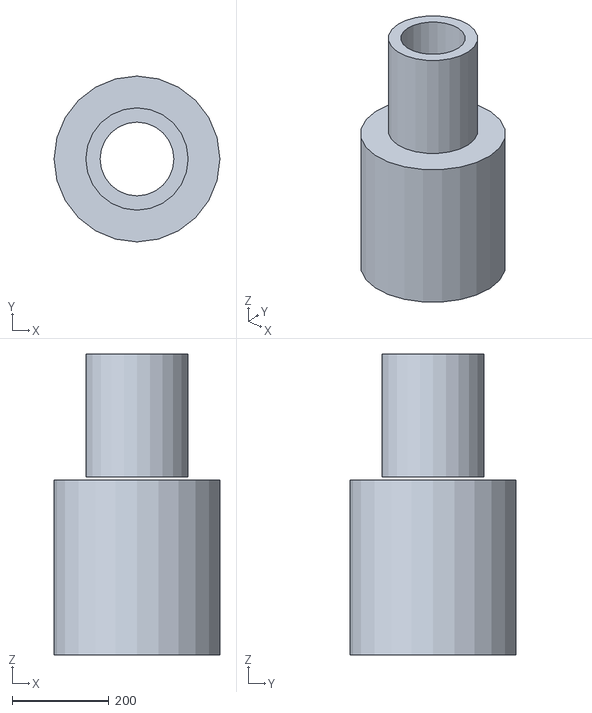
[picture p144: CAD file, 2024-09-16]
geometry_source/beamline/cad/Torus_Exit_Shield_Lead_Fill.stl
342.8 x 342.8 x 622.1
