marcospreafico/clas12Tags/(list of files, cad)

Other CAD files:
geometry_source/beamline/cad_transverse/forwardWedges/TGT-9000-1000-0001_MIR1m.stl
geometry_source/beamline/cad_transverse/midpointWedges/TGT-9000-1000-0000_MIRm.stl
geometry_source/targets/cad_extended/TargetAlWindowU.stl
geometry_source/targets/rge-dt/Empty/Carbon.stl
geometry_source/targets/rge-dt/Sn/Band.stl
geometry_source/beamline/cad_transverse/noWedges/TGT-9000-1000-0002m.stl
geometry_source/targets/cad_rgm/TargetAlWindowU.stl
geometry_source/targets/rge-dt/Al/Copper.stl
geometry_source/targets/rge-dt/Cu/Aluminum.stl
geometry_source/targets/rge-dt/Pb/Boxes.stl
geometry_source/beamline/cad_transverse/forwardWedges/TGT-9000-1000-0002m.stl
geometry_source/beamline/cad_transverse/noWedges/TGT-9000-1000-0000_MIRm.stl
geometry_source/targets/cad_rgd/needle_2.stl
experiments/clas12/ctof/cad_upstream/lgu25.stl
geometry_source/beamline/cad_transverse/forwardWedges/TGT-9000-1000-0000_MIRm.stl
geometry_source/beamline/cad_transverse/midpointWedges/TGT-9000-1000-0001_MIR1m.stl
geometry_source/targets/cad_rgd/needle_3.stl
geometry_source/targets/rge-dt/Pb/Copper.stl
experiments/clas12/ctof/cad/lgd40.stl
experiments/clas12/ctof/cad/lgd01.stl
experiments/clas12/ctof/cad/lgd02.stl
experiments/clas12/ctof/cad/lgd03.stl
experiments/clas12/ctof/cad/lgd04.stl
experiments/clas12/ctof/cad/lgd05.stl
experiments/clas12/ctof/cad/lgd06.stl
experiments/clas12/ctof/cad/lgd07.stl
experiments/clas12/ctof/cad/lgd08.stl
experiments/clas12/ctof/cad/lgd09.stl
experiments/clas12/ctof/cad/lgd10.stl
experiments/clas12/ctof/cad/lgd11.stl
experiments/clas12/ctof/cad/lgd12.stl
experiments/clas12/ctof/cad/lgd13.stl
experiments/clas12/ctof/cad/lgd14.stl
experiments/clas12/ctof/cad/lgd15.stl
experiments/clas12/ctof/cad/lgd16.stl
experiments/clas12/ctof/cad/lgd17.stl
experiments/clas12/ctof/cad/lgd18.stl
experiments/clas12/ctof/cad/lgd19.stl
experiments/clas12/ctof/cad/lgd20.stl
experiments/clas12/ctof/cad/lgd23.stl
experiments/clas12/ctof/cad/lgd24.stl
experiments/clas12/ctof/cad/lgd25.stl
experiments/clas12/ctof/cad/lgd26.stl
experiments/clas12/ctof/cad/lgd27.stl
experiments/clas12/ctof/cad/lgd28.stl
experiments/clas12/ctof/cad/lgd29.stl
experiments/clas12/ctof/cad/lgd30.stl
experiments/clas12/ctof/cad/lgd31.stl
experiments/clas12/ctof/cad/lgd32.stl
experiments/clas12/ctof/cad/lgd33.stl
experiments/clas12/ctof/cad/lgd34.stl
experiments/clas12/ctof/cad/lgd36.stl
experiments/clas12/ctof/cad/lgd37.stl
experiments/clas12/ctof/cad/lgd38.stl
experiments/clas12/ctof/cad/lgd39.stl
experiments/clas12/ctof/cad/lgd41.stl
experiments/clas12/ctof/cad/lgd42.stl
experiments/clas12/ctof/cad/lgd43.stl
experiments/clas12/ctof/cad/lgd44.stl
experiments/clas12/ctof/cad/lgd45.stl
experiments/clas12/ctof/cad/lgd46.stl
experiments/clas12/ctof/cad/lgd47.stl
experiments/clas12/ctof/cad/lgd48.stl
experiments/clas12/ctof/cad/sc01.stl
experiments/clas12/ctof/cad/sc02.stl
experiments/clas12/ctof/cad/sc03.stl
experiments/clas12/ctof/cad/sc04.stl
experiments/clas12/ctof/cad/sc05.stl
experiments/clas12/ctof/cad/sc06.stl
experiments/clas12/ctof/cad/sc07.stl
experiments/clas12/ctof/cad/sc08.stl
experiments/clas12/ctof/cad/sc09.stl
experiments/clas12/ctof/cad/sc10.stl
experiments/clas12/ctof/cad/sc11.stl
experiments/clas12/ctof/cad/sc12.stl
experiments/clas12/ctof/cad/sc14.stl
experiments/clas12/ctof/cad/sc15.stl
experiments/clas12/ctof/cad/sc16.stl
experiments/clas12/ctof/cad/sc17.stl
experiments/clas12/ctof/cad/sc18.stl
experiments/clas12/ctof/cad/sc19.stl
experiments/clas12/ctof/cad/sc20.stl
experiments/clas12/ctof/cad/sc21.stl
experiments/clas12/ctof/cad/sc22.stl
experiments/clas12/ctof/cad/sc23.stl
experiments/clas12/ctof/cad/sc24.stl
experiments/clas12/ctof/cad/sc25.stl
experiments/clas12/ctof/cad/sc26.stl
experiments/clas12/ctof/cad/sc27.stl
experiments/clas12/ctof/cad/sc28.stl
experiments/clas12/ctof/cad/sc29.stl
experiments/clas12/ctof/cad/sc30.stl
experiments/clas12/ctof/cad/sc31.stl
experiments/clas12/ctof/cad/sc33.stl
experiments/clas12/ctof/cad/sc34.stl
experiments/clas12/ctof/cad/sc35.stl
experiments/clas12/ctof/cad/sc36.stl
experiments/clas12/ctof/cad/sc37.stl
experiments/clas12/ctof/cad/sc38.stl
experiments/clas12/ctof/cad/sc39.stl
experiments/clas12/ctof/cad/sc40.stl
experiments/clas12/ctof/cad/sc41.stl
experiments/clas12/ctof/cad/sc42.stl
experiments/clas12/ctof/cad/sc43.stl
experiments/clas12/ctof/cad/sc44.stl
experiments/clas12/ctof/cad/sc45.stl
experiments/clas12/ctof/cad/sc46.stl
experiments/clas12/ctof/cad/sc47.stl
experiments/clas12/ctof/cad/sc48.stl
experiments/clas12/ctof/cad_upstream/lgu01.stl
experiments/clas12/ctof/cad_upstream/lgu02.stl
experiments/clas12/ctof/cad_upstream/lgu03.stl
experiments/clas12/ctof/cad_upstream/lgu04.stl
experiments/clas12/ctof/cad_upstream/lgu05.stl
experiments/clas12/ctof/cad_upstream/lgu07.stl
experiments/clas12/ctof/cad_upstream/lgu08.stl
experiments/clas12/ctof/cad_upstream/lgu09.stl
experiments/clas12/ctof/cad_upstream/lgu10.stl
experiments/clas12/ctof/cad_upstream/lgu12.stl
experiments/clas12/ctof/cad_upstream/lgu13.stl
experiments/clas12/ctof/cad_upstream/lgu14.stl
experiments/clas12/ctof/cad_upstream/lgu15.stl
experiments/clas12/ctof/cad_upstream/lgu16.stl
experiments/clas12/ctof/cad_upstream/lgu17.stl
experiments/clas12/ctof/cad_upstream/lgu18.stl
experiments/clas12/ctof/cad_upstream/lgu19.stl
experiments/clas12/ctof/cad_upstream/lgu20.stl
experiments/clas12/ctof/cad_upstream/lgu21.stl
experiments/clas12/ctof/cad_upstream/lgu23.stl
experiments/clas12/ctof/cad_upstream/lgu24.stl
experiments/clas12/ctof/cad_upstream/lgu26.stl
experiments/clas12/ctof/cad_upstream/lgu27.stl
experiments/clas12/ctof/cad_upstream/lgu28.stl
experiments/clas12/ctof/cad_upstream/lgu29.stl
experiments/clas12/ctof/cad_upstream/lgu30.stl
experiments/clas12/ctof/cad_upstream/lgu31.stl
experiments/clas12/ctof/cad_upstream/lgu32.stl
experiments/clas12/ctof/cad_upstream/lgu33.stl
experiments/clas12/ctof/cad_upstream/lgu34.stl
experiments/clas12/ctof/cad_upstream/lgu35.stl
experiments/clas12/ctof/cad_upstream/lgu36.stl
experiments/clas12/ctof/cad_upstream/lgu38.stl
experiments/clas12/ctof/cad_upstream/lgu39.stl
experiments/clas12/ctof/cad_upstream/lgu40.stl
experiments/clas12/ctof/cad_upstream/lgu41.stl
experiments/clas12/ctof/cad_upstream/lgu42.stl
experiments/clas12/ctof/cad_upstream/lgu43.stl
experiments/clas12/ctof/cad_upstream/lgu45.stl
experiments/clas12/ctof/cad_upstream/lgu46.stl
experiments/clas12/ctof/cad_upstream/lgu47.stl
experiments/clas12/ctof/cad_upstream/lgu48.stl
experiments/clas12/rich/cad/Layer_201_component_10_m1.stl
experiments/clas12/rich/cad/Layer_201_component_10_m2.stl
experiments/clas12/rich/cad/Layer_201_component_11_m1.stl
experiments/clas12/rich/cad/Layer_201_component_11_m2.stl
experiments/clas12/rich/cad/Layer_201_component_12_m1.stl
experiments/clas12/rich/cad/Layer_201_component_12_m2.stl
experiments/clas12/rich/cad/Layer_201_component_13_m1.stl
experiments/clas12/rich/cad/Layer_201_component_13_m2.stl
experiments/clas12/rich/cad/Layer_201_component_14_m1.stl
experiments/clas12/rich/cad/Layer_201_component_14_m2.stl
experiments/clas12/rich/cad/Layer_201_component_15_m1.stl
experiments/clas12/rich/cad/Layer_201_component_15_m2.stl
experiments/clas12/rich/cad/Layer_201_component_16_m1.stl
experiments/clas12/rich/cad/Layer_201_component_16_m2.stl
experiments/clas12/rich/cad/Layer_201_component_1_m1.stl
experiments/clas12/rich/cad/Layer_201_component_1_m2.stl
experiments/clas12/rich/cad/Layer_201_component_2_m1.stl
experiments/clas12/rich/cad/Layer_201_component_2_m2.stl
experiments/clas12/rich/cad/Layer_201_component_3_m1.stl
experiments/clas12/rich/cad/Layer_201_component_3_m2.stl
experiments/clas12/rich/cad/Layer_201_component_4_m1.stl
experiments/clas12/rich/cad/Layer_201_component_4_m2.stl
experiments/clas12/rich/cad/Layer_201_component_5_m1.stl
experiments/clas12/rich/cad/Layer_201_component_5_m2.stl
experiments/clas12/rich/cad/Layer_201_component_6_m1.stl
experiments/clas12/rich/cad/Layer_201_component_6_m2.stl
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
