marcospreafico/clas12Tags/release_notes/5.12.md

## Based on Coatjava Release 12.0.4t

# Release notes

- Added api files from gemc/api 
- New Cad import mechanism
- Ci includes comparison between TEXT and SQLITE geometry and output
- Added geometry source: gemc/detectors/clas12 moved to geometry_source
- Fixed materials for LTCC WC
- PERL API improved in handling of empty strings
- Detectors ready for SQLITE:
	- EC
    - PCAL
    - DC
    - FTOF
    - CTOF
    - CND
    - BST
    - HTCC
    - Micromegas
    - LTCC
    - RICH
    - FT
    - Beamline
    - Magnets

<br/>
<hr/>

 # Environment on ifarm / cvmfs

```
module use /cvmfs/oasis.opensciencegrid.org/jlab/hallb/clas12/sw/modulefiles 
module load clas12
module switch gemc/5.12

gemc -v 

  > gemc version: gemc 5.11

  > Environment:

  > FIELD_DIR: /u/scigroup/cvmfs/geant4/noarch/data/magfield
  > GEMC_DATA_DIR: /u/scigroup/cvmfs/geant4/almalinux9-gcc11/clas12Tags/dev
  > G4DATA_DIR: /u/scigroup/cvmfs/geant4/almalinux9-gcc11/geant4/10.7.4/data/Geant4-10.7.4/data
  > G4_VERSION: 10.7.4
  > G4INSTALL: /u/scigroup/cvmfs/geant4/almalinux9-gcc11/geant4/10.7.4
