marcospreafico/clas12Tags/release_notes/dev.md

## Based on Coatjava Release 12.0.4t

# Release notes

## In progress

- Torus + Shielding beamline CAD geometry (in progress) 
- Several issues with RG-F target #236 (in progress)
- DC v2

<br/>
<hr/>

 # Environment on ifarm / cvmfs

```
module use /cvmfs/oasis.opensciencegrid.org/jlab/hallb/clas12/sw/modulefiles 
module load clas12
module switch gemc/dev

gemc -v 

  > gemc version: gemc 5.11

  > Environment:

  > FIELD_DIR: /u/scigroup/cvmfs/geant4/noarch/data/magfield
  > GEMC_DATA_DIR: /u/scigroup/cvmfs/geant4/almalinux9-gcc11/clas12Tags/dev
  > G4DATA_DIR: /u/scigroup/cvmfs/geant4/almalinux9-gcc11/geant4/10.7.4/data/Geant4-10.7.4/data
  > G4_VERSION: 10.7.4
  > G4INSTALL: /u/scigroup/cvmfs/geant4/almalinux9-gcc11/geant4/10.7.4
