marcospreafico/clas12Tags/geometry_source/targets/target__parameters_rga_spring2018.txt

target_zpos   		|  -19.00  | mm  |  Survey target position 					| Maurizio Ungaro for the survey group   | ungaro@jlab.org | link to pdf drawing | variable name on the drawing | Bob Miller | 04/12/2025
