marcospreafico/clas12Tags/source/hitprocess/clas12/rich_hitprocess.cc

// G4 headers
#include "G4Poisson.hh"
#include "Randomize.hh"

// ccdb
#include <CCDB/Calibration.h>
#include <CCDB/Model/Assignment.h>
#include <CCDB/CalibrationGenerator.h>

using namespace ccdb;

// CLHEP units
#include "CLHEP/Units/PhysicalConstants.h"

using namespace CLHEP;

// gemc headers
#include "rich_hitprocess.h"

static richConstants
initializeRICHConstants(int runno, string digiVariation = "default", string digiSnapshotTime = "no", bool accountForHardwareStatus = false) {
  // TODO: with TDC simulation class from Marco M., time calibration information maybe not necessary
  richConstants richc;
  if (runno == -1) return richc;
  
  string timestamp = "";
  if(digiSnapshotTime != "no") {
    timestamp = ":"+digiSnapshotTime;
  }
  
  // database
  richc.runNo = runno;
  
  //	richc.date       = "2016-03-15";
  if(getenv ("CCDB_CONNECTION") != nullptr)
    richc.connection = (string) getenv("CCDB_CONNECTION");
  else
    richc.connection = "mysql://clas12reader@clasdb.jlab.org/clas12";
  
  unique_ptr<Calibration> calib(CalibrationGenerator::CreateCalibration(richc.connection));
  
  return richc;
}


// digitized info integrated over hit
// changed to match data.json definition of RICH::tdc 

map<string, double> rich_HitProcess :: integrateDgt(MHit* aHit, int hitn)
{        
	map<string, double> dgtz;

	trueInfos tInfos(aHit);

        vector<identifier> identity = aHit->GetId();
	vector<double> time = aHit->GetTime();
        int idsector = identity[0].id;
	
	// tdc bank expects tile number
	int idpmt = identity[1].id;
	int tile = richc.pmtToTile[idpmt-1];

	// tdc bank: readout channel number
	// pixel, order, tdc already set in processID
        int idpixel = identity[2].userInfos[2];
	int marocChannel = richc.anodeToMaroc[idpixel-1];
	int tileChannel = marocChannel + (richc.pmtToTilePosition[idpmt-1]-1)*64;
	
	int order = identity[2].userInfos[0];
	
	// tdc: timing from PMT simulation (in proccessID) + hit time
	double tdc = identity[2].userInfos[1] + time[0];
	writeHit = true;
	rejectHitConditions = false;

	int pmtType = 12700;
	// sector 4: mix of H12700 and H8500
	if(idsector == 4){
	  pmtType = richc.pmtType[idpmt-1];
	}
	double energy = aHit->GetEs()[0]/electronvolt;
	double qeff = 0;
	
	if(pmtType == 8500){
	  for(int i = 0; i < richc.nQEbinsH8500; i++){
	    if(energy < richc.Ene_H8500[i] && energy > richc.Ene_H8500[i+1]){
	      if( std::abs(energy - richc.Ene_H8500[i]) < std::abs(energy - richc.Ene_H8500[i+1])){
		qeff = richc.QE_H8500[i];
	      }
	      else{
		qeff = richc.QE_H8500[i+1];
	      }
	      break;	    	    
	    }
	  }
	}
	else if(pmtType == 12700){
	  for(int i = 0; i < richc.nQEbinsH12700; i++){
	    if(energy < richc.Ene_H12700[i] && energy > richc.Ene_H12700[i+1]){
	      if( std::abs(energy - richc.Ene_H12700[i]) < std::abs(energy - richc.Ene_H12700[i+1])){
		qeff = richc.QE_H12700[i];
	      }
	      else{
		qeff = richc.QE_H12700[i+1];
	      }
	      break;	    	    
	    }
	  }	  
	}
	
	
	// applying quantum efficiency from thrown random value set in integrateDgt
	if( identity[2].userInfos[3] > qeff && !aHit->isElectronicNoise) {
	  writeHit = false;
	}
	dgtz["hitn"]   = hitn;
	dgtz["sector"] = idsector; 
	dgtz["layer"] = tile;
	dgtz["component"] = tileChannel;
	dgtz["TDC_TDC"] = convert_to_precision(tdc);
	dgtz["TDC_order"] = order;
	return dgtz;
}

#include "G4VVisManager.hh"
#include "G4Circle.hh"
#include "G4VisAttributes.hh"
#include "G4ParticleTable.hh"

vector<identifier> rich_HitProcess :: processID(vector<identifier> id, G4Step* aStep, detector Detector)
{
        vector<identifier> yid = id;
        // id[0]: sector
        // id[1]: pmt
        // id[2]: pixel        
	
        G4StepPoint   *prestep   = aStep->GetPreStepPoint();
        G4StepPoint   *poststep  = aStep->GetPostStepPoint();
        G4ThreeVector   xyz    = poststep->GetPosition();                                        ///< Global Coordinates of interaction                          
	G4ThreeVector  Lxyz    = prestep->GetTouchableHandle()->GetHistory()                     ///< Local Coordinates of interaction                           
        ->GetTopTransform().TransformPoint(xyz);
	
	int pixel = getPixelNumber(Lxyz);

	G4ThreeVector pixelCenterLocal = getPixelCenter(pixel);
	G4ThreeVector pixelCenterGlobal = prestep->GetTouchableHandle()->GetHistory()->GetTopTransform().Inverse().TransformPoint(pixelCenterLocal);

	int idsector = yid[0].id;
        int pmt = yid[1].id;
        int pmtType = 12700;
	// sector 4: mix of H8500 and H12700
        if(idsector==4){ 
          pmtType = richc.pmtType[pmt-1];
        }
	RichPixel richPixel(pmtType);
	richPixel.Clear();
	
	double t1 = -1;
	double t2 = -1;
	if(richPixel.GenerateTDC(1, 0)){
	  // generating TDC
	  t1 = richPixel.get_T1();
	  t2 = richPixel.get_T2();	  
	}
	
	for(int i = 0; i < 3; i++){
	  identifier idtemp;
	  idtemp.name = id[i].name;
	  idtemp.rule = id[i].rule;
	  idtemp.id = id[i].id;
	  idtemp.TimeWindow = id[i].TimeWindow;
	  idtemp.TrackId = id[i].TrackId;
	  
	  yid.push_back(idtemp);
	}
	
	double QEthrow = G4UniformRand();
	yid[2].id = pixel;	  
	yid[2].userInfos.clear();
	yid[2].userInfos.push_back(double(1)); // TDC_order
	yid[2].userInfos.push_back(double(t1)); // TDC_tdc
	yid[2].userInfos.push_back(double(pixel)); // pixel
	yid[2].userInfos.push_back(QEthrow); // thrown random value for quantum eff.
	
	yid[5].id = pixel;
	yid[5].userInfos.clear();
	yid[5].userInfos.push_back(double(0));
	yid[5].userInfos.push_back(double(t2)); // TDC_tdc
	yid[5].userInfos.push_back(double(pixel));
	yid[5].userInfos.push_back(QEthrow); // thrown random value for quantum eff.
	
	yid[2].id_sharing = .5;
	yid[5].id_sharing = .5;
	
	return yid;
}

map< string, vector <int> >  rich_HitProcess :: multiDgt(MHit* aHit, int hitn)
{
	map< string, vector <int> > MH;
	return MH;
}


void rich_HitProcess::initWithRunNumber(int runno) {
    string digiVariation = gemcOpt.optMap["DIGITIZATION_VARIATION"].args;
    string digiSnapshotTime = gemcOpt.optMap["DIGITIZATION_TIMESTAMP"].args;

    if (richc.runNo != runno) {
        //		cout << " > Initializing " << HCname << " digitization for run number " << runno << endl;
        richc = initializeRICHConstants(runno, digiVariation, digiSnapshotTime, accountForHardwareStatus);
        richc.runNo = runno;
    }
}

// - electronicNoise: returns a vector of hits generated / by electronics.
vector<MHit*> rich_HitProcess :: electronicNoise()
{

  vector<MHit*> noiseHits;
  /*
  // id[0]: sector
        // id[1]: pmt
        // id[2]: pixel


	for(int j = 0; j < richc.nRich; j++){
	  int nHitThrow = (int) G4Poisson(richc.avgNDarkHits);
	  int sector;
	  if(j == 0){
	    sector = 4;
	  }
	  else{
	    sector = 1;
	  }
	  for(int i = 0; i < nHitThrow; i++){
	  
	    int noisypmt = (int) (richc.npmt * G4UniformRand() + 1);
	    int noisypixel = (int) (richc.npixel * G4UniformRand() + 1);
	    double noisetime = G4UniformRand() * richc.timeWindowDefault;
	    //cout << "noisy i: " << i << " pmt: " << noisypmt << " pixel: " << noisypixel << endl;
	    vector<identifier> idnoise;
	    for(int j = 0; j < 3; j++){
	      identifier idtemp;
	      idnoise.push_back(idtemp);
	    }
	    idnoise[0].id = sector;
	    idnoise[1].id = noisypmt;
	    idnoise[2].id = noisypixel;
	    
	    MHit *hit = new MHit(3*eV,  noisetime, idnoise, 0); 
	    noiseHits.push_back(hit);
	  }
	}
  */	
	return noiseHits;
}


// - charge: returns charge/time digitized information / step
map<int, vector<double> > rich_HitProcess::chargeTime(MHit *aHit, int hitn) {
    map<int, vector<double> > CT;

    return CT;
}

// - voltage: returns a voltage value for a given time. The input are charge value, time
double rich_HitProcess::voltage(double charge, double time, double forTime) {
    return 1.0;
}


// this static function will be loaded first thing by the executable
richConstants rich_HitProcess::richc = initializeRICHConstants(-1);


// PMT local position to pixel number
int rich_HitProcess::getPixelNumber(G4ThreeVector  Lxyz){
  // H8500:
  // 6.08mm for small
  // 6.26mm for large
  // H12700:
  // 6mm for small
  // 6.25mm for large
  // test: treating all as H12700
  // Pixel 1 is top left: -max x, +max y ?  
  double edge_small = 6.;
  
  double xloc = Lxyz.x(); //mm
  double yloc = Lxyz.y();
  
  int nx = int(abs(xloc/edge_small));
  int ny = int(abs(yloc/edge_small));
  int direcx = (xloc/abs(xloc));
  int direcy = (yloc/abs(yloc));
  
  if (nx>3) nx = 3;
  if (nx<-3) nx = -3;
  if (ny>3) ny = 3;
  if (ny<-3) ny = -3;
  
  int xpix = 0;
  int ypix = 0;
  if( nx > 0 && direcx == 1){
    xpix = -1*nx + 4;
  }
  if(nx == 0 && direcx == 1){
    xpix = 4;
  }
  if(nx == 0 && direcx == -1){
    xpix = 5;
  }
  if(nx > 0 && direcx == -1){
    xpix = (nx+1) + 4;
  }

  
  if( ny > 0 && direcy == 1){
    ypix = -1*ny + 4;
  }
  if(ny == 0 && direcy == 1){
    ypix = 4;
  }
  if(ny == 0 && direcy == -1){
    ypix = 5;
  }
  if(ny > 0 && direcy == -1){
    ypix = (ny+1) + 4;
  }

  return (int ((ypix-1)*8 + xpix));
}

G4ThreeVector rich_HitProcess::getPixelCenter(int pixel) {
    // center is (0,0)
    // 1 should be -x, -y
    int xpix = int((pixel - 1) % 8) + 1;
    int ypix = int((pixel - 1) / 8) + 1;
    double edge_large = 6.25;
    double edge_small = 6.;

    double xpos = 0;
    double ypos = 0;

    if (xpix == 1) {
        xpos += (3 * edge_small + 0.5 * edge_large);
    }
    if (xpix == 8) {
        xpos -= (3 * edge_small + 0.5 * edge_large);
    }

    if (ypix == 1) {
        ypos += (3 * edge_small + 0.5 * edge_large);
    }
    if (ypix == 8) {
        ypos -= (3 * edge_small + 0.5 * edge_large);
    }

    if (xpix > 1 && xpix <= 4) {
        xpos += -1 * ((xpix - 4) - 0.5) * edge_small;
    }
    if (xpix >= 5 && xpix < 8) {
        xpos += -1 * (xpix - 5 + 0.5) * edge_small;
    }

    if (ypix > 1 && ypix <= 4) {
        ypos += -1 * ((ypix - 4) - 0.5) * edge_small;
    }
    if (ypix >= 5 && ypix < 8) {
        ypos += -1 * (ypix - 5 + 0.5) * edge_small;
    }

    return G4ThreeVector(xpos, ypos, -0.05);


}

/* ---------------------------------------------------*/
RichPixel::RichPixel(int t)
{

  if ( (t == 8500) || (t == 12700) ) {
    InitPmt(t);
  }
  else {
    printf("ERROR: pmt type %d not known\n", t);
    return;
  }


  InitMaroc();

  if (t == 8500) {
    TimeResol = TimeResol_H8500;
  }
  else if (t == 12700) {
    TimeResol = TimeResol_H12700;
  }


  Clear();

  return;
}
/* ---------------------------------------------------*/
void RichPixel::InitPmt(int t, double g)
{

  PmtType = t;
  Gain = g;

  if (t == 8500) {
    nStages = 12;
    d1Ratio = 1;
  }
  else if (t == 12700) {
    nStages = 10;
    d1Ratio = 2;
  }
  else {
    printf("ERROR: pmt type %d not known\n", t);
    return;
  }


  GN = pow( (Gain/d1Ratio), 1./nStages);
  G1 = d1Ratio * GN;



  return;
}
/* ---------------------------------------------------*/
void RichPixel::InitMaroc(double g, double th)
{

  MarocG = g;
  MarocThrF = th;

  ThresholdScale = 5;

  MarocThrCharge = ThresholdScale * (MarocThrF - 1) * StdTrhesholdDAC * DAC;



  /* charge to time conversion, saturated region */
  q0_t = 230;
  /* Values from Ctest data analysis                                                                                                                                                                            
    p_t[0] = 118.3;                                                                                                                                                                                             
  p_t[1] = -0.3134;                                                                                                                                                                                             
  p_t[2] = 0.002787;                                                                                                                                                                                            
  p_t[3] = -1.382e-5;                                                                                                                                                                                           
  p_t[4] = 2.531e-8;                                                                                                                                                                                            
  */

  p_t[0] = 7.32 + 4;
  p_t[1] = -0.08027;
  p_t[2] = 0.0001407;
  p_t[3] = 0;
  p_t[4] = 0;


  /* charge to time conversion, linear region */
  //m_t = -0.00307; //value from CTest data analysis                                                                                                                                                            
  m_t = -0.00207;
  q_t = -m_t * q0_t;
  for (int i=0; i<5; i++) {
    q_t = q_t + p_t[i] * pow(q0_t, i);
  }


  /* from charge to duration */

  //p0_d = 80; //from CTest data                                                                                                                                                                                
  //p1_d = 170.1;  //from CTest data                                                                                                                                                                            

  p0_d = 68.19;
  p1_d = 60.1;

  /* parameter to shift doen the duration per 1 unit of MarocThrF */
  alphaD = 0.1;



  return;
}
/* ---------------------------------------------------*/
void RichPixel::InitReadout(int pmttype, double pmtgain, double marocgain, double marocthr)
{
  InitPmt(pmttype, pmtgain);
  InitMaroc(marocgain, marocthr);

  return;
}
/* ---------------------------------------------------*/
void RichPixel::Clear()
{
  npe = 0;

  qadc = 0;
  ADC = 0;

  qtdc = 0;
  pmt_time = 0;
  t1 = 0;
  t2 = 0;
  duration = 0;
  maroc_time = 0;
  hit_time = 0;

  return;
}
/* ---------------------------------------------------*/
bool RichPixel::GenerateTDC(int n0, double t0)
{

  hit_time = t0;

  GenerateNpe(n0);

  /* Applying the discriminator threshold */
  qtdc = npe * Qe * MarocG;
  if (qtdc > MarocMaxQ) qtdc = MarocMaxQ;
  if (qtdc < MarocThrCharge) return false;

  /* generating the leading edge */
  ChargeToTime();

  /* generating the trailing edge */
  ChargeToDuration();

  return true;
}
/* ---------------------------------------------------*/
bool RichPixel::GenerateADC(int n0, double t0)
{

  hit_time = t0;

  GenerateNpe(n0);

  /* Converting into ADC signal */
  qadc = npe*Qe * MarocG;
  if (qadc > MarocMaxQ) qadc = MarocMaxQ;

  ADC = Pedestal + (int)(DAC*qadc);

  /* Generating the TDC */
  GenerateTDCfromADC( qadc, t0);

  return true;
}
/* -------------------------------- */
void RichPixel::GenerateNpe(int n0)
{
  int nEle = n0;
  for (int n=0; n<nStages; n++) {
    double g = GN;
    if (n == 0) g = G1;

    int nIn = nEle;
    double nAve = g * nIn;
    nEle = G4Poisson(nAve);
    if (nEle == 0) nEle = n0;
  }
  npe = nEle;


  return;
}
/* -------------------------------------------------- */
void RichPixel::ChargeToTime()
{

  /* PMT time response */
  pmt_time = G4RandGauss::shoot(hit_time, TimeResol);


  /* MAROC time response */
  double qeff = qtdc / MarocThrF;
  double time = 0;
  if (qeff < q0_t) {
    for (int i=0; i<5; i++) {
      time = time + p_t[i] * pow(qeff, i);
    }
  }
  else {
    time = q_t + m_t * qeff;
  }
  maroc_time = time;


  t1 = pmt_time + maroc_time;


  return;
}
/* -------------------------------------------------- */
void RichPixel::ChargeToDuration()
{

  double qeff = qtdc;
  double p0_eff = p0_d;
  if (MarocThrF > 1) {
    p0_eff = p0_d * (1. - (MarocThrF-1)*alphaD);
  }
  else if (MarocThrF < 1) {
    p0_eff = p0_d * (1. - (1./MarocThrF-1)*alphaD);
  }

  duration = p0_eff * (1. - exp( -sqrt(qeff/p1_d) ) );
  t2 = t1 + duration;

  return;
}
/* ---------------------------------------------------*/
bool RichPixel::GenerateTDCfromADC(double qadc, double t0)
{

  /* PMT time response */
  pmt_time = G4RandGauss::shoot(hit_time, TimeResol);

  /* Applying the discriminator threshold */
  qtdc = qadc * MarocG;
  if (qtdc > MarocMaxQ) qtdc = MarocMaxQ;
  if (qtdc < MarocThrCharge) return false;

  /* generating the leading edge */
  ChargeToTime();

  /* generating the trailing edge */
  ChargeToDuration();


  return true;
}
void RichPixel::PrintPmt()
{

  printf("MAPMT H%d\n", PmtType);
  printf("  G=%f    nStages=%d   g1=%f   gN=%f\n", Gain, nStages, G1, GN);

  return;
}
/* -------------------------------------------------- */
void RichPixel::PrintMaroc()
{

  printf("MAROC setting\n");
  printf("  gain=%f   RelThreshold=%f   threshold=%f fC\n", MarocG, MarocThrF, MarocThrCharge);

  return;
}
/* -------------------------------------------------- */
void RichPixel::PrintEvent()
{

  printf("--------------------------------------------\n");
  printf("  hitT=%8.3f   \n", hit_time);
  printf("  pmtT=%8.3f  marocTime=%8.3f\n", pmt_time, maroc_time);
  printf("  Gene times:  T1=%8.3f  T2=%8.3f  D=%8.3f  \n", t1, t2, duration);
  printf("  Digi times:  T1=%4d      T2=%4d      D=%4d  \n", (int)get_T1(),(int) get_T2(), (int)get_Duration());


  return;
}
