marcospreafico/clas12Tags/source/hitprocess/clas12/micromegas/bmt_strip.cc

// gemc headers
#include "bmt_strip.h"
#include "Randomize.hh"

// c++ headers
#include <iostream>
#include <cmath>
#include <cstdlib>
#include <time.h>

// Veronique Ziegler (Dec. 3 2015)
// Note: this method only contains the constants for the third micromegas region,
// the constants for the other 2 are missing...
// M. Ungaro (Jan 26 2016)
// Updated to read constants at the beginning of each run
// M. Defurne (May 5 2017)
// Removed the loop over the number of electrons
// M. Ungaro (Jun 14 2019)
// Added target position 

// the routine to find the strip
vector<double> bmt_strip::FindStrip(int layer, int sector, G4ThreeVector lxyz, double Edep, bmtConstants bmtc)
{
	double lx = lxyz.x()/mm;
	double ly = lxyz.y()/mm;
	double lz = lxyz.z()/mm;
	
	int Nel = (int) (1e6*Edep/bmtc.w_i);
	// the return vector is always in pairs the first index is the strip number, the second is the Edep on the strip
	if (bmtc.HV_DRIFT[layer-1][sector-1]==0||bmtc.HV_STRIPS[layer-1][sector-1]==0) Nel=0;
	vector<double> strip_id;
	
	double Delta_drift = sqrt( lx*lx+ly*ly) - bmtc.RADIUS[layer-1];
	
	double phi = atan2(ly,lx) + Delta_drift*tan(bmtc.ThetaL)*cos(bmtc.Theta_Ls_Z)/bmtc.RADIUS[layer-1]; // Already apply the Lorentz Angle to find the ClosestStrip
	lz=lz + Delta_drift * tan(bmtc.ThetaL) * cos(bmtc.Theta_Ls_C); // Not sure useful, but take into account LorentzAngle deviation if
	
	int sector_bis=isInSector(layer,atan2(ly,lx),bmtc);
	// if(sector_bis!=0) cout << "WARNING: BMT hit outside active area" << endl;
	int strip_num = getClosestStrip(layer, sector_bis, phi, lz, bmtc);
	sigma = getSigma(layer, lx, ly, bmtc);
	sigma_phi = sigma/bmtc.RADIUS[layer-1];
	int cluster_size=0;
	if (bmtc.AXIS[layer-1]==0) cluster_size=bmtc.nb_sigma*sigma/bmtc.PITCH[layer-1][5]+1; //Compare to smallest pitch in C
	if (bmtc.AXIS[layer-1]==1) cluster_size=bmtc.nb_sigma*sigma_phi/bmtc.PITCH[layer-1][0]+1;
	
	double weight=0;
	if (strip_num>=1&&strip_num<=bmtc.NSTRIPS[layer-1]) weight=Weight_td(layer, strip_num, phi, lz, bmtc);
	
	if(Nel>0&&weight>0) { // if the track deposited energy is greater than the assumed ionization potential digitize
		
		strip_id.push_back(strip_num);
		strip_id.push_back(weight);
		
		// if the strip is found (i.e. the hit is within acceptance
		for(int istrip=1;istrip< cluster_size+1;istrip++) {
			//Check the strip after the closest strip
			if (strip_num+istrip<=bmtc.NSTRIPS[layer-1]) {
				weight=Weight_td(layer, strip_num+istrip, phi, lz, bmtc);
				if (weight>0){
					strip_id.push_back(strip_num+istrip);
					strip_id.push_back(weight);
					
				}
			}
			// Check the strip before the closest strip
			if (strip_num-istrip>=1) {
				weight=Weight_td(layer, strip_num-istrip, phi, lz, bmtc);
				if (weight>0){
					strip_id.push_back(strip_num-istrip);
					strip_id.push_back(weight);
				}
			}
		}
		
		// We have computed the weight with a gaussian distribution. But considering the few electrons, it makes no sense.
		int Nel_left=Nel;
		double renorm=0;
		double weight_this_strip;
		int Nel_this_strip=0;
		for (unsigned int i=0;i<strip_id.size()/2;i++){
			if (Nel_left==0||renorm==1){
				strip_id.at(2*i+1)=0;
			}
			if (renorm!=1&&Nel_left!=0){
				weight_this_strip=strip_id.at(2*i+1)/(1-renorm);
				Nel_this_strip=GetBinomial(Nel_left,weight_this_strip);
				if (Nel_this_strip==-1) cout<<Nel_left<<" -1  "<<weight_this_strip<<endl;
				renorm+=strip_id.at(2*i+1);
				strip_id.at(2*i+1)=Nel_this_strip;
				Nel_left-=Nel_this_strip;
				//cout<<layer<<" "<<sector_bis<<" "<<strip_id.at(2*i)<<"  "<<strip_id.at(2*i+1)<<endl;
			}
		}
		
		//Final check... Energy must be conserved unfortunately
		if (Nel_left<0) cout<<"Warning in BMT hitprocess!!!!!!!!"<<endl;
	}
	if (strip_id.size()==0)
	{ // Nel=0, consider the Edep is 0
		strip_id.push_back(-1);
		strip_id.push_back(-1);
	}
	
	return strip_id;
}


//
// param layer
// param x x-coordinate of the hit in the lab frame
// param y y-coordinate of the hit in the lab frame
// return the sigma in the azimuth direction taking the Lorentz angle into account
//
double bmt_strip::getSigma(int layer, double x, double y,  bmtConstants bmtc)
{ // sigma for Z-detectors
	
	double sigma = bmtc.SigmaDrift*(sqrt(x*x+y*y) - bmtc.RADIUS[layer-1])/cos(bmtc.ThetaL);
	
	return sigma;
	
}
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
