marcospreafico/clas12Tags/(commit log)

2023-02-14 clas12 tag version 4.4.0 on new repo
    [Aluminum.stl, BoreShield.stl, BottomPlate.stl, CFRP.stl, CenterTube.stl, DSShieldBackAss.stl, DSShieldBackCover.stl, DSShieldBackLead.stl]
2023-02-14 clas12 tag version 4.4.1
    [Transverse_target_for_simulation.FCStd, Transverse_target_for_simulation.stp, downCoils.stl, downRing.stl, ladder.stl, ladderSupport.stl, magnetSupport.stl, targetFrame.stl]
2023-02-14 clas12 tag version 4.4.2
    [AdditionalWindows.stp, Aluminum.stl, BeamPathExitWindow.stl, CFRP.stl, DownstreamRS.stl, InnerRSSheet.stl, InnerRSSheetMIR1.stl, Layer_201_component_1.stl]
2023-02-14 removed foam and adapter
    [TargetFoam.stl, TargetFoam2.stl, TargetFoam3.stl, TargetWindowAdapterTorlon.stl]
2023-02-24 updating 5.1
    [crystal_shell.stl, ddvcs_cal.FCStd, layout_calorimeter.stl, moeller_cone.stl]
2023-04-03 added web printout
2023-04-14 compatibility with apple silicon, silence warnings and using solenoid and torus filenames
2023-04-18 precision omly diff for micromegas, last-a-foam insertion for ec
2023-07-17 added cadrgm
    [TargetAlWindowU.stl, TargetBaseTubeTorlon.stl, TargetVacuumWindow50umAl.stl, scatteringChamber.stl]
2023-09-05 gcard changes for various detectors. target material fix for lHe. rich updates
    [RICH_s4.stl]
2023-09-11 time_in_ns in ctof, ecal, ftof, the ccs, fixed int
    [ctof_hitprocess.cc, ecal_hitprocess.cc, ftof_hitprocess.cc, htcc_hitprocess.cc, ltcc_hitprocess.cc]
2023-09-12 added rich adc to ignore schema list
2023-10-16 fix diff for .scons and correct urwell code
    [uRwell_strip.cc]
2023-10-16 fadc time is double not int, ft cal and hodo fix
    [band_hitprocess.cc, band_hitprocess.h, cnd_hitprocess.cc, cnd_hitprocess.h, ctof_hitprocess.cc, ctof_hitprocess.h, ecal_hitprocess.cc, ecal_hitprocess.h]
2024-01-24 added ec and fc README, removed obsolete fc volumes, removed rich_sector4 and added rich, elmo line airgap changes
    [Aluminum.stl, CFRP.stl, Layer_201_component_1.stl, Layer_201_component_10.stl, Layer_201_component_11.stl, Layer_201_component_12.stl, Layer_201_component_13.stl, Layer_201_component_14.stl]
2024-01-29 rich_sector4 generalized to rich, proper variations applied
    [Aluminum_s1.stl, Aluminum_s4.stl, CFRP_s1.stl, CFRP_s4.stl, Layer_201_component_10_s1.stl, Layer_201_component_10_s4.stl, Layer_201_component_11_s1.stl, Layer_201_component_11_s4.stl]
2024-02-21 adding sqlite geometry / materials factory. fixed vertex units . reorg release notes to include all
    [ahdc_hitprocess.cc, gemcUtils.cc, gemcUtils.h]
2024-02-21 fixed sqlite material factory
2024-02-21 working sqlite material factory
2024-02-23 adding bank and hit sqlite factories, fixed condition to scan detectors that caused TEXT factory to fail relative accounting
    [gbank.cc, gemcUtils.cc, gemcUtils.h]
2024-03-20 Eric updated alert geometry, documentation and gcards. rich modified STL volumes from Connor. Added README.md templates and uRwell gcard
    [Aluminum_s1.stl, Aluminum_s4.stl, CFRP_s1.stl, CFRP_s4.stl, ahdc__parameters_default.txt, ahdc__parameters_rga_fall2018.txt, atof__parameters_default.txt, atof__parameters_rga_fall2018.txt]
2024-03-20 from Whitney: fixed alert bank variable names
    [HitProcess_MapRegister.cc, hipo_output.h]
2024-03-28 added alert geo and gcards
    [atof__parameters_default.txt, atof__parameters_rga_fall2018.txt]
2024-05-02 moved DSS (downstream shield) volumes from beamline to torus where the apex is implemented (Raffella), ddvcs geo update, fixed raster options for LUND format, added new transverse solenoid map option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
    [DSShieldBackAss.stl, DSShieldBackCover.stl, DSShieldBackLead.stl, DSShieldFlange.stl, DSShieldFlangeAttachment.stl, DSShieldFrontAss.stl, DSShieldFrontCover.stl, DSShieldFrontLead.stl]
2024-05-02 moved DSS (downstream shield) volumes from beamline to torus where the apex is implemented (Raffella)
    [DSShieldBackAss.stl, DSShieldBackCover.stl, DSShieldBackLead.stl, DSShieldFlange.stl, DSShieldFlangeAttachment.stl, DSShieldFrontAss.stl, DSShieldFrontCover.stl, DSShieldFrontLead.stl]
2024-05-02 Update gemc.cc
    release 5.9 uses geant4 10.6 with old photon pid
2024-06-17 rg-d target assembly by Lamia
    [cellAlwindow.stl, cellendcap.stl, eg2p_main_rode.stl, endcapAlwindow.stl, firstRohacellSpacer.stl, firsttargframe.stl, needle_1.stl, needle_2.stl]
2024-07-18 material database updated with MIE scattering entries and diff script improvements
2024-09-03 tungsten material update to beamline_W instead of pure W
2024-09-11 volumes are replaced by native volumes to make sure thickness is correct
    [TargetAlWindowD.stl, TargetAlWindowU.stl]
2024-09-11 removed obsolete vacuumLine cad dir
    [connectTorusToDownstreamPipe.stl, connectUpstreamToTorusPipe.stl, downstreamPipeFlange.stl]
2024-09-16 Added beamline components and adjusted vacuum line downstream of the torus, will link upcoming CLAS Note
    [Apex_Shield_Lead_Fill.stl, Apex_Shield_PCAL_Hub.stl, BottomPlate.stl, Downstream_Beam_tube_Segment_1.stl, Downstream_Beam_tube_Segment_2.stl, Epoxy.stl, FrontPlate.stl, Mount.stl]
2024-10-23 RGE double target implementation, Updated CAD volumes for RICH, added alert geometry
    [AaRICH_m1.stl, AaRICH_m2.stl, Aluminum.stl, Aluminum_m1.stl, Aluminum_m2.stl, Aluminum_s1.stl, Aluminum_s4.stl, Band.stl]
2024-10-24 adding michel_9mmcopper variation with increased DriftCuElectrode thickness
    [micromegas__parameters_michel_9mmcopper.txt]
2024-11-14 added various gcards, adding source and api to artifacts
    [ftof__parameters_original.txt]
2024-11-15 re-added ddvcs, dc geometry and digitization with hexagonal cells
    [ftof__parameters_default.txt, ftof__parameters_rga_fall2018.txt]
2024-11-20 added htcc cad variations, pcal sqlite gcards. should not trigger validation for this branch
    [htccCone.stl, htccMollerCone.stl, htccMollerConeExt.stl]
2024-12-03 ltcc variations renaming rgb_winter2019 to rgb_winter2020 and rgm to rgm_winter202. added ltcc text gcards for various variations. cad_cone cad files moved to cad
    [WC_L.stl, WC_M.stl, WC_S.stl, ltcc__parameters_default.txt]
2024-12-04 added sqlite cad and mirror factories
2024-12-05 added sqlite cad and mirrors gemc api
2024-12-05 rename target cad directories to a common cad prefix. target and magnets cad.gxml renamed cad_default.gxml
    [80KCan_Al.stl, 80KCan_SS.stl, AdditionalWindows.FCStd, AdditionalWindows.stp, BeamPathExitWindow.stl, DownstreamRS.stl, IBC3_snout-updated on 20201015.stp, InnerRSSheet.stl]
2024-12-06 removed ctof duplicated cad directories, added shared cad folders and gcards
    [lgd01.stl, lgd02.stl, lgd03.stl, lgd04.stl, lgd05.stl, lgd06.stl, lgd07.stl, lgd08.stl]
2024-12-09 rich adapted to new cad import
    [AaRICH_m1.stl, AaRICH_m2.stl, Aluminum_m1.stl, Aluminum_m2.stl, CFRP_m1.stl, CFRP_m2.stl, Layer_201_component_10_m1.stl, Layer_201_component_10_m2.stl]
2024-12-11 cadBeamline, cadBeamlineFTOFF condensed to cad using new cad import
    [adjuster1.stl, adjuster2.stl, adjuster3.stl, cone-tip.stl, flange-assembly.stl, inner-assembly.stl, innerShieldAndFlange.stl, lead-shield.stl]
2024-12-11 cad_downstream_beamline condensed into cad
    [Apex_Shield_Lead_Fill.stl, Apex_Shield_PCAL_Hub.stl, Downstream_Beam_tube_Segment_1.stl, Downstream_Beam_tube_Segment_2.stl, Torus_Beam_Tube_Reducer_2.stl, Torus_Exit_Shield_Casing.stl, Torus_Exit_Shield_Lead_Fill.stl, downstream_beamline.stp]
2024-12-11 condensed cadBeamlineELMO into cad using new cad import
    [innerShieldAndFlange.stl, nut1.stl, nut2.stl, nut3.stl, nut4.stl, nut5.stl, nut6.stl, nut7.stl]
2024-12-11 transverseTargetMagnets to cad_transverse using new cad import
    [TGT-9000-1000-0000_MIRm.stl, TGT-9000-1000-0000m.stl, TGT-9000-1000-0001_MIR1m.stl, TGT-9000-1000-0001m.stl, TGT-9000-1000-0002_MIR1m.stl, TGT-9000-1000-0002m.stl, TGT-9000-1000-0003m.stl, TransverseMagnetForwardWedges.stp]
2024-12-20 fix script and we need to recompile gemc cause of new cad mechanism
2025-01-02 removing magnets from gcard and using common functions for geo/output comparison
2025-01-07 using default instead of original variation for htcc
    [htcc__parameters_default.txt]
2025-01-10 removing deprecated actions, fixed version switch on env
2025-01-10 adding ctof to sqlite DB, ctof sqlite gcard
    [ctof__parameters_default.txt]
2025-01-15 removing obsolete changelog files, making gcards more consistent, fixed ctof gxml files, spreading more theta in the central detectors. doubling number of events. adding cnd to CI
    [cnd__parameters_default.txt]
2025-01-17 alert changes, updated notes
    [ahdc__parameters_default.txt, ahdc__parameters_rga_fall2018.txt, atof__parameters_default.txt, atof__parameters_rga_fall2018.txt]
2025-01-30 updating alert geo and adding recoil
    [ahdc__parameters_default.txt, ahdc__parameters_rga_fall2018.txt, atof__parameters_default.txt, atof__parameters_rga_fall2018.txt]
2025-01-30 adding geometry source. temp disabling clas12 validation
    [80KCan_Al.stl, 80KCan_SS.stl, AdditionalWindows.FCStd, AdditionalWindows.stp, Aluminum.stl, Apex_Shield_Lead_Fill.stl, Apex_Shield_PCAL_Hub.stl, Band.stl]
2025-02-07 micromegas added to sqlite. fixes to rgf / rgm geometries. variation name changes for michel and slim, to rga and rgm. removed readme from experiment db. added micromegas to ci
    [micromegas__parameters_rga_spring2018.txt, micromegas__parameters_rgm_winter2021.txt, micromegas__parameters_slim.txt]
2025-02-07 moved rgm fmt downstream by 2mm - matching rga - to avoid overlap of closing plates
    [micromegas__parameters_rgm_winter2021.txt]
2025-02-10 PERL API improved in handling of empty strings, Fixed materials for LTCC WC
2025-02-11 added rich to sqlite db, checking all detectors in CI
    [rich__parameters_original.txt]
2025-02-12 fixed cad api mfield default value, removed old stl ltcc volumes from gxml, sqlite cad factory only adds valid stl filenames, added summary table in ci
2025-02-17 improved sensitivity log, fixed sqlite hit definitions loading
    [gbank.cc]
2025-02-18 replaced fall2018 variations with spring2018 for system ftof, ec, pcal and rich
    [RICH_mother_corrected.stl, ftof__parameters_rga_spring2018.txt]
2025-02-26 bstshield integrated in bst. beamline cad added to sqlite
2025-03-06 fixed api to account for a single dir to produce multiple systems. added magnets to sqlite
2025-03-06 dc mismatch was not fixed. added magnets and beamline to both geo comparison and run comparison
2025-03-06 fixed gemc run script and added magnets solenoid variations for its positioning
2025-03-06 using full paths for cad in sqlite
2025-03-07 added missing magnets gxml variations. testing a few more detectors. fixed final summary table
2025-03-07 using ft default variation for beamline and magnets
2025-03-12 Update factory.groovy
    Changed case from all upper to all lower for directory name of where RecoilGeant4Factory is located
2025-04-02 fixed ddccs r3 shielding and flux det. fixed alert alertAhdcTDCSchema
    [hipoSchemas.cc]
2025-04-02 doc: fix a couple typos
    (and test PR rules)
2025-04-07 switching default ddvcs material to lead
2025-04-10 change AHDC::wf to 30 samples
2025-04-10 fixed material error in ddvcs - added ddvcs to gcards to test
2025-04-11 micromegas fmt.pl typo and using coatjava 12.0.3t for new alert wf
    [ltcc__parameters_original.txt]
2025-04-11 saving progress and starting a new workflow
    [target__parameters_default.txt, target__parameters_pbTest.txt, target__parameters_rga_fall2018.txt, target__parameters_rga_spring2018.txt]
2025-04-15 adding custom target variations, fix names for dev main workflow
    [target__parameters_ND3.txt, target__parameters_hdice.txt, target__parameters_longitudinal.txt, target__parameters_pbtest.txt, target__parameters_transverse.txt]
2025-04-16 work in progress for real run numbers. renaming first variations to experiments
    [MEOP_CLAS12.stp, TargetFoam.stl, TargetFoam2.stl, TargetFoam3.stl, TargetVacuumWindow50umAl.stl, TargetWindowAdapterTorlon.stl, beam_window.stl, deverter.stl]
2025-04-16 explicit longitudinal name
    [MEOP_CLAS12.stp, TargetFoam.stl, TargetFoam2.stl, TargetFoam3.stl, TargetVacuumWindow50umAl.stl, TargetWindowAdapterTorlon.stl, beam_window.stl, deverter.stl]
2025-04-16 using stl array to silence warnings
2025-04-17 target standard cad files
2025-04-17 added targets gcards for various experiments
    [target__parameters_ND3.txt, target__parameters_hdice.txt, target__parameters_longitudinal.txt, target__parameters_transverse.txt]
2025-04-17 adding geometry for first experiments
    [target__parameters_rgb_spring2019.txt]
2025-04-17 removed transient files for ctof
    [MEOP_CLAS12.stp, TargetFoam.stl, TargetFoam2.stl, TargetFoam3.stl, TargetVacuumWindow50umAl.stl, TargetWindowAdapterTorlon.stl, beam_window.stl, deverter.stl]
2025-04-17 added targets experiments
    [target__parameters_rga_fall2019.txt, target__parameters_rgb_fall2019.txt]
2025-04-17 adding pars and gcards for various targets
    [target__parameters_rga_spring2019.txt, target__parameters_rgb_fall2019.txt]
2025-04-18 rgf bonus target and starting rgm
    [target__parameters_rgf_spring2020.txt]
2025-04-18 rga rgb rgf real run number targets, starting rgm, various api fixes and improvements
    [target__parameters_rgf_spring2020.txt]
2025-04-22 adding reading sqlite file from GEMC_DATA_DIR, moving micromegas rga_spring2018 to default
    [micromegas__parameters_default.txt]
2026-06-12 cambi di frede 6.12
2026-07-29 cambi di frede 29/7
